burksbuilds/CNC-Router/Renders/2022-01-19/CNC-ISO2.png

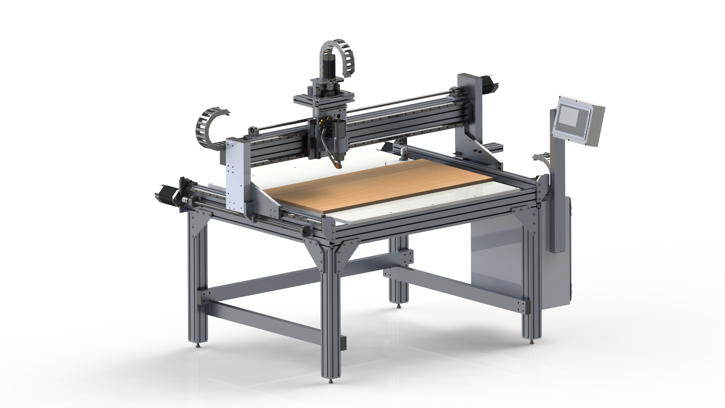
Renders/2022-01-19/CNC-ISO2.png
