burksbuilds/CNC-Router/Controls/Controls Scratchpad.pptx

## Plan

- Major Component Selection / Requirements
- Circuit Protection / High Level Schematic
- Safety Third (E-Stop)
- Heat Calcs / Cooling
- Detailed Power Distro and Terminals
- Layout

## Major Component Selection / Requirements

- Power Supplies
  - Requirement: 25A at 72VDC
    - Why? Steppers need 72VDC 5A each (Four required, fifth planned spare)
    - Planning on 3x 24VDC power supplies in series
      - PSP-600-24 good price per amp and not too inefficient
  - Requirement: 5A + 3A at 24VDC
    - Why? Controller needs 2 separate 24VDC 3A power supplies (Logic and IO separate)
    - Why? 24VDC relay to turn on/off air solenoid from output (2 relays 1A each at 24VDC should be plenty)
    - Planning on 2x 24VDC power supplies (one for IO and one for Logic+Relays)
      - EDR-150-24 is 6.5A, so plenty of current and cost different up from 4A only $1

## Circuit Protection / High Level Schematic

30A house breaker (10 awg) 240V

Disconnect (32A)
466150 (https://www.alliedelec.com/product/rs-pro-by-allied/466150/70822676/)

10

10

10

15A breaker
2907662 (https://www.phoenixcontact.com/online/portal/us/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)
faz-d15-2-na-l (https://www.automationdirect.com/adc/shopping/catalog/circuit_protection_-z-_fuses_-z-_disconnects/ul_489_miniature_circuit_breakers/eaton_240vac_miniature_ci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)

6-16A breaker
(10A 2907591 (https://www.phoenixcontact.com/online/portal/us/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)
faz-c10-2-na-l (https://www.automationdirect.com/adc/shopping/catalog/circuit_protection_-z-_fuses_-z-_disconnects/ul_489_miniature_circuit_breakers/eaton_240vac_miniature_ci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))

10-16A breaker
(15A 2907594 (https://www.phoenixcontact.com/online/portal/us/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)
16A GMCBU-2C-16 (https://www.automationdirect.com/adc/shopping/catalog/circuit_protection_-z-_fuses_-z-_disconnects/ul_489_miniature_circuit_breakers/gladiator_miniature_circu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))

14

Spindle VFD

3 hp spindle (9.6 FLA)

18

14

24V 6A Power Supply

24V 6A Power Supply

Input Power (3A CB) gmcb-1c-3 (https://www.automationdirect.com/adc/shopping/catalog/circuit_protection_-z-_fuses_-z-_disconnects/ul_1077_supplementary_protectors/gladiator_ul_1077_suppleme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)

Stepper Drives (72V)
USCC1 (https://www.grainger.com/product/MERSEN-Finger-Safe-Fuse-Block-4ZCP6) for CC fuses
Class G fuse terminal blocks
1044423 (https://www.phoenixcontact.com/online/portal/us/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) with jumper (https://www.phoenixcontact.com/online/portal/us/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)
6A FUSE (https://www.alliedelec.com/product/littelfuse/ag6/70347898/)

Control Power (3A CB x2) gmcb-1c-3 (https://www.automationdirect.com/adc/shopping/catalog/circuit_protection_-z-_fuses_-z-_disconnects/ul_1077_supplementary_protectors/gladiator_ul_1077_suppleme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)

10

14 / 10?

24V 25A Power Supply

24V 25A Power Supply

24V 25A Power Supply

## Safety Third (E-Stop)

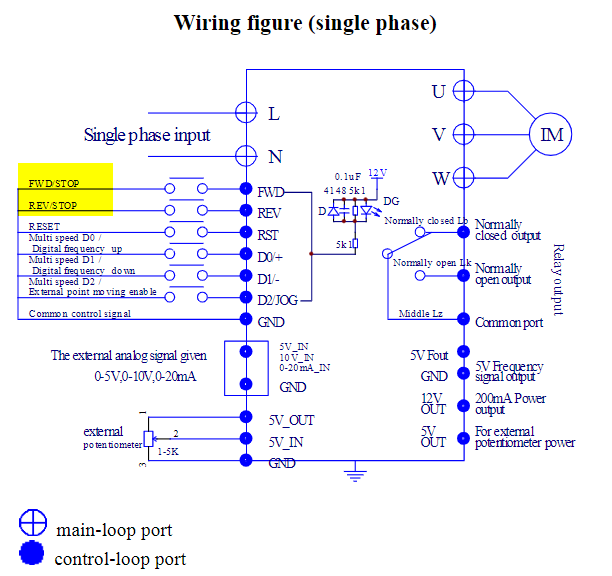
[picture p2: figure]

- Controller EStop is software (does not have an estop output), so you don’t directly know when it's buttons are pressed
- What should estop do?
  - Stop spindle, stop servos
  - Remote estop input for controller
- VFD has estop input
- Big power supplies have a jumper that you can remove to turn them off

## Heat Calcs / Cooling

- Max temp things are okay with:
  - VFD: 40C
  - Power supplies: 60C
  - Drives: 50C
- Summary
  - 620W of heat to dissipate
  - 600x600x300 cabinet (dissipates ~65W, calc has a 250mm depth cabinet)
  - Assumption: Max internal temp 40C, max external temp 30C, altitude 250-499m, Single enclosure, free-standing on all sides
  - Necessary air throughput: 185 m3/h

## Detailed Power Distro and Terminals

## Layout

Y2

Y1

Y2 0

Y1 0

X0

Y+

Y-

prox

slot

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
## Slide 9
