burksbuilds/CNC-Router/Controls/CNC_electrical.xlsx

Sheet: Sheet1
 |  |  |  | Heat | PXC |  |  |  | HRP-600-24 | 3.6 | 240 | 105 | 63.5
24V Power Supply | EDR-150-24 | Input 1.7A/230V | Output 6.5A/24V | 20.28 | 10 | 6-16A breaker | 2 | 40.56 | PSP-600-24 | 3.4 | 185 | 120 | 93
Motor Power Supplies | PSP-600-24 | Input 3.4A/230V | Output 25A/24V | 84 | 28 | 10-16A | 3 | 252 | SE-600-24 | 7.5 | 264 | 127 | 50
Stepper Driver | CL86T(V3.0) |  |  | 12.96 |  |  | 5 | 64.8
 | VFD |  |  | 260.995 |  |  | 1 | 260.995
 |  |  |  |  |  |  |  | 618.355
 |  |  |  |  | 679
 |  |  |  |  |  |  |  |  |  |  |  |  |  | AWG | Current
 |  |  |  |  |  |  |  |  |  |  |  |  |  | 20 | 5
 |  |  |  |  |  |  |  |  |  |  |  |  |  | 18 | 7
32A Disconnect |  | RS Pro by Allied - 466150 - Disconnect Switch Non-Fused 32A 750VAC IP65 3 Pole Panel Mount UL508 CSA - Allied Electronics & Automation (https://www.alliedelec.com/product/rs-pro-by-allied/466150/70822676/) |  |  |  |  |  |  |  |  |  |  |  | 16 | 10
 |  |  |  |  |  |  |  |  |  |  |  |  |  | 14 | 15
 |  |  |  |  |  |  |  |  |  |  |  |  |  | 12 | 20
 |  |  |  |  |  |  |  |  |  |  |  |  |  | 10 | 30
Spindle 3hp | 9.6A FLA | 20A breaker

Sheet: BOM Cost Est
Disconnect | Allied |  | RS Pro by Allied - 466150 - Disconnect Switch Non-Fused 32A 750VAC IP65 3 Pole Panel Mount UL508 CSA - Allied Electronics & Automation (https://www.alliedelec.com/product/rs-pro-by-allied/466150/70822676/) | 1 | 20.48 | 20.48
TMC82C 15A | Allied | gmcbu-2c-15 | https://www.alliedelec.com/phoenixcontact-2907594/70903630/ | 2 | 40.85 | 81.7 |  | Fuse | 1 | 2907594 | 2
TMC82C 10A | Automation Direct | gmcbu-2c-10 | https://www.automationdirect.com/adc/shopping/catalog/circuit_protection_-z-_fuses_-z-_disconnects/ul_489_miniature_circuit_breakers/gladiator_miniature_circu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 | 1 | 26 | 26 |  |  |  | 2907591 | 1
Fuse Terminal 1044423 | Allied/Mouser |  |  | 5 | 11.28 | 56.4 | or digikey CYDLF4 |  |  | 1044423 | 5
Terminal Jumper 3001596 | Allied |  |  | 1 | 2.39 | 2.39 |  |  |  | 3001596 | 1
Terminal Jumper 3030349 | Allied |  |  | 1 | 2.94 | 2.94 |  |  |  | 3030349 | 1
Fuses 6A G Class | digikey, mouser | 0487008.MXP |  |  | 1.26 | 0
25A Power supply | TRC |  | https://www.trcelectronics.com/View/Mean-Well/PSP-600-24.shtml | 3 | 151 | 453
6A Power Supply | TRC |  | https://www.trcelectronics.com/View/Mean-Well/EDR-150-24.shtml | 2 | 31.4 | 62.8
3A CBs | Automation Direct | GMCB-1C-3 | https://www.automationdirect.com/adc/shopping/catalog/circuit_protection_-z-_fuses_-z-_disconnects/ul_1077_supplementary_protectors/gladiator_ul_1077_suppleme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 | 3 | 7 | 21
Filter | Automation Direct | res10f10 | https://www.automationdirect.com/adc/shopping/catalog/power_products_(electrical)/power_line_filters/roxburgh_1-phase_general_purpose_power_line_emi_-z-_rf_fi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 | 1 | 14 | 14
Cable Entry | Allied, digikey, mouser | 1415240 |  | 1 | 20 | 20
Rail |  |  |  | 1 | 5.8 | 5.8
Duct |  |  |  | 1 | 28 | 28
 |  |  |  |  |  | 794.51

Sheet: POs
TRC Electronics | 536.83
Allied | 134.32
Automation Direct | 174.27
Digikey | 123.23
Vevor/Walmart | 200
AliExpress | 50 | ?
Amazon | 99.63 | (including crimp tool/ferrules)
McMaster | 101.6
Amazon VFD | 134
 | 1553.88

Sheet: IO
Inputs | Enable | Pin | Polarity |  |  | Num Wires | Outputs | Enable | Pin | Polarity
X-axis servo alarm signal | 1 | 1 |  | Limit Switches | 10 | 3 | Spindle forward rotation control signal | 1 |  |  | M8/M89 | Coolant andvacuum relays
Y-axis servo alarm signal | 1 | 2 |  | Servo Alarm | 5 | 2 | Spindle reverse rotation control signal |  |  |  | M10/M11
Z-axis servo alarm signal | 1 | 3 |  | Spindle Alarm | 1 |  | Spindle section speed 1 |  |  |  | Might need system ready to sent to drives for enable
Spindle alarm signal | 1 | 4 |  | Fixed Probe | 1 |  | Spindle section speed 2 |  |  |  | gantry homing thing
5th-axis servo alarm signal |  |  |  | Floating Probe | 1 |  | Spindle section speed 3
Negative X-axis hard limit signal | 1 | 5 |  | Tool Changer | 4 |  | M8/M9 control signal (coolant)
Negative Y-axis hard limit signal | 1 | 6 |  | Estop | 1 |  | M10/M11 control signal
Negative Z-axis hard limit signal | 1 | 7 |  |  |  |  | System alarm signal
Negative 4th-axis hard limit signal |  |  |  |  |  |  | System Running signal
Negative 5th-axis hard limit signal |  |  |  |  | 23 |  | System Brake signal
Positive X-axis hard limit signal | 1 | 8 |  |  |  |  | System ready signal | 1
Positive Y-axis hard limit signal | 1 | 9 |  |  |  |  | Tool release/lock signal (M154/M155) | 1
Positive Z-axis hard limit signal | 1 | 10 |  |  |  |  | Tool lauch/retract signal (M152/M153) | 1
Positive 4th-axis hard limit signal |  |  |  |  |  |  | Front positioning/off signal (M156/M157)
Positive 5th-axis hard limit signal |  |  |  |  |  |  | Vacuum pump on/off output signal (M158/M159)
X-axis Zero Signal | 1 | 11 |  |  |  |  | Dust cover open/close output signal (M150/M151)
Y-axis Zero Signal | 1 | 12 |  |  |  |  | Push cylinder open/close output signal (M160/M161)
Z-axis Zero Signal | 1 | 13 |  |  |  |  | Vacuum cleaner on/off output signal (M162/M163) | 1
4th-axis Zero Signal | 1 | ? |  |  |  |  | Left positioning on/off output signal (M164/M165)
5th-axis Zero Signal |  |  |  |  |  |  | Vacuum valve open/close output signal (M166/M167)
Floating Probe signal | 1 | 14 |  |  |  |  | Multi-process 1 Open/close output signal (M168/M169) | 1
Fixed Probe signal | 1 | 15 |  |  |  |  | Multi-process 2 Open/close output signal (M170/M171)
External key 1 |  |  |  |  |  |  | Multi-process 3 Open/close output signal (M172/M173)
External key 2 |  |  |  |  |  |  | Multi-process 4 Open/close output signal (M174/M175)
External key 3 |  |  |  |  |  |  | Cooling 1 on/off output signal (M176/M177) | 1
External key 4 |  |  |  |  |  |  | Cooling 1 on/off output signal (M178/M179)
External key 5
External key 6
External Start |  |  |  |  |  |  |  | 7
External Pause
External Estop | 1 | 24
Spindle Stop Signal (M300) |  | 16
Tool release input signal (M301) | 1 | 17
Tool lock input signal (M302) | 1 | 18
Tool open input signal (M303) | 1 | 19
Dust cover open/close input signal (M305/M306)
Inverter Alarm input signal
Customs alarm input signal 1 | 1 | ?
Customs alarm input signal 2
Customs alarm input signal 3
Customs alarm input signal 4
Customs alarm input signal 5
Tool close input signal (M304) | 1 | 20
 | 22

Sheet: PXC
 | PN | ALT | QTY
Din Rail | 1207658 |  | 1 | https://www.phoenixcontact.com/online/portal/us/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
Cable Gland | 1415240 |  | 1 | https://www.phoenixcontact.com/online/portal/us/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
Duct 40mmx80 | 3240626 |  | 1 | https://www.phoenixcontact.com/online/portal/us/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
Duct 40mmx100 | 3240627 |  | 1 | 3240627 (https://www.phoenixcontact.com/online/portal/us/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)
Duct Cover | 3240647 |  | 1 | https://www.phoenixcontact.com/online/portal/us/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
Duct 60mmx80 | 3240630 |  | 1 | 3240630 (https://www.phoenixcontact.com/online/portal/us/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)
Duct 60mmx100 | 3240631 |  | 1 | 3240631 (https://www.phoenixcontact.com/online/portal/us/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)
Duct Cover | 3240648 |  | 1 | PHOENIX CONTACT | Cable duct - CD 60X80 WH - 3240630 (https://www.phoenixcontact.com/online/portal/us/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)
2 level tb | 3214657 | 3208511 | 20 | https://www.phoenixcontact.com/online/portal/us/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
2 level cover | 3214699 | 3208579 | 1 | https://www.phoenixcontact.com/online/portal/us/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
3 level tb | 3213726 | 3213713 | 10 | https://www.phoenixcontact.com/online/portal/us/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
3 level cover | 3113771 |  | 1 | https://www.phoenixcontact.com/online/portal/us/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
10jumper | 3213056 |  | 2 | https://www.phoenixcontact.com/online/portal/us/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
20jumper | 3213069 |  | 1 | https://www.phoenixcontact.com/online/portal/us/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
Fuse TB | 1044423 |  | 5 | PHOENIX CONTACT | Fuse modular terminal block - UT 4-L/HESI (5X20) GY - 1044423 (https://www.phoenixcontact.com/online/portal/us/pxc/offcontext/search_result_page/!ut/p/z1/5Vhbb9owFP4r9IFHYyeOEzJpD0DRWgot163hJXIch3rLbYmhW3_9HEi1pltJtQpNapC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)
Fuse TB jumpers | 3001596 |  | 5 | https://www.phoenixcontact.com/online/portal/us/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
Fuse TB jumpers | 3030349 |  | 5 | https://www.phoenixcontact.com/online/portal/us/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
TMC 82C 15A | 2907594 |  | 2 | https://www.phoenixcontact.com/online/portal/us/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
TMC 82C 10A | 2907591 |  | 1 | PHOENIX CONTACT | Thermomagnetic device circuit breaker - TMC 82C 10A - 2907591 (https://www.phoenixcontact.com/online/portal/us/pxc/offcontext/search_result_page/!ut/p/z1/5VjJcuIwEP0V5sBpSkiyvHFkG5YAYZ1gLi7Zlokm3mIbkvD1IwOphEwwqVAcpkypylq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)
TMC 71C 3A | 1019974 |  | 3 | 1019974 (https://www.phoenixcontact.com/online/portal/us/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)
gnd quattro | 3211809 |  | 4 | https://www.phoenixcontact.com/online/portal/us/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
quattro end cover | 3208979 |  | 2 | https://www.phoenixcontact.com/online/portal/us/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
0v distro | 1046949 |  | 1 | https://www.phoenixcontact.com/online/portal/us/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
3210596 (https://www.phoenixcontact.com/online/portal/us/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)

Sheet: Wire
 |  |  | OD | FT (MIN) | PPF
Power Cable 10-3 | Automation Direct | SJEOOW |  | 20 | 1.79 | 35.8 |  | AWG | Color | Quantity
Power Cable 10-3 | McMaster | SJEOOW | 0.57" | 10 | 2.6 | 26 |  | 10 | Black | 6
 |  |  |  |  |  | 0 |  |  | Green | 2
10AWG Black | McMaster | THHN |  | 10 | 0.53 | 5.3 |  |  | Blue | 3
 | McMaster | MTW |  | 10 | 0.64 | 6.4 |  |  | White/Blue | 2
 | Grainger | THHN |  | 50 | 0.6024 | 30.12 |  | 14 | Black | 14
 | Grainger | MTW |  | 500 | 0.4 | 200 |  |  | Green | 10
 | Automation Direct | THHN |  | 500 | 0.498 | 249 |  |  | Blue | 10
 | Lowes/Home Depot | THHN |  | 500 | 0.278 | 139 |  |  | White/Blue | 10
 |  |  |  | 100 | 0.5128 | 51.28 | (have some smaller lengths too 50ft / $27) | 18 | Blue | 45
 |  |  |  |  |  |  |  |  | WhiteBlue | 45
Ground bar | EC3GB212
18AWG Wire Blue | McMaster | MTW |  | 25 | 0.19 | 4.75
 | Grainger | MTW |  | 500 | 0.11486 | 57.43
 |  |  | 300V | 100 | 0.3039 | 30.39
 | Allied | MTW |  | 100 | 0.3625 | 0.3625

Sheet: Cable
Cables HMI to Cabinet | Num Conductors | AWG | OD (in) | OD (mm) | PN
Inputs | 25 | 20 | 0.498 | 12.6492 | CC600-20-25U-1 (https://www.automationdirect.com/adc/shopping/catalog/cables/bulk_multi-conductor_cable/600v_control_cable/cc600-20-25u-1)
Outputs | 12 | 20 | 0.33 | 8.382 | CF880-05-12 (https://www.igus.com/search?q=CF880-05-12)
Power and Ground | 5 | 20 | 0.26 | 6.604 | CF880-05-05 (https://www.igus.com/search?q=CF880-05-05)
Drives (5) | 4 | 24 | 0.235 | 5.969 | Q8504-1 (https://www.automationdirect.com/adc/shopping/catalog/cables/bulk_multi-conductor_cable/rs-485_-a-_rs-422-z-rs-232_cable/q8504-1)
VFD | 7 | 18 | 0.321 | 8.1534 | CC600-18-7S-1 (https://www.automationdirect.com/adc/shopping/catalog/cables/bulk_multi-conductor_cable/600v_control_cable/cc600-18-7s-1)
VFD to Spindle | 4 | 16 | 0.39 | 9.906 | CF270-UL-D (https://www.igus.com/product?artNr=CF270-UL-15-04-D)
Power Cable 10-3 | 3 | 10 | 0.57 | 14.478
Cables from Machine | Qty Cables |  | OD (in) | OD (mm)
CN-14A-R-C5, home | 3 |  | 0.1456692913 | 3.7
CN-14A-C2 | 1 |  | 0.1456692913 | 3.7
motor | 5 |  | 0.275 | 6.985
encoder | 5 |  | 0.25 | 6.35
limit switches | 6
relay stuff | 6
 | 26
