burksbuilds/CNC-Router/Model/Solidworks CAD and Drawings/CNCR-SPIN.SLDASM

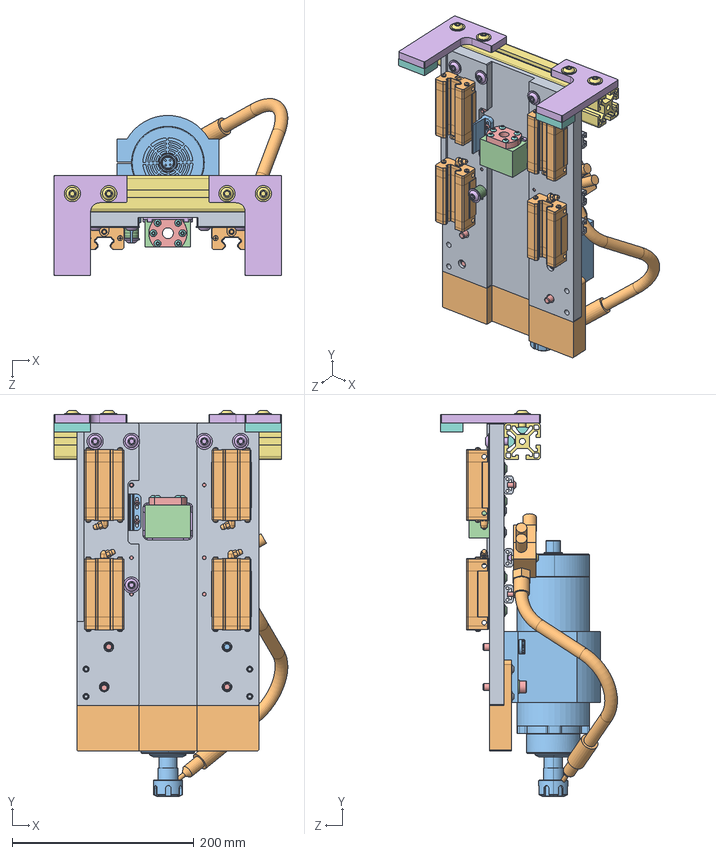
[picture p23: CAD file, 2022-09-07]
Model/Solidworks CAD and Drawings/CNCR-SPIN.SLDASM
256.8 x 424.4 x 194.6 mm
CNCR-SPIN-PLATE
BEARING20 x 4
CNCR-SPIN-CLAMP
BALLNUT12-MOUNT
BALLNUT1204
CNCR-SPIN-HS x 2
CNCR-SPIN-TSE-HSM
CNCR-BUMP x 2
CNCR-SPIN-TSE-AM x 3
CNCR-SPIND-COOL
SPINDLE80
M6x20mm FBHCS x 16
M5x25mm BHCS, 18-8 - 92095A216 x 6
M8x25mm-FBHCS x 5
M8x20mm-FBHCS x 4
M8-TSN40-BALL x 8
M8-M12-INSERT x 5
M8-ENUT
M8-SHLD10x16
M8-WASHER x 11
M8x40mm SHCS, 18-8 - 91292A152 x 3
M5-TSN20-BALL x 2
M5x30mm BHCS, 18-8 - 92095A218 x 2
M4x12mm BHCS x 6
M5x16mm Flanged BHCS, 18-8 - 97654A663 x 8
CNCR-SPIN-SPE
CNCR-HSF
M5-M8-INSERT x 4
M3x12mm-BHCS x 2
CNCR-SPIN-BNM
