burksbuilds/CNC-Router/Model/Solidworks CAD and Drawings/CNCR-STAND.SLDASM

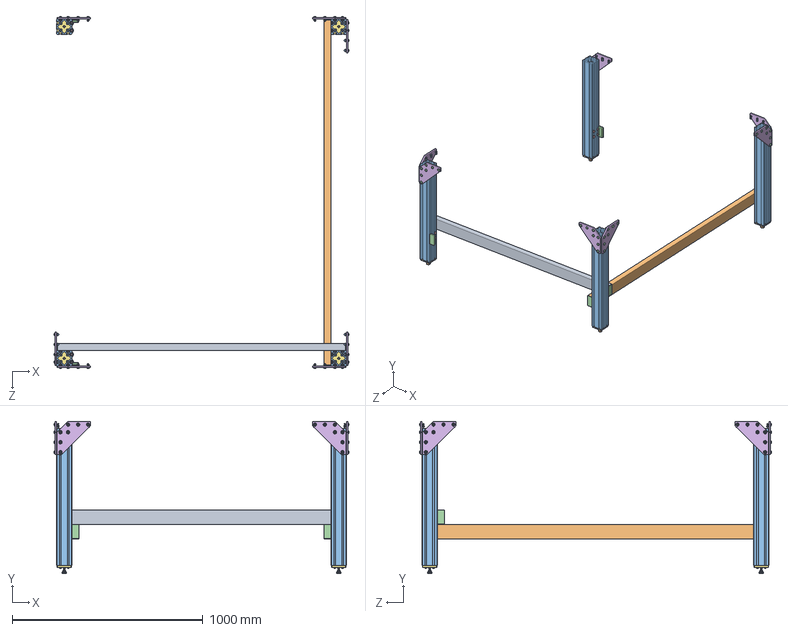
[picture p24: CAD file, 2022-09-07]
Model/Solidworks CAD and Drawings/CNCR-STAND.SLDASM
1547.8 x 800.0 x 1847.8 mm
CNCR-STAND-BS
CNCR-STAND-SS
M8-TSN40-BALL x 73
M8x20mm-FBHCS x 49
M8x12mm-FBHCS x 24
CNCR-STAND-GP x 7
CNCR-STAND-FP x 4
M8-M12-INSERT x 4
M8x25mm-FBHCS x 16
M8-FOOT x 4
CNCR-STAND-TSE-LEG x 4
BOXCOV-3x1,5 x 6
