burksbuilds/CNC-Router/Model/Solidworks CAD and Drawings/CNCR-ELEC-ENC.SLDASM

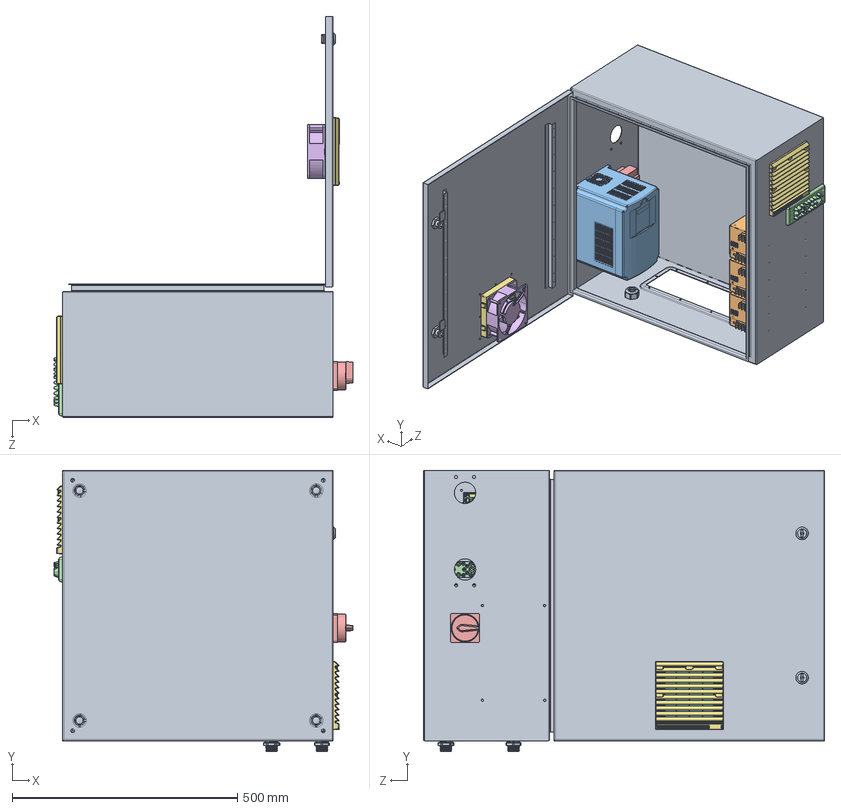
[picture p25: CAD file, 2022-09-07]
Model/Solidworks CAD and Drawings/CNCR-ELEC-ENC.SLDASM
663.2 x 624.3 x 890.0 mm
CNCR-ELEC-BOX
POWER-24VDC-600W x 3
VFD-5HP
CABLE-GLAND25
Disconnect
FAN120
FAN120-FILTER x 2
FAN120-FILTER45 x 2
CORDGRIP-075NPT x 2
