burksbuilds/CNC-Router/Model/Solidworks CAD and Drawings/CNCR-ELEC-COL.SLDASM

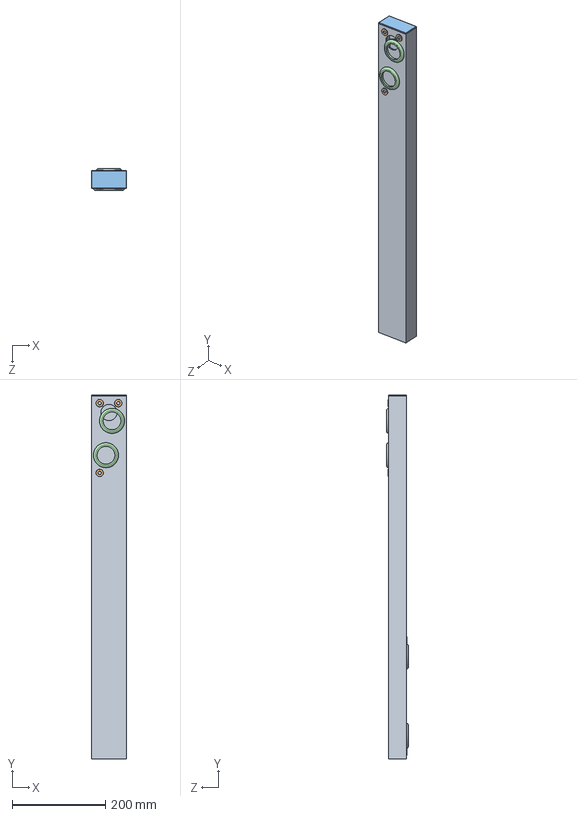
[picture p26: CAD file, 2022-09-07]
Model/Solidworks CAD and Drawings/CNCR-ELEC-COL.SLDASM
76.2 x 782.5 x 47.6 mm
CNCR-ELEC-COL-RT
M6-RIVNUT x 7
BOXCOV-3x1,5
1-50ID Grommet x 4
