burksbuilds/CNC-Router/Model/Solidworks CAD and Drawings/CNCR-GANT-COL-CABLE.SLDASM

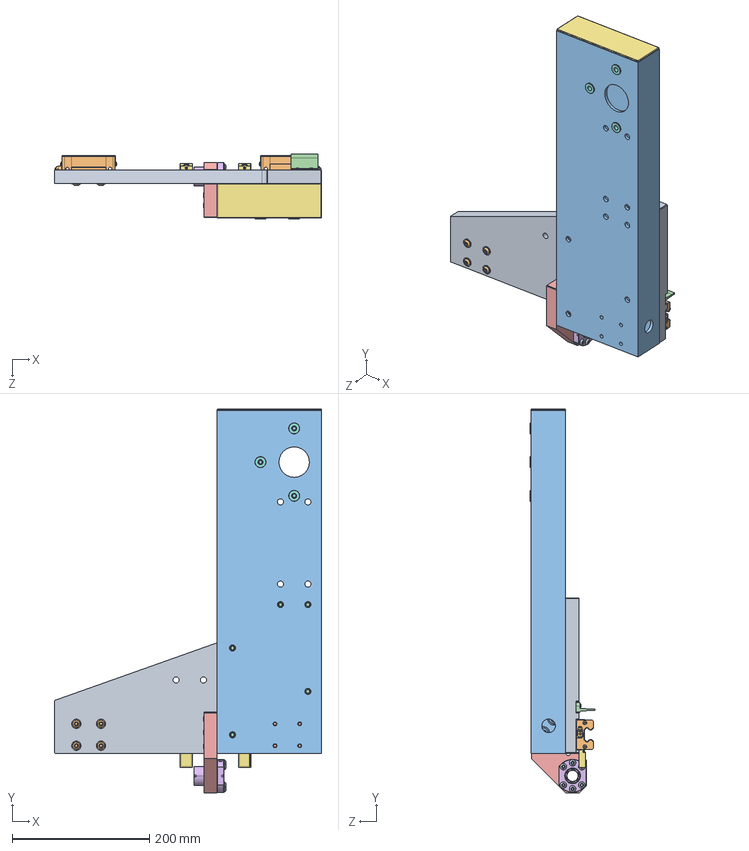
[picture p27: CAD file, 2022-08-01]
Model/Solidworks CAD and Drawings/CNCR-GANT-COL-CABLE.SLDASM
390.0 x 560.5 x 95.4 mm
CNCR-GANT-RP
BEARING20 x 2
CNCR-GANT-RT
CNCR-HSF
CNCR-GANT-BNM
BALLNUT1610
BOXCOV-6x2
M6-RIVNUT x 3
M5x25mm BHCS, 18-8 - 92095A216 x 6
M6x20mm FBHCS x 4
M8x25mm-FBHCS x 3
M8x20mm-FBHCS x 5
M6x25mm FBHCS x 4
M3x12mm-BHCS x 2
PROX-FLAT18 x 2
