burksbuilds/CNC-Router/Model/Solidworks CAD and Drawings/Circuit Breaker, 2 Pole.SLDASM

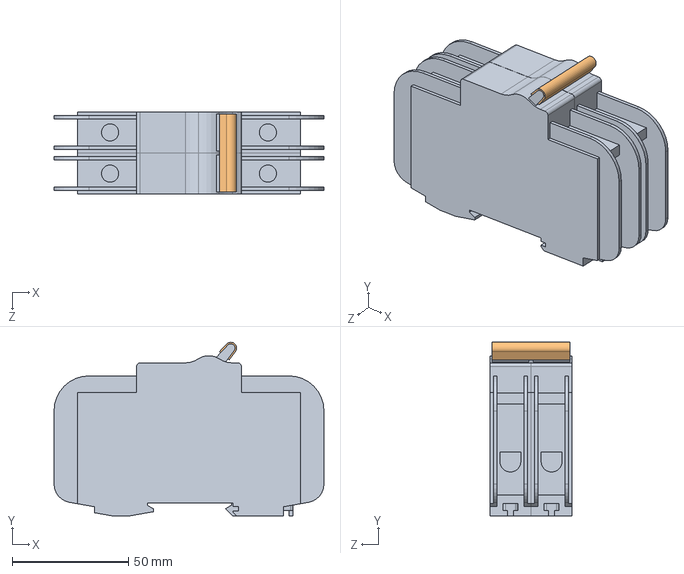
[picture p28: CAD file, 2022-08-01]
Model/Solidworks CAD and Drawings/Circuit Breaker, 2 Pole.SLDASM
116.0 x 74.6 x 35.3 mm
DUMMY_4230_1POLIG_UL489.stp x 2
DUMMY_4230_VERB_2POLIG.stp
