burksbuilds/CNC-Router/Model/Solidworks CAD and Drawings/CNCR-GANT-COL-FREE.SLDASM

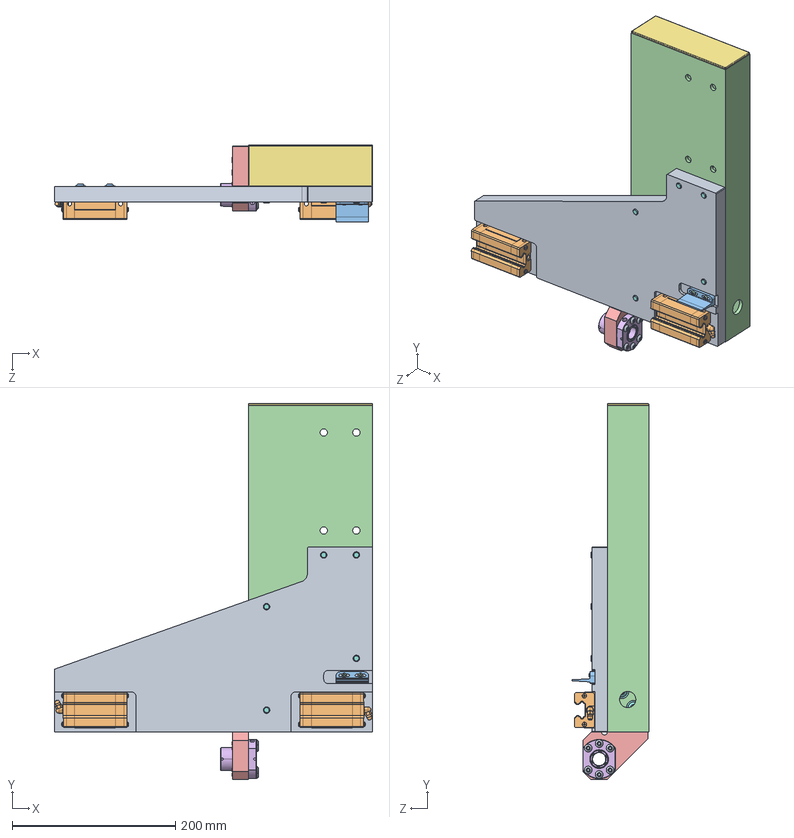
[picture p29: CAD file, 2022-08-01]
Model/Solidworks CAD and Drawings/CNCR-GANT-COL-FREE.SLDASM
390.0 x 460.5 x 93.8 mm
CNCR-GANT-RP
BEARING20 x 2
CNCR-HSF
CNCR-GANT-RT
CNCR-GANT-BNM
BALLNUT1610
BOXCOV-6x2
M8x25mm-FBHCS x 8
M5x30mm BHCS, 18-8 - 92095A218 x 6
M6x25mm FBHCS x 4
M6x20mm FBHCS x 4
M3x12mm-BHCS x 2
