burksbuilds/CNC-Router/Model/Solidworks CAD and Drawings/CNCR-VACT-DUCT.SLDASM

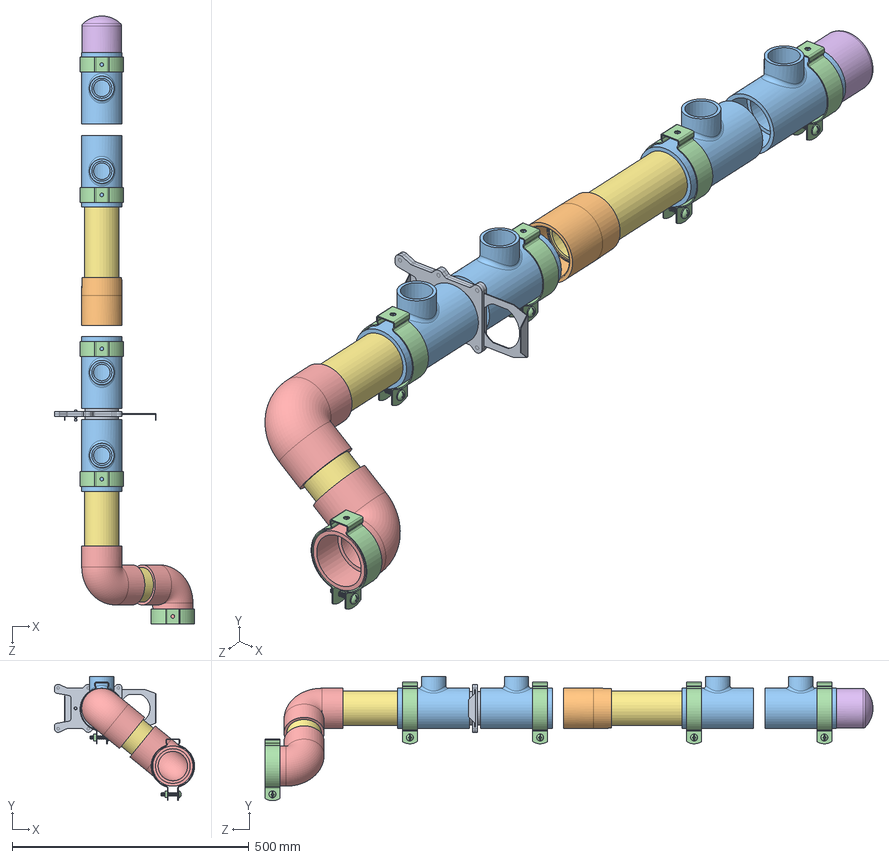
[picture p30: CAD file, 2022-03-06]
Model/Solidworks CAD and Drawings/CNCR-VACT-DUCT.SLDASM
296.0 x 262.4 x 1283.5 mm
3in Blast Gate - 17385K72
2-5in Coupler - 4880K133
2-5in to 1-25 Reducing Tee - 4880K979 x 4
3in Pipe Hanger - 3006T84 x 5
2-5in Elbow - 4880K103 x 2
2-5in Cap - 4880K143
2-5in PVC Pipe, Schedule 40 x 4
