burksbuilds/CNC-Router/Model/Solidworks CAD and Drawings/Reference Piston.SLDASM

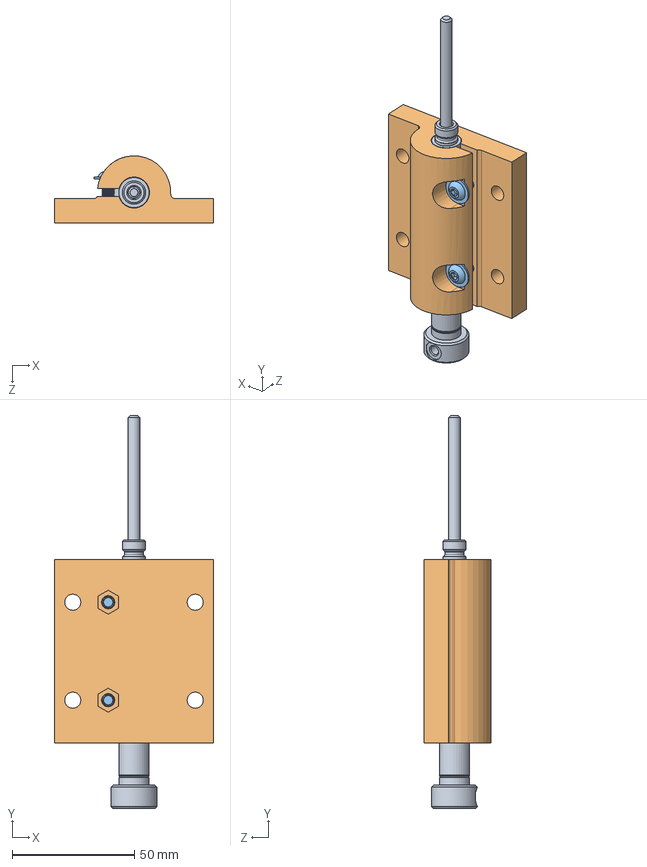
[picture p31: CAD file, 2022-03-06]
Model/Solidworks CAD and Drawings/Reference Piston.SLDASM
65.0 x 160.5 x 27.5 mm
0-7-16 x 1-5in Single Acting Cylinder - Bimba 0115_NTQ
Cylinder Mount
M5x16mm Flanged BHCS, 18-8 - 97654A663 x 2
