burksbuilds/CNC-Router/Model/Solidworks CAD and Drawings/VFD-3HP.SLDPRT

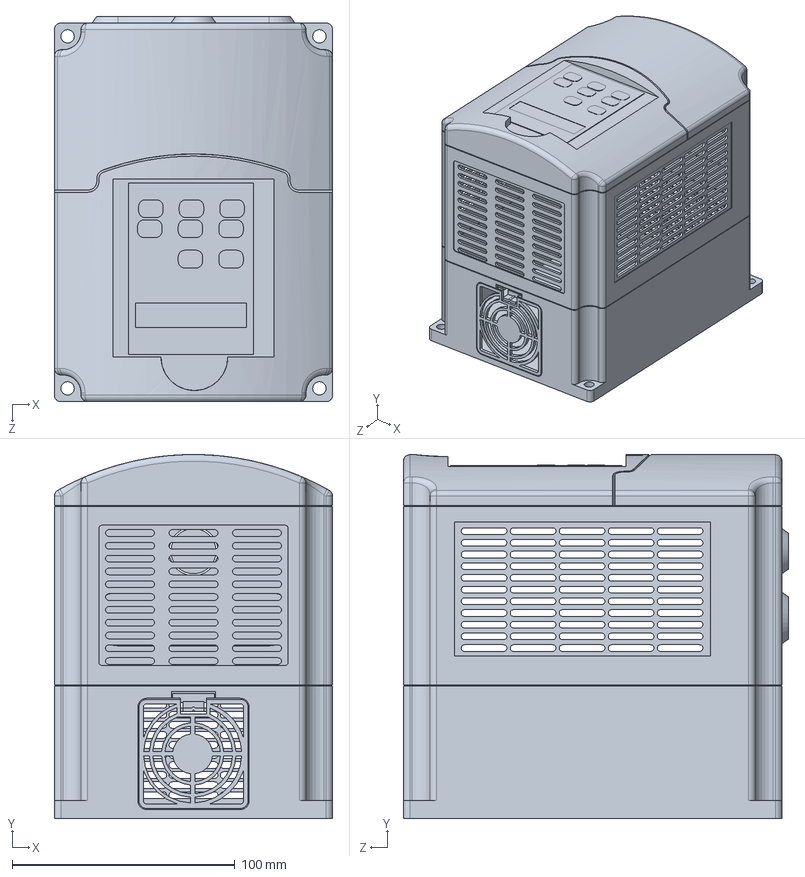
[picture p32: CAD file, 2022-09-07]
Model/Solidworks CAD and Drawings/VFD-3HP.SLDPRT
125.0 x 163.4 x 173.0 mm
