burksbuilds/CNC-Router/Model/Solidworks CAD and Drawings/CNCR-ELEC-HMI.SLDPRT

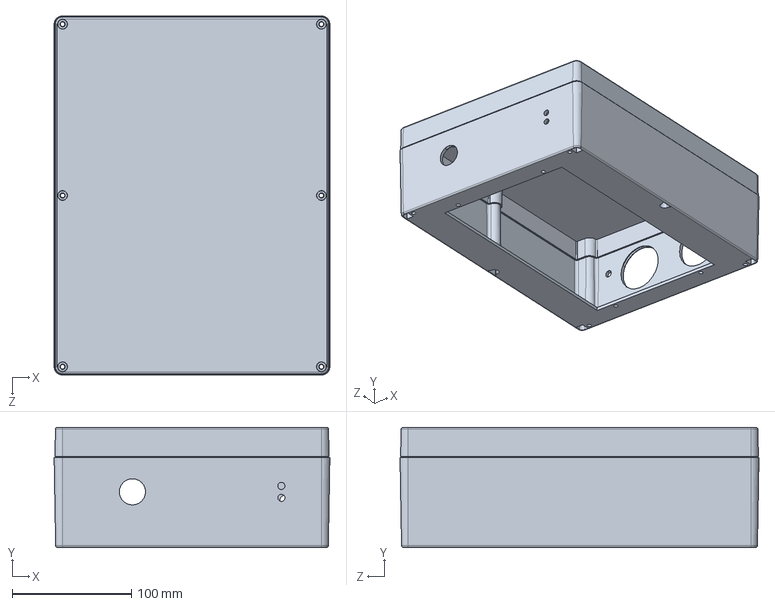
[picture p33: CAD file, 2022-09-07]
Model/Solidworks CAD and Drawings/CNCR-ELEC-HMI.SLDPRT
231.5 x 100.8 x 301.3 mm
