burksbuilds/CNC-Router/Model/Solidworks CAD and Drawings/CNCR-ELEC-COL-RT.SLDPRT

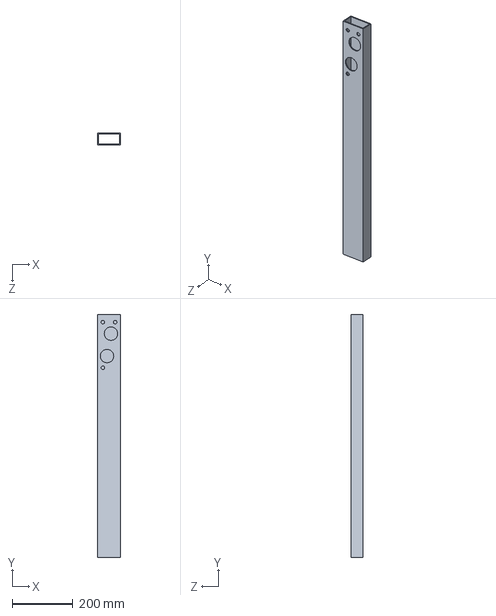
[picture p34: CAD file, 2022-09-07]
Model/Solidworks CAD and Drawings/CNCR-ELEC-COL-RT.SLDPRT
76.2 x 800.0 x 38.1 mm
