burksbuilds/CNC-Router/Model/Solidworks CAD and Drawings/CORDGRIP-075NPT.SLDPRT

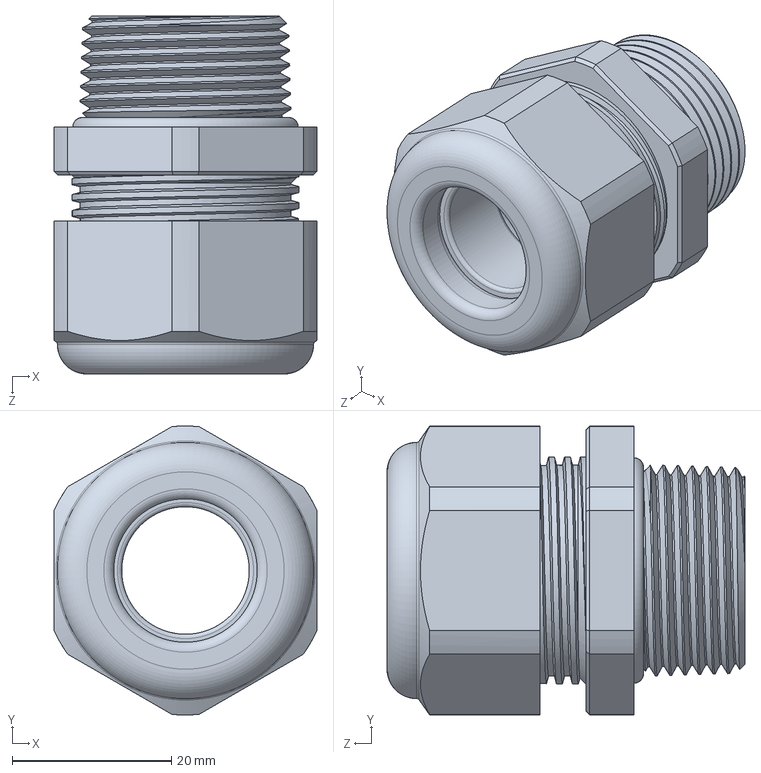
[picture p35: CAD file, 2022-09-07]
Model/Solidworks CAD and Drawings/CORDGRIP-075NPT.SLDPRT
33.0 x 36.3 x 45.0 mm
