burksbuilds/CNC-Router/Model/Solidworks CAD and Drawings/CNCR-ELEC-BOX.SLDPRT

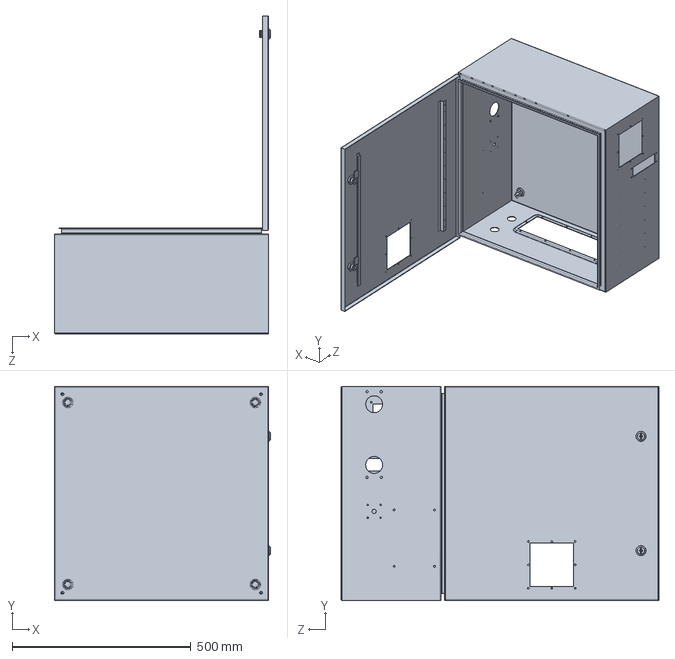
[picture p36: CAD file, 2022-09-07]
Model/Solidworks CAD and Drawings/CNCR-ELEC-BOX.SLDPRT
605.0 x 600.0 x 890.0 mm
