burksbuilds/CNC-Router/Model/Solidworks CAD and Drawings/FAN120-FILTER.SLDPRT

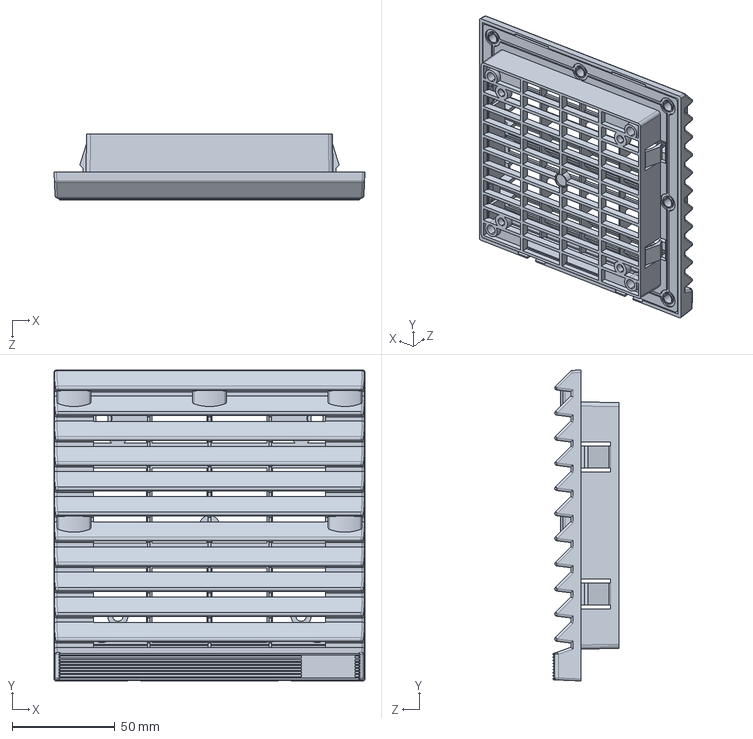
[picture p37: CAD file, 2022-09-07]
Model/Solidworks CAD and Drawings/FAN120-FILTER.SLDPRT
151.0 x 151.0 x 32.0 mm
