burksbuilds/CNC-Router/Model/Solidworks CAD and Drawings/EStop-22.SLDPRT

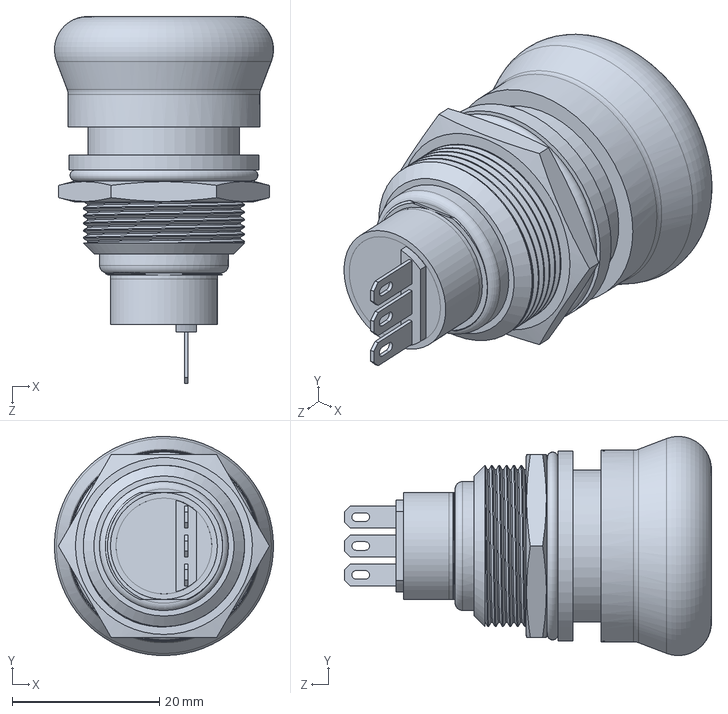
[picture p38: CAD file, 2022-09-07]
Model/Solidworks CAD and Drawings/EStop-22.SLDPRT
29.7 x 29.7 x 49.8 mm
