burksbuilds/CNC-Router/Model/Solidworks CAD and Drawings/BALLNUT1610.SLDPRT

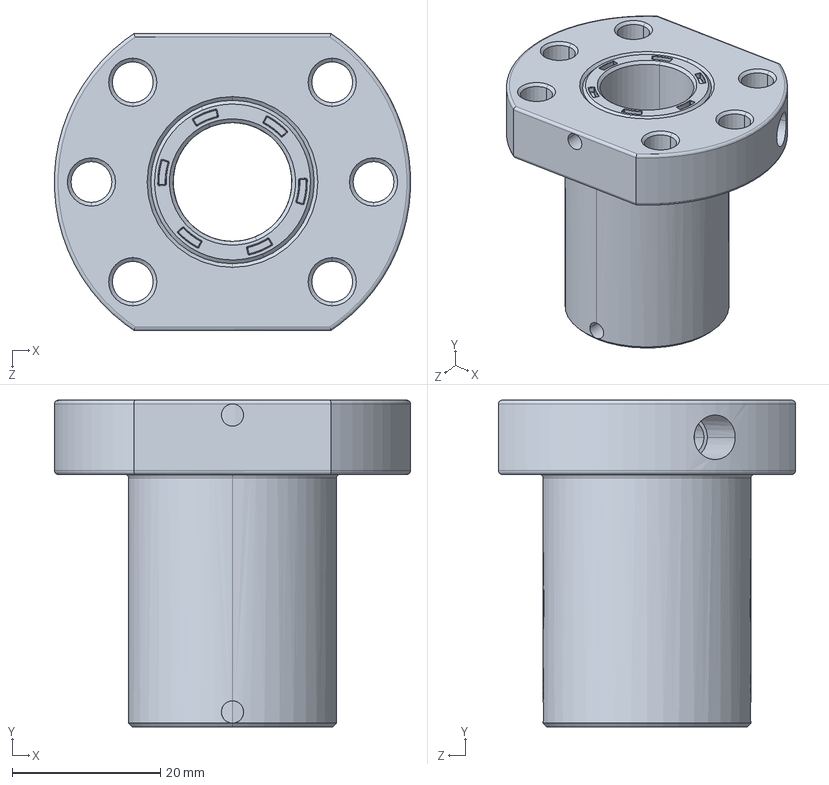
[picture p39: CAD file, 2022-08-01]
Model/Solidworks CAD and Drawings/BALLNUT1610.SLDPRT
48.0 x 44.0 x 40.0 mm
