burksbuilds/CNC-Router/Model/Solidworks CAD and Drawings/LS-TB-Y.SLDPRT

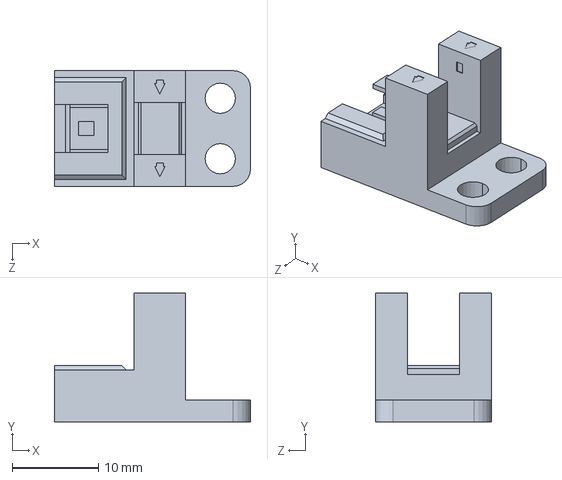
[picture p40: CAD file, 2022-08-01]
Model/Solidworks CAD and Drawings/LS-TB-Y.SLDPRT
22.7 x 14.9 x 13.4 mm
