burksbuilds/CNC-Router/Model/Solidworks CAD and Drawings/EMI-FILT10.SLDPRT

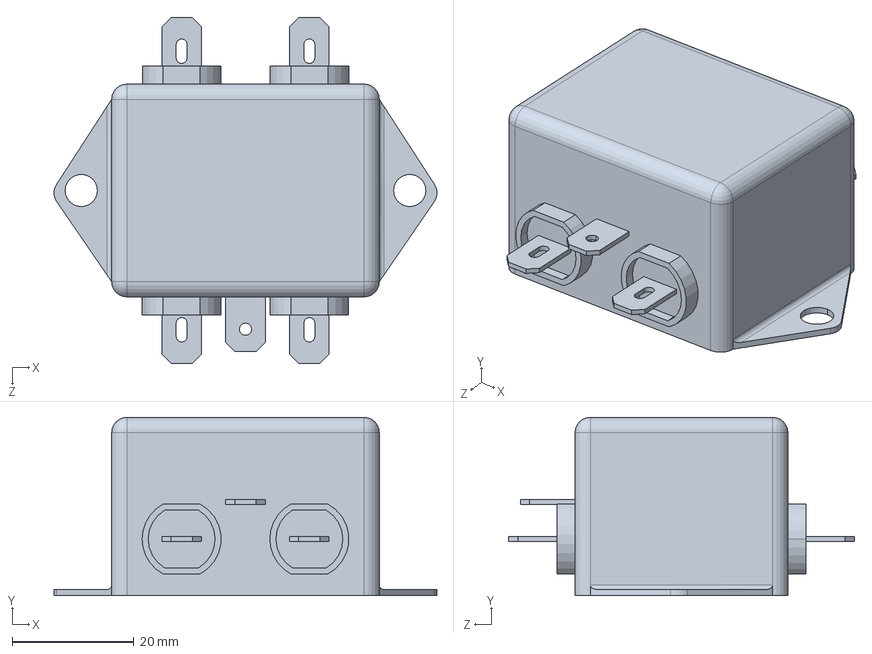
[picture p41: CAD file, 2022-08-01]
Model/Solidworks CAD and Drawings/EMI-FILT10.SLDPRT
63.0 x 29.3 x 56.8 mm
