burksbuilds/CNC-Router/Model/Solidworks CAD and Drawings/CNC-CONTROL.SLDPRT

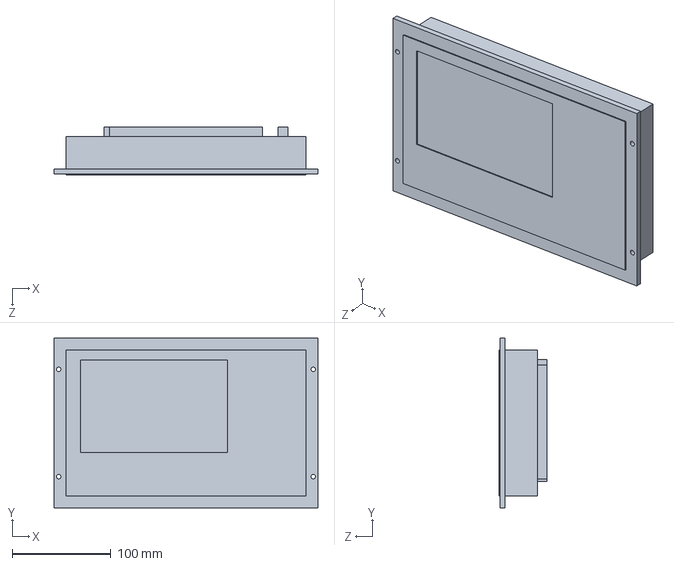
[picture p42: CAD file, 2022-08-01]
Model/Solidworks CAD and Drawings/CNC-CONTROL.SLDPRT
268.0 x 172.5 x 49.2 mm
