burksbuilds/CNC-Router/Model/Solidworks CAD and Drawings/CNCR-GANT-RP.SLDPRT

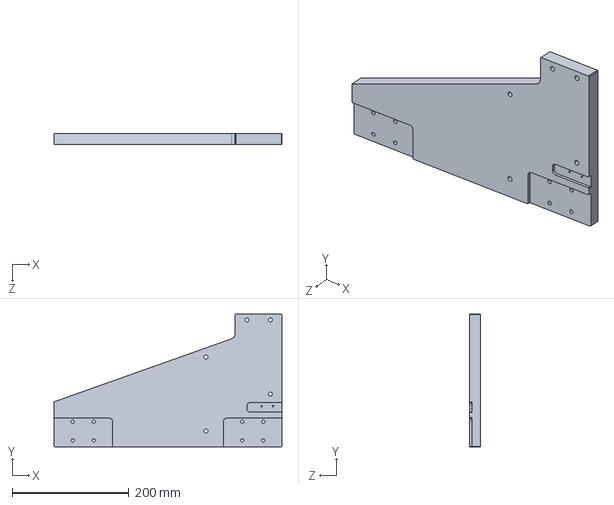
[picture p43: CAD file, 2022-08-01]
Model/Solidworks CAD and Drawings/CNCR-GANT-RP.SLDPRT
390.0 x 227.0 x 19.1 mm
