burksbuilds/CNC-Router/Model/Solidworks CAD and Drawings/CNCR-CAR-PLATE.SLDPRT

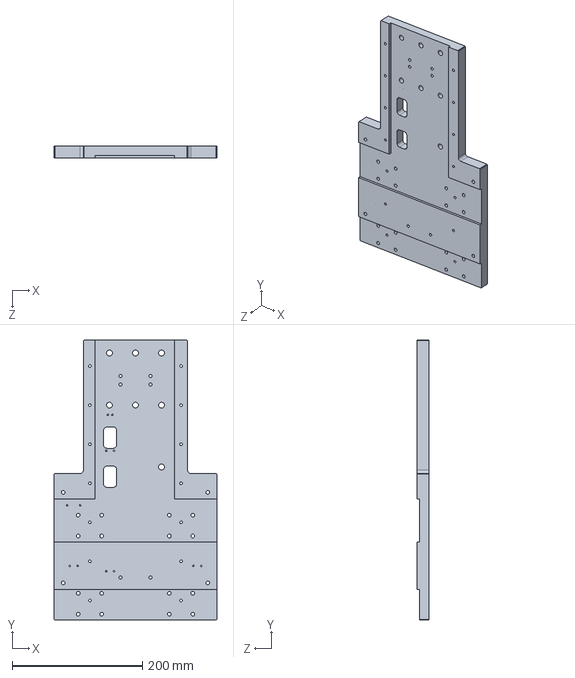
[picture p44: CAD file, 2022-08-01]
Model/Solidworks CAD and Drawings/CNCR-CAR-PLATE.SLDPRT
250.0 x 430.0 x 19.1 mm
