burksbuilds/CNC-Router/Model/Solidworks CAD and Drawings/STEP-DRIVER6.SLDPRT

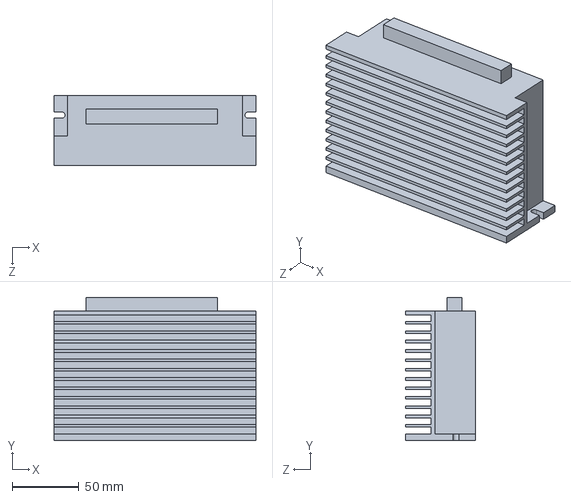
[picture p45: CAD file, 2022-08-01]
Model/Solidworks CAD and Drawings/STEP-DRIVER6.SLDPRT
151.0 x 107.0 x 52.0 mm
