burksbuilds/CNC-Router/Model/Solidworks CAD and Drawings/CNCR-BUMP.SLDPRT

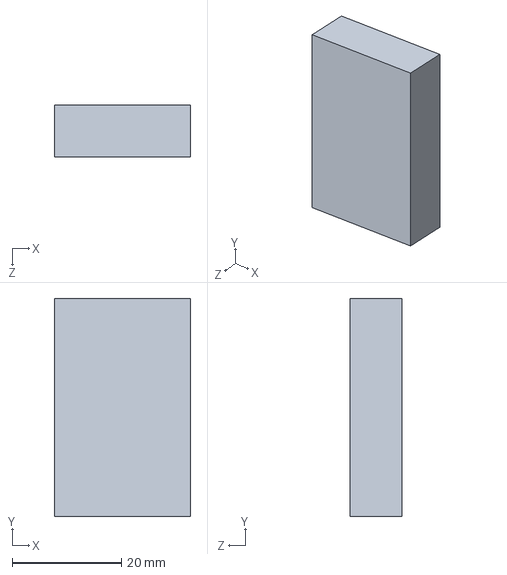
[picture p46: CAD file, 2022-08-01]
Model/Solidworks CAD and Drawings/CNCR-BUMP.SLDPRT
25.0 x 40.0 x 9.53 mm
