burksbuilds/CNC-Router/Model/Solidworks CAD and Drawings/Terminal Block, Fused.SLDPRT

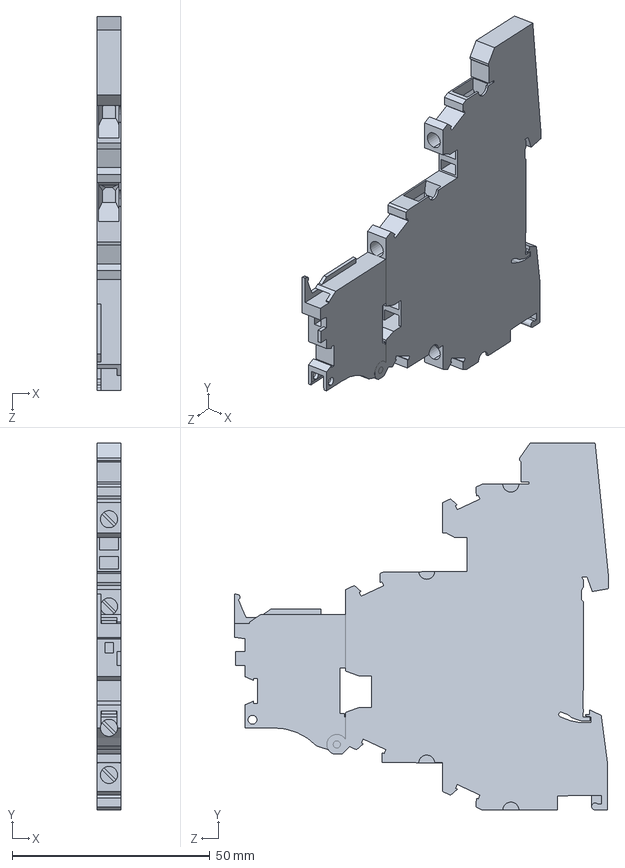
[picture p47: CAD file, 2022-08-01]
Model/Solidworks CAD and Drawings/Terminal Block, Fused.SLDPRT
6.15 x 92.7 x 94.5 mm
