burksbuilds/CNC-Router/Model/Solidworks CAD and Drawings/CNCR-SPIN-BNM.SLDPRT

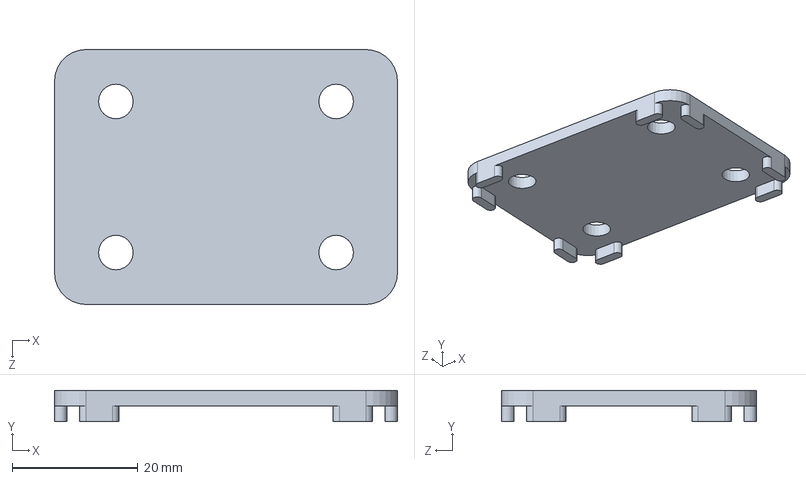
[picture p48: CAD file, 2022-08-01]
Model/Solidworks CAD and Drawings/CNCR-SPIN-BNM.SLDPRT
54.5 x 5.00 x 40.5 mm
