burksbuilds/CNC-Router/Model/Solidworks CAD and Drawings/FAN120-FILTER45.SLDPRT

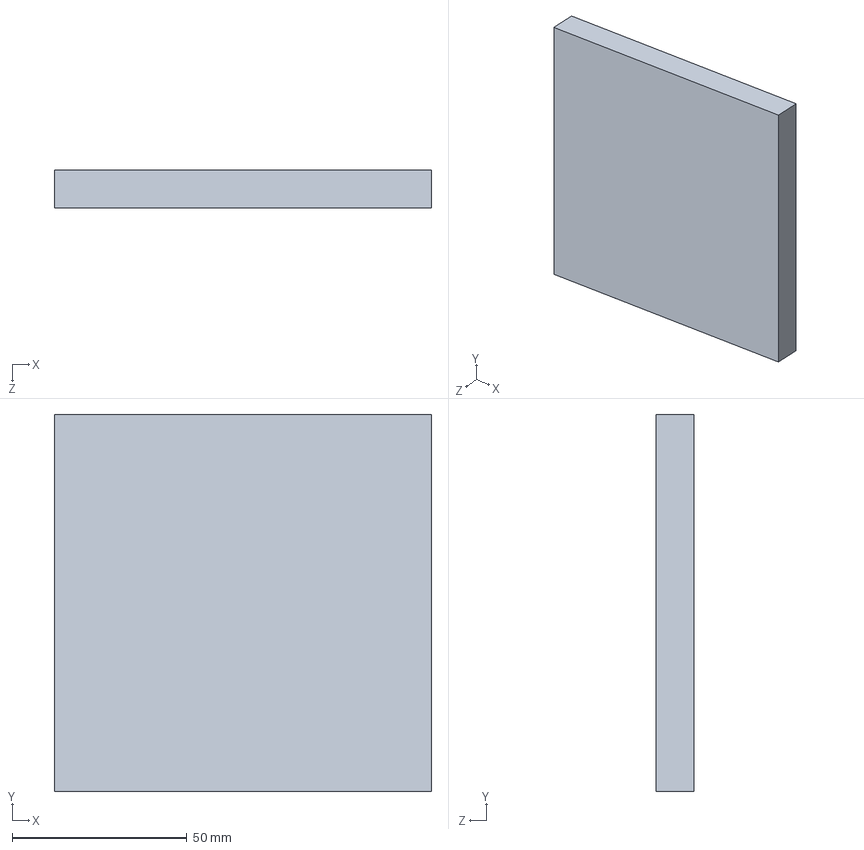
[picture p49: CAD file, 2022-08-01]
Model/Solidworks CAD and Drawings/FAN120-FILTER45.SLDPRT
108.0 x 108.0 x 10.9 mm
