burksbuilds/CNC-Router/Model/Solidworks CAD and Drawings/CNCR-HSF.SLDPRT

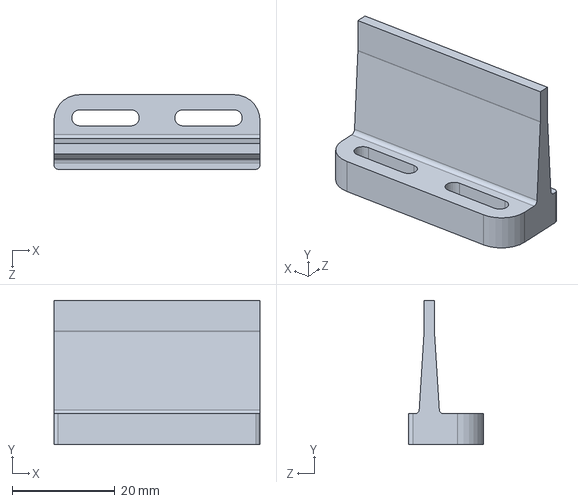
[picture p50: CAD file, 2022-08-01]
Model/Solidworks CAD and Drawings/CNCR-HSF.SLDPRT
40.0 x 28.0 x 14.5 mm
