burksbuilds/CNC-Router/Model/Solidworks CAD and Drawings/CNCR-BASE-TSE-RM.SLDPRT

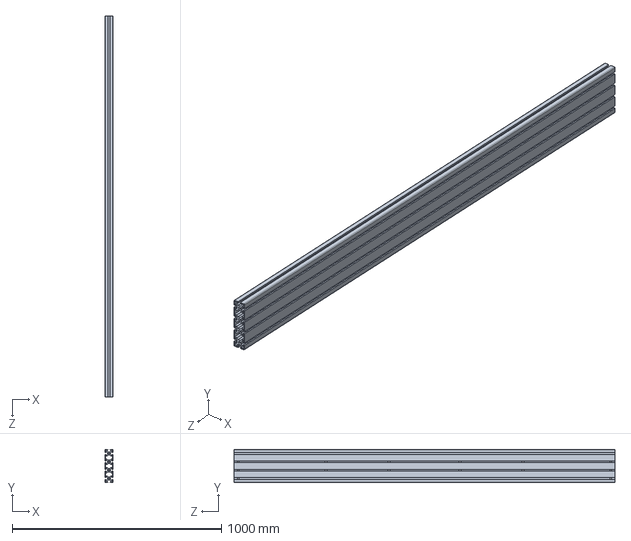
[picture p51: CAD file, 2022-08-01]
Model/Solidworks CAD and Drawings/CNCR-BASE-TSE-RM.SLDPRT
40.0 x 160.0 x 1820.0 mm
