burksbuilds/CNC-Router/Model/Solidworks CAD and Drawings/BOXCOV-6x2.SLDPRT

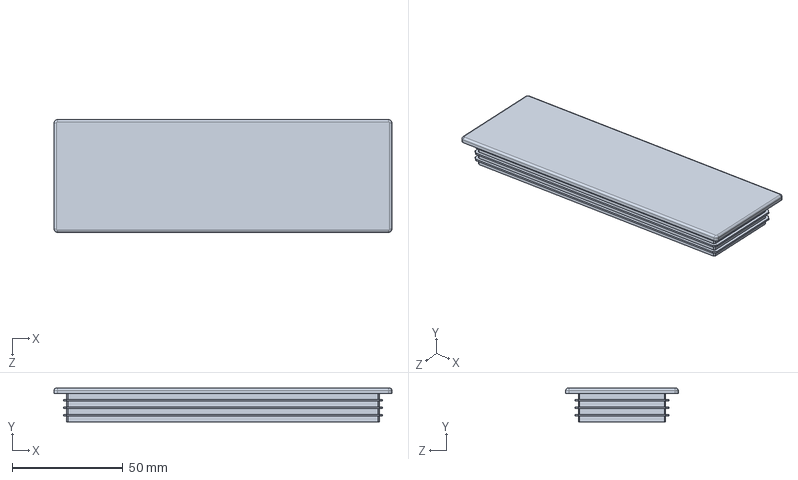
[picture p52: CAD file, 2022-08-01]
Model/Solidworks CAD and Drawings/BOXCOV-6x2.SLDPRT
152.4 x 15.2 x 50.8 mm
