burksbuilds/CNC-Router/Model/Solidworks CAD and Drawings/BALLNUT12-MOUNT.SLDPRT

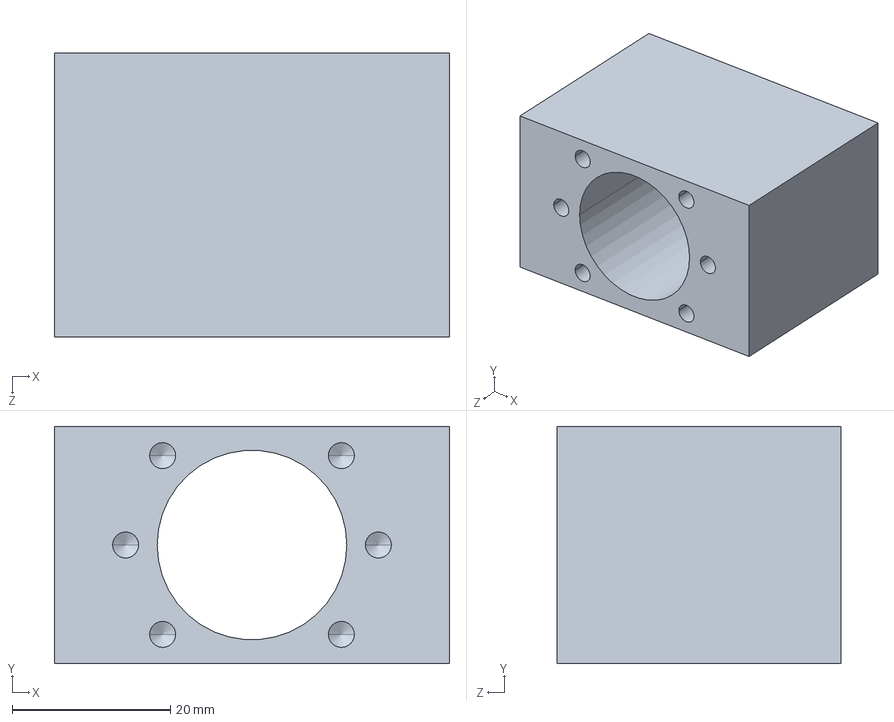
[picture p53: CAD file, 2022-08-01]
Model/Solidworks CAD and Drawings/BALLNUT12-MOUNT.SLDPRT
50.0 x 30.0 x 36.0 mm
