burksbuilds/CNC-Router/Model/Solidworks CAD and Drawings/0-75ID Grommet - 9600K94.SLDPRT

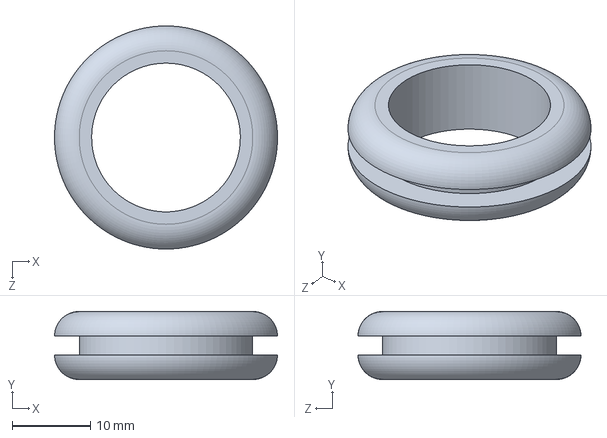
[picture p54: CAD file, 2022-08-01]
Model/Solidworks CAD and Drawings/0-75ID Grommet - 9600K94.SLDPRT
28.6 x 8.73 x 28.6 mm
