burksbuilds/CNC-Router/Model/Solidworks CAD and Drawings/RAIL20.SLDPRT

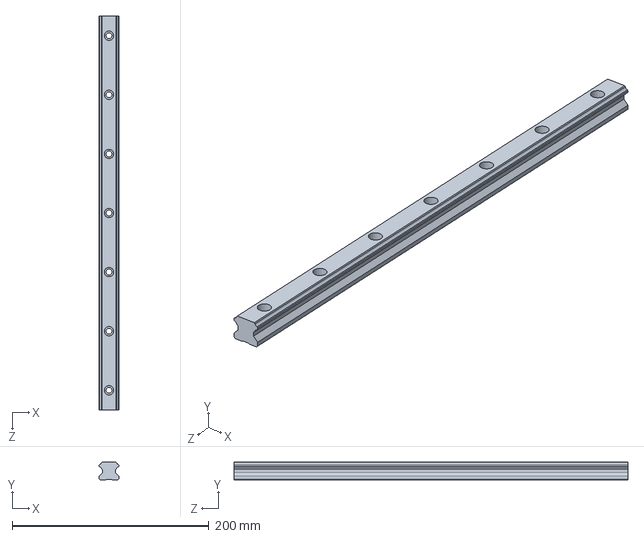
[picture p55: CAD file, 2022-08-01]
Model/Solidworks CAD and Drawings/RAIL20.SLDPRT
20.0 x 18.0 x 400.0 mm
