burksbuilds/CNC-Router/Model/Solidworks CAD and Drawings/Terminal Block, 2 Level.SLDPRT

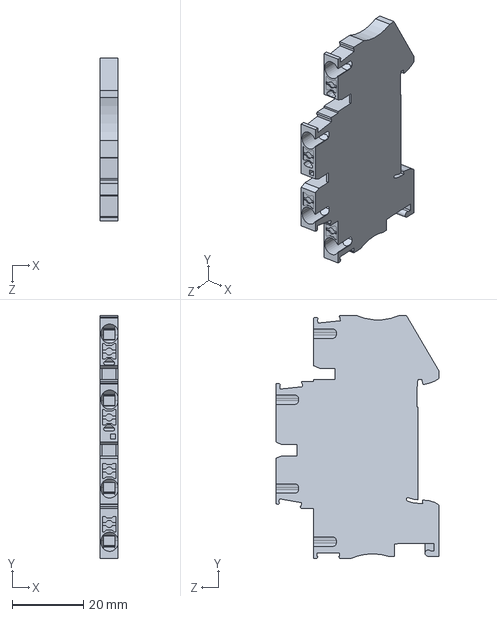
[picture p56: CAD file, 2022-08-01]
Model/Solidworks CAD and Drawings/Terminal Block, 2 Level.SLDPRT
5.15 x 68.2 x 45.9 mm
