burksbuilds/CNC-Router/Model/Solidworks CAD and Drawings/CNCR-BBM.SLDPRT

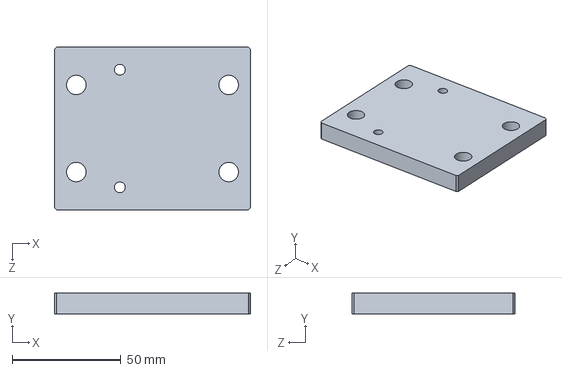
[picture p57: CAD file, 2022-08-01]
Model/Solidworks CAD and Drawings/CNCR-BBM.SLDPRT
90.0 x 9.53 x 75.0 mm
