burksbuilds/CNC-Router/Model/Solidworks CAD and Drawings/Circuit Breaker, 1 Pole.SLDPRT

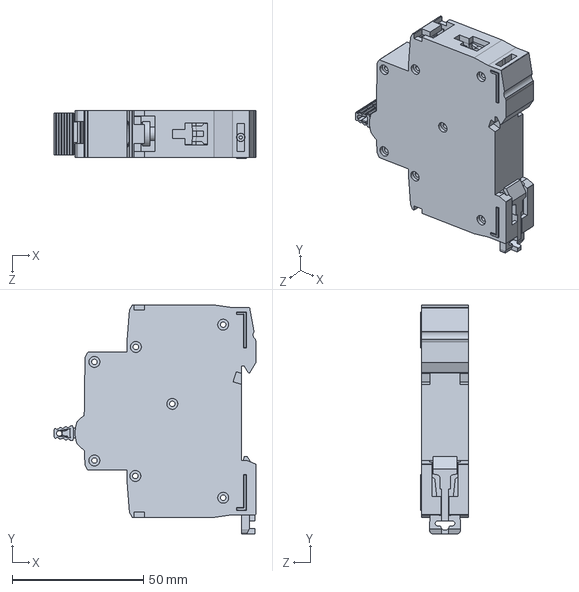
[picture p58: CAD file, 2022-08-01]
Model/Solidworks CAD and Drawings/Circuit Breaker, 1 Pole.SLDPRT
77.0 x 87.3 x 18.4 mm
