burksbuilds/CNC-Router/Model/Solidworks CAD and Drawings/Disconnect.SLDPRT

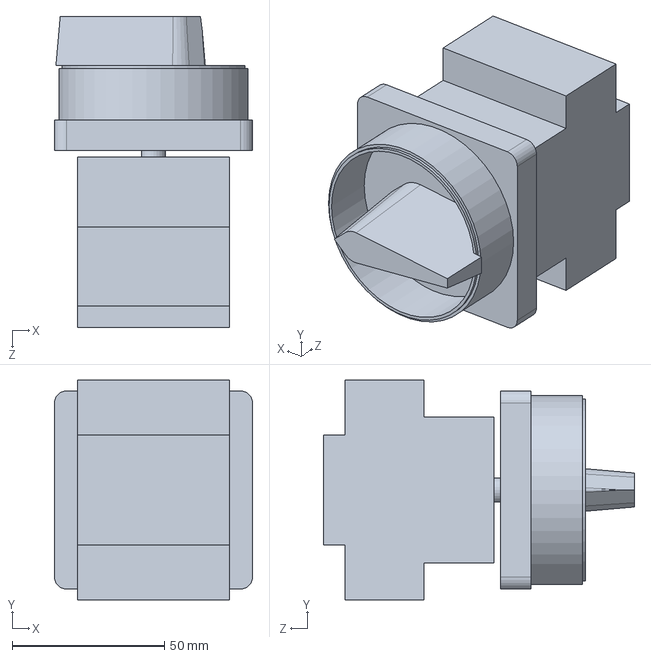
[picture p59: CAD file, 2022-08-01]
Model/Solidworks CAD and Drawings/Disconnect.SLDPRT
65.0 x 72.0 x 102.0 mm
