burksbuilds/CNC-Router/Model/Solidworks CAD and Drawings/CNCR-GANT-BNM.SLDPRT

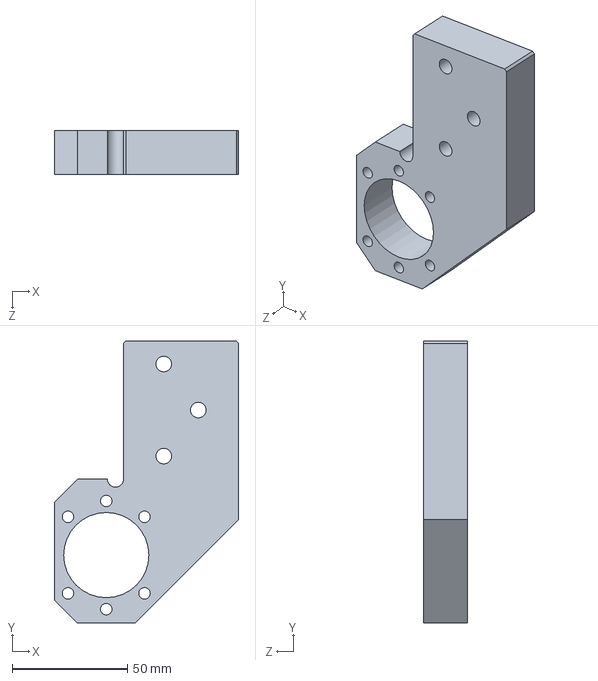
[picture p60: CAD file, 2022-08-01]
Model/Solidworks CAD and Drawings/CNCR-GANT-BNM.SLDPRT
80.0 x 122.5 x 19.1 mm
