burksbuilds/CNC-Router/Model/Solidworks CAD and Drawings/Motor Power Supply.SLDPRT

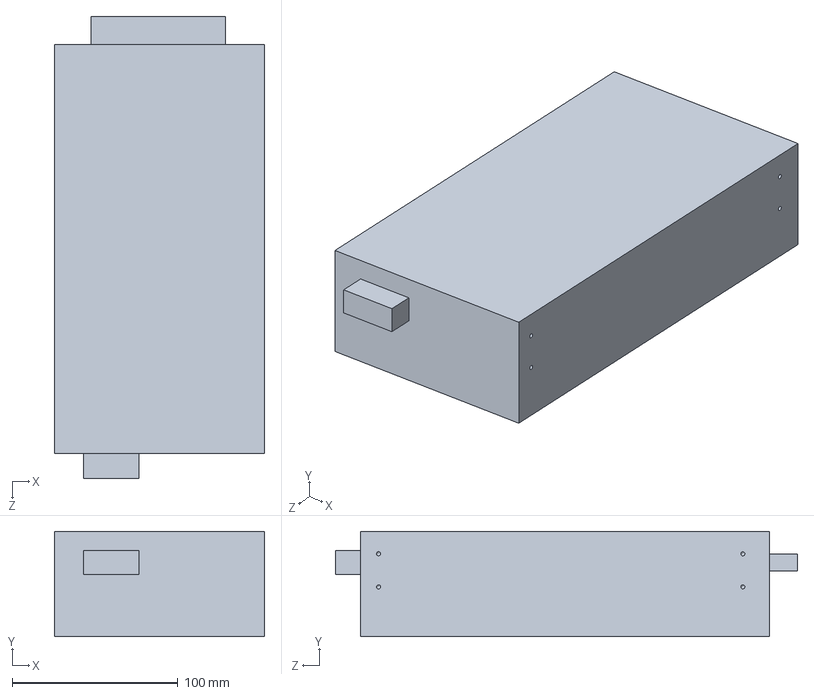
[picture p61: CAD file, 2022-08-01]
Model/Solidworks CAD and Drawings/Motor Power Supply.SLDPRT
127.0 x 63.5 x 279.0 mm
