burksbuilds/CNC-Router/Model/Solidworks CAD and Drawings/CNCR-ELEC-PLATE.SLDPRT

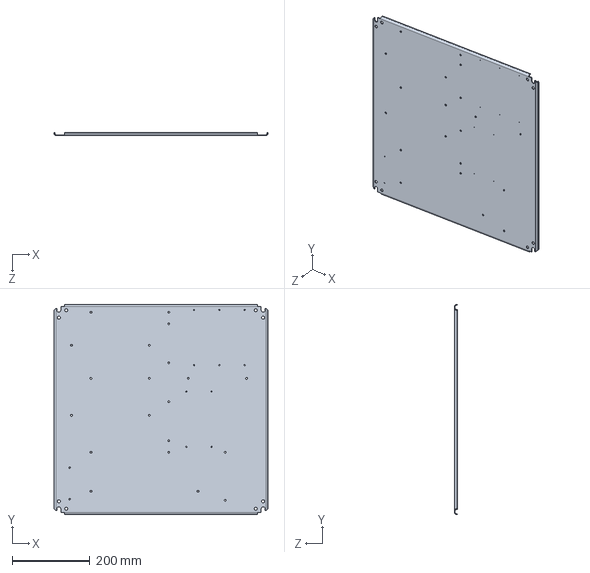
[picture p62: CAD file, 2022-08-01]
Model/Solidworks CAD and Drawings/CNCR-ELEC-PLATE.SLDPRT
550.0 x 540.0 x 8.00 mm
