burksbuilds/CNC-Router/Model/Solidworks CAD and Drawings/DIN-CLIP-M5.SLDPRT

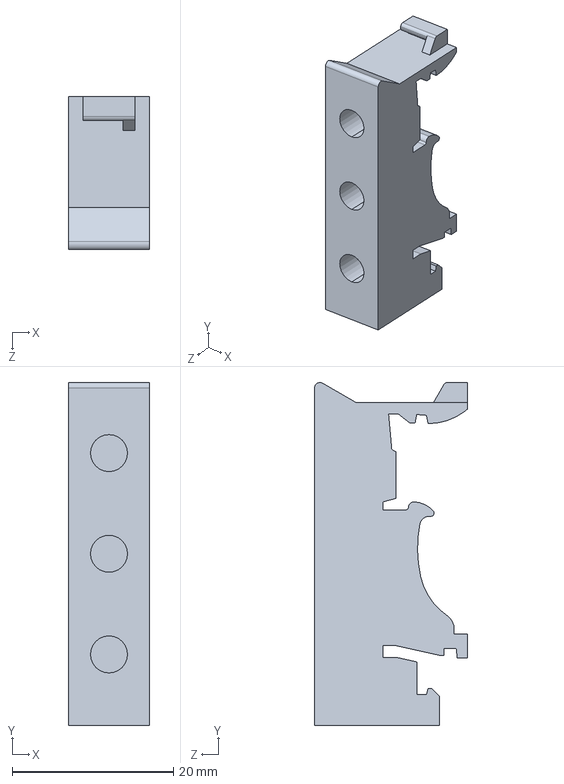
[picture p63: CAD file, 2022-08-01]
Model/Solidworks CAD and Drawings/DIN-CLIP-M5.SLDPRT
10.0 x 42.6 x 19.0 mm
