burksbuilds/CNC-Router/Model/Solidworks CAD and Drawings/1-50ID Grommet.SLDPRT

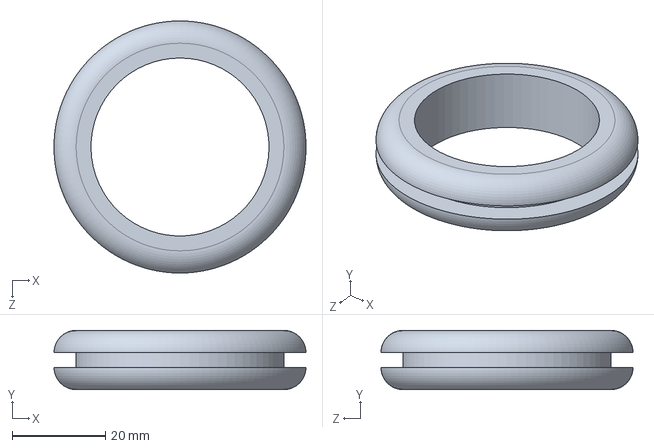
[picture p64: CAD file, 2022-08-01]
Model/Solidworks CAD and Drawings/1-50ID Grommet.SLDPRT
54.0 x 12.7 x 54.0 mm
