burksbuilds/CNC-Router/Model/Solidworks CAD and Drawings/NEMA24.SLDPRT

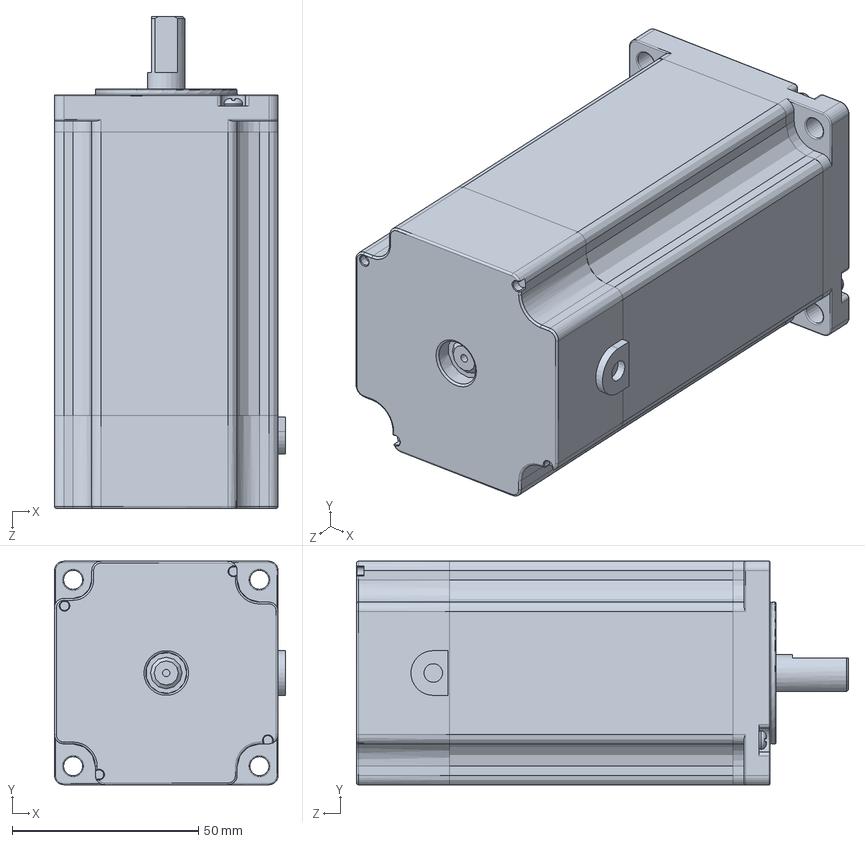
[picture p65: CAD file, 2022-08-01]
Model/Solidworks CAD and Drawings/NEMA24.SLDPRT
62.0 x 60.0 x 132.0 mm
