burksbuilds/CNC-Router/Model/Solidworks CAD and Drawings/POWER-24VDC-600W.SLDPRT

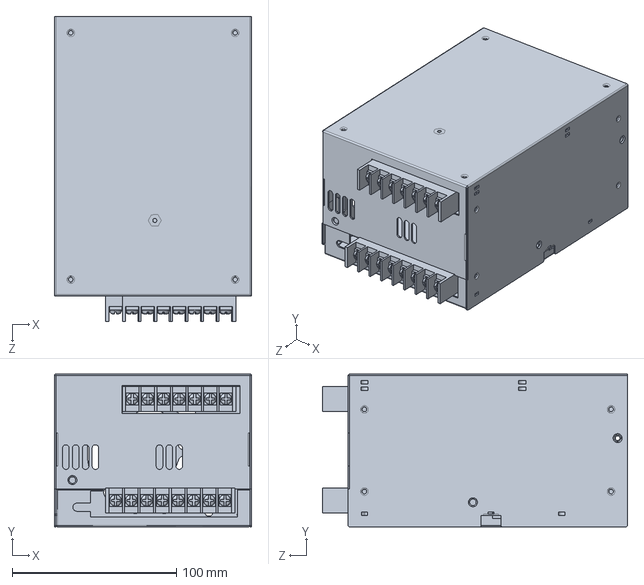
[picture p66: CAD file, 2022-08-01]
Model/Solidworks CAD and Drawings/POWER-24VDC-600W.SLDPRT
120.0 x 93.0 x 185.5 mm
