burksbuilds/CNC-Router/Model/Solidworks CAD and Drawings/HUB25-CON.SLDPRT

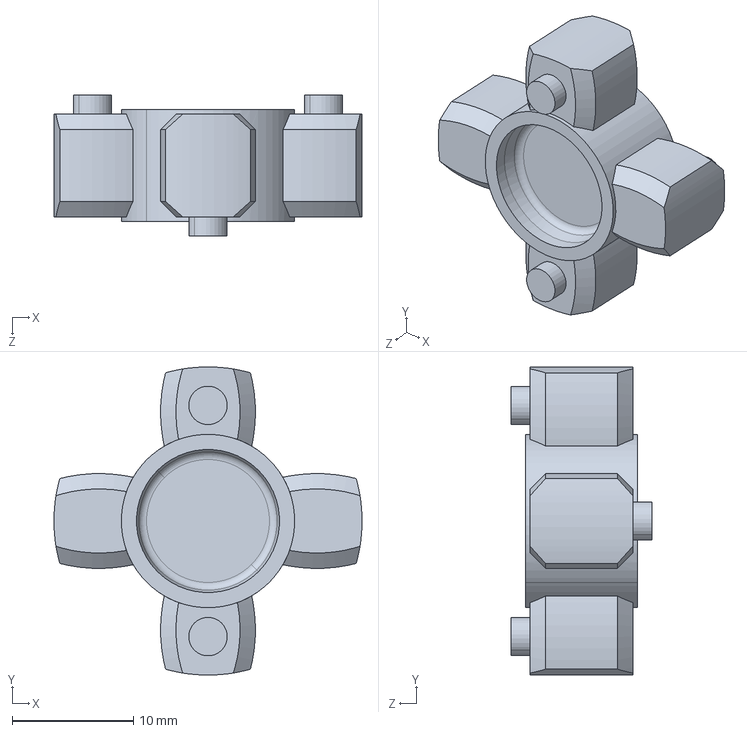
[picture p67: CAD file, 2022-08-01]
Model/Solidworks CAD and Drawings/HUB25-CON.SLDPRT
25.4 x 25.4 x 11.6 mm
