burksbuilds/CNC-Router/Model/Solidworks CAD and Drawings/BEARING20.SLDPRT

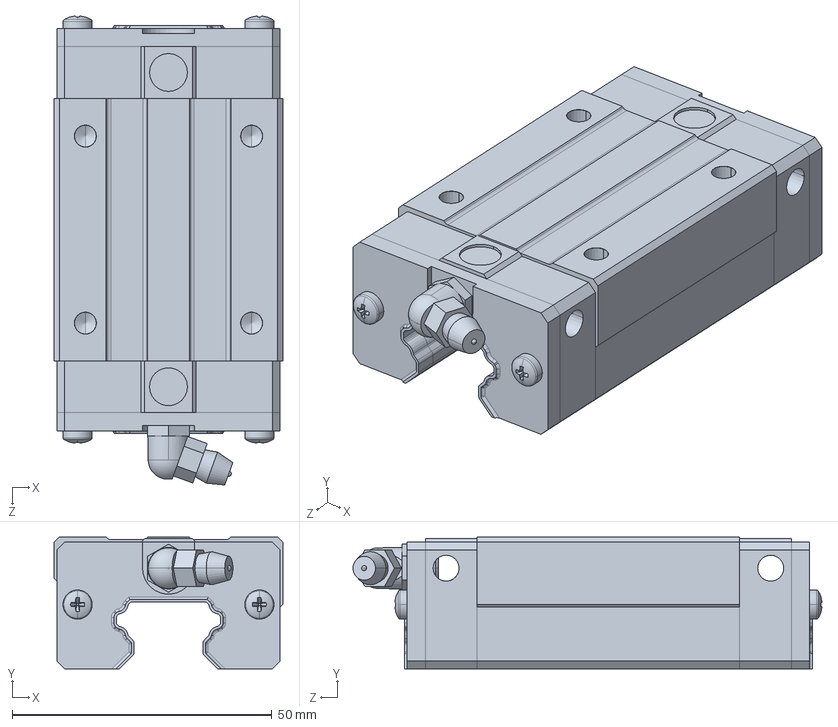
[picture p68: CAD file, 2022-08-01]
Model/Solidworks CAD and Drawings/BEARING20.SLDPRT
44.0 x 25.4 x 90.3 mm
