burksbuilds/CNC-Router/Model/Solidworks CAD and Drawings/CNCR-GANT-RT.SLDPRT

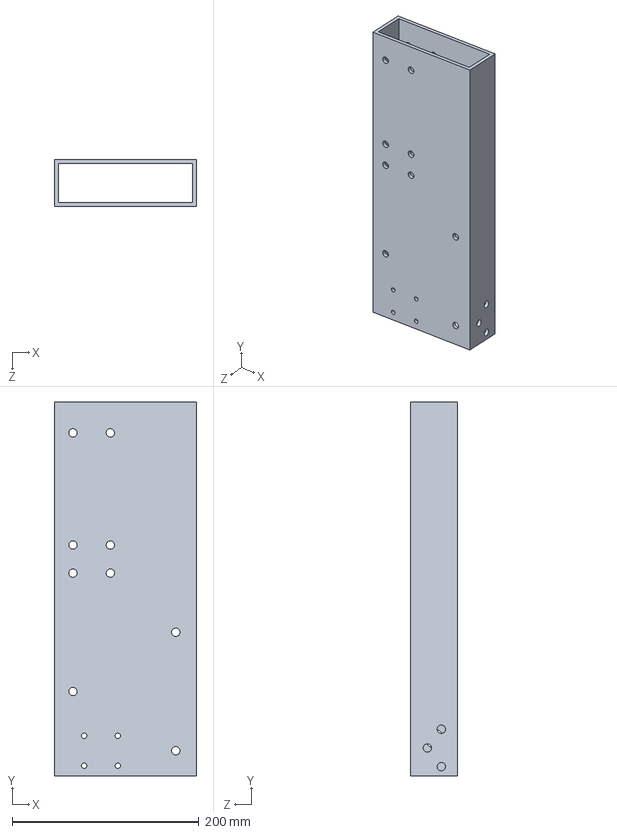
[picture p69: CAD file, 2022-08-01]
Model/Solidworks CAD and Drawings/CNCR-GANT-RT.SLDPRT
152.4 x 400.0 x 50.8 mm
