burksbuilds/CNC-Router/Model/Solidworks CAD and Drawings/FAN120.SLDPRT

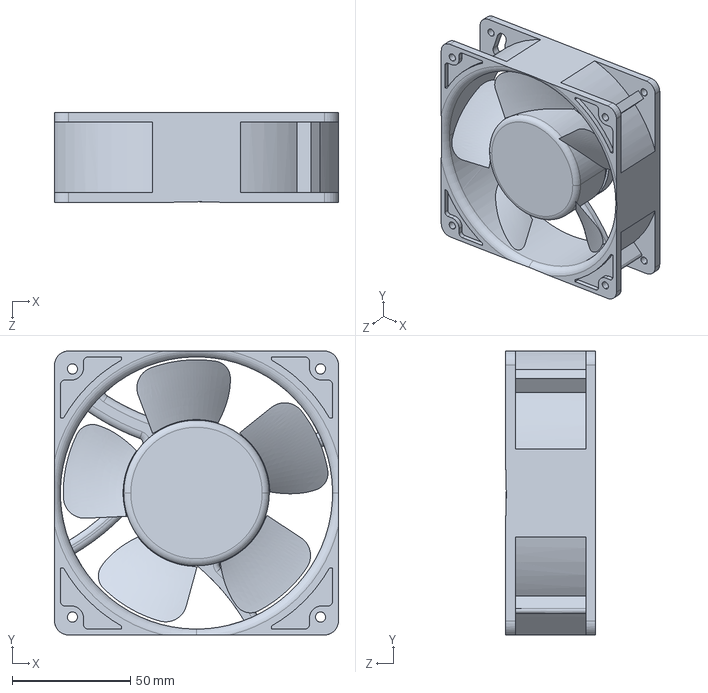
[picture p70: CAD file, 2022-08-01]
Model/Solidworks CAD and Drawings/FAN120.SLDPRT
120.0 x 120.0 x 38.0 mm
