burksbuilds/CNC-Router/Model/Solidworks CAD and Drawings/HUB25-8.SLDPRT

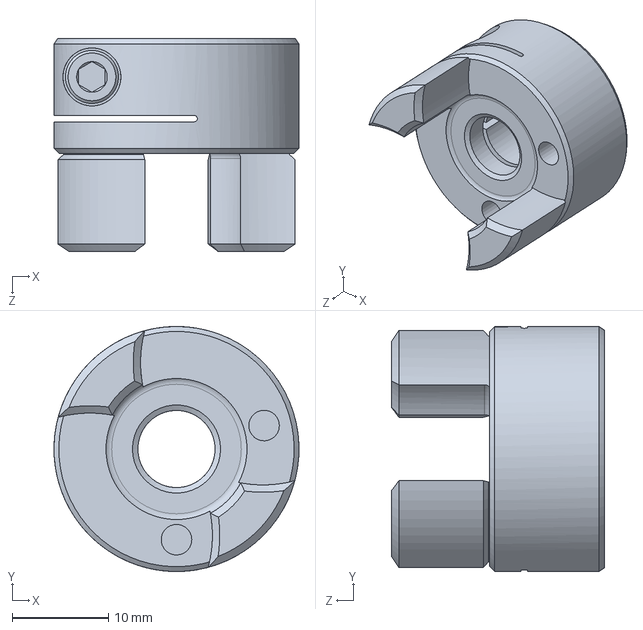
[picture p71: CAD file, 2022-08-01]
Model/Solidworks CAD and Drawings/HUB25-8.SLDPRT
25.4 x 25.4 x 22.1 mm
