burksbuilds/CNC-Router/Model/Solidworks CAD and Drawings/1-375in Grommet - 63595K33.SLDPRT

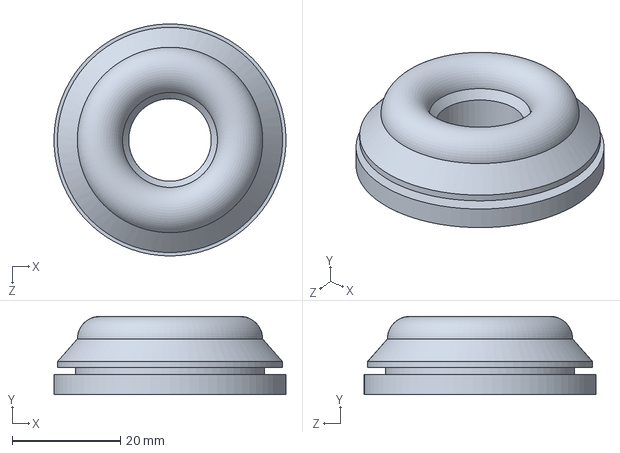
[picture p72: CAD file, 2022-08-01]
Model/Solidworks CAD and Drawings/1-375in Grommet - 63595K33.SLDPRT
42.9 x 14.5 x 42.8 mm
