burksbuilds/CNC-Router/Model/Solidworks CAD and Drawings/Terminal Block, Relay.SLDPRT

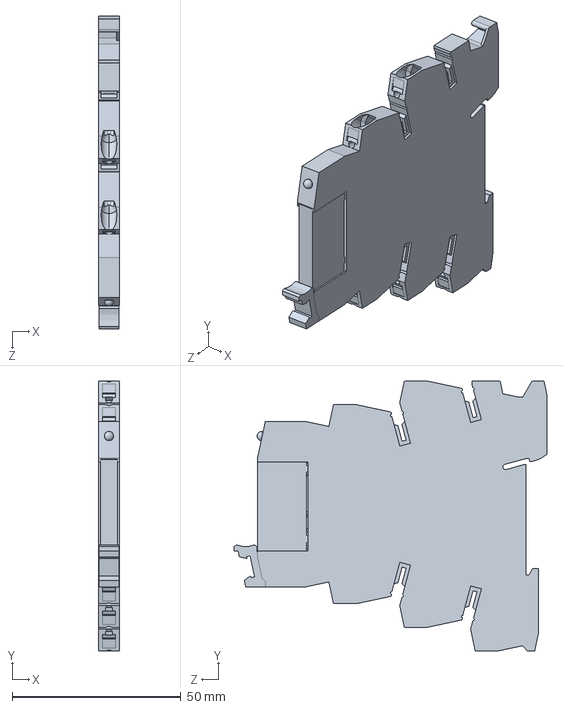
[picture p73: CAD file, 2022-08-01]
Model/Solidworks CAD and Drawings/Terminal Block, Relay.SLDPRT
6.10 x 80.0 x 92.6 mm
