burksbuilds/CNC-Router/Model/Solidworks CAD and Drawings/CNCR-CAR-MM.SLDPRT

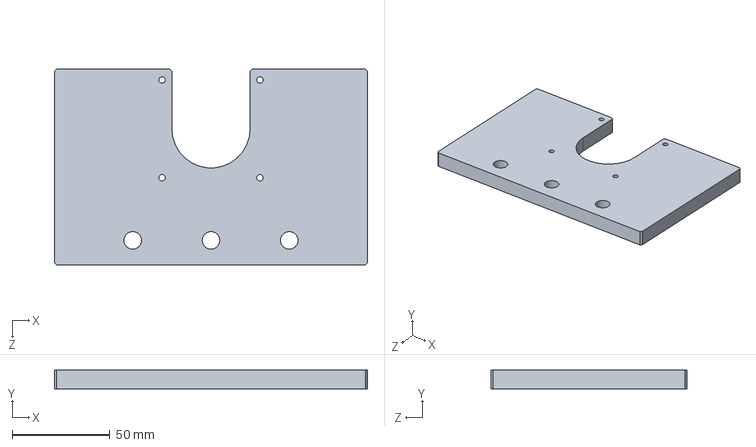
[picture p74: CAD file, 2022-08-01]
Model/Solidworks CAD and Drawings/CNCR-CAR-MM.SLDPRT
160.0 x 9.53 x 100.0 mm
