burksbuilds/CNC-Router/Model/Solidworks CAD and Drawings/CABLE-GLAND25.SLDPRT

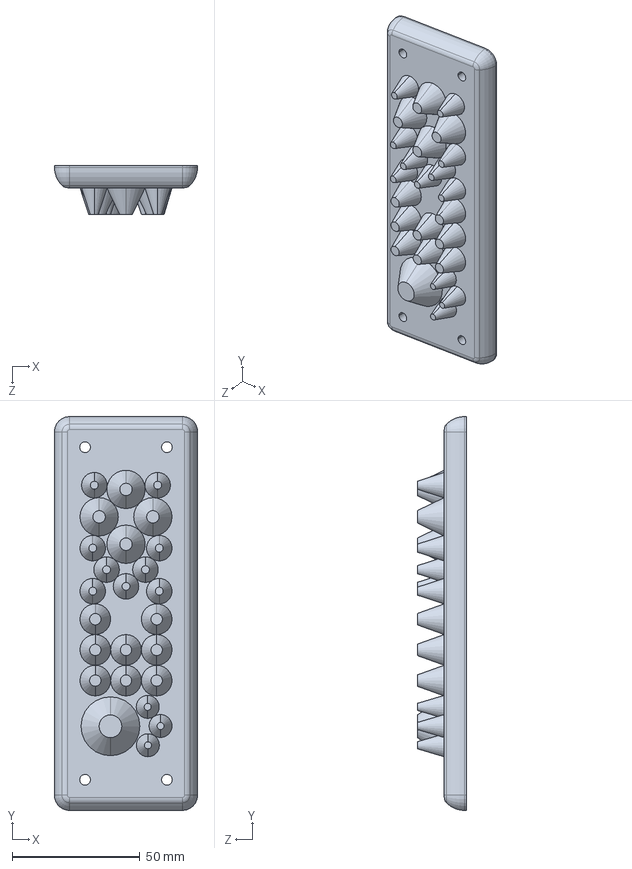
[picture p75: CAD file, 2022-08-01]
Model/Solidworks CAD and Drawings/CABLE-GLAND25.SLDPRT
56.0 x 154.0 x 19.2 mm
