burksbuilds/CNC-Router/Model/Solidworks CAD and Drawings/CNCR-ELEC-PANEL-CUT.SLDPRT

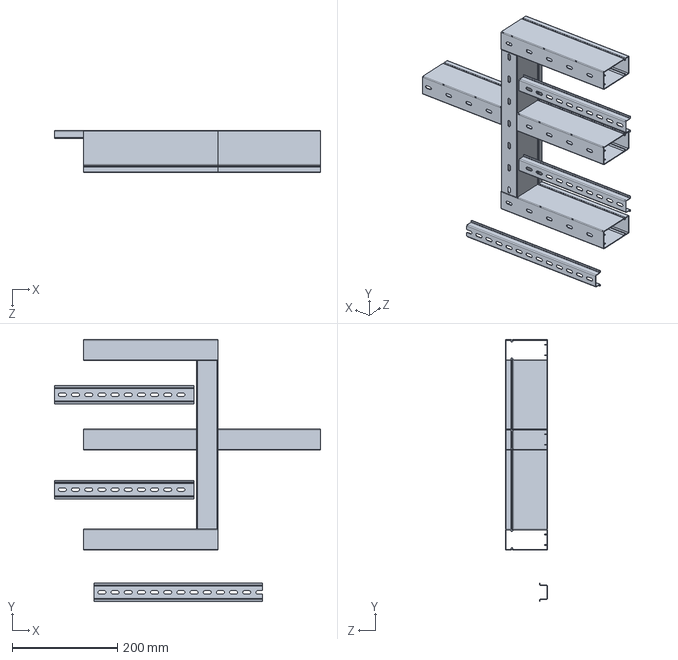
[picture p76: CAD file, 2022-08-01]
Model/Solidworks CAD and Drawings/CNCR-ELEC-PANEL-CUT.SLDPRT
505.0 x 497.5 x 80.0 mm
