burksbuilds/CNC-Router/Model/Solidworks CAD and Drawings/EDR-150.SLDPRT

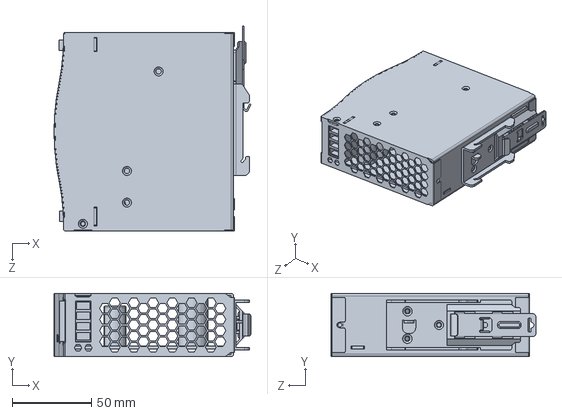
[picture p77: CAD file, 2022-08-01]
Model/Solidworks CAD and Drawings/EDR-150.SLDPRT
124.3 x 40.0 x 129.2 mm
