burksbuilds/CNC-Router/Model/Solidworks CAD and Drawings/Terminal Block, 3 Level.SLDPRT

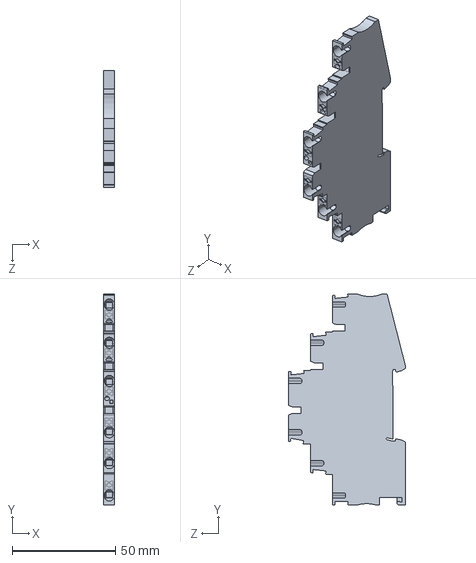
[picture p78: CAD file, 2022-08-01]
Model/Solidworks CAD and Drawings/Terminal Block, 3 Level.SLDPRT
5.15 x 102.2 x 56.4 mm
