burksbuilds/CNC-Router/Model/Solidworks CAD and Drawings/GROUND-BAR15.SLDPRT

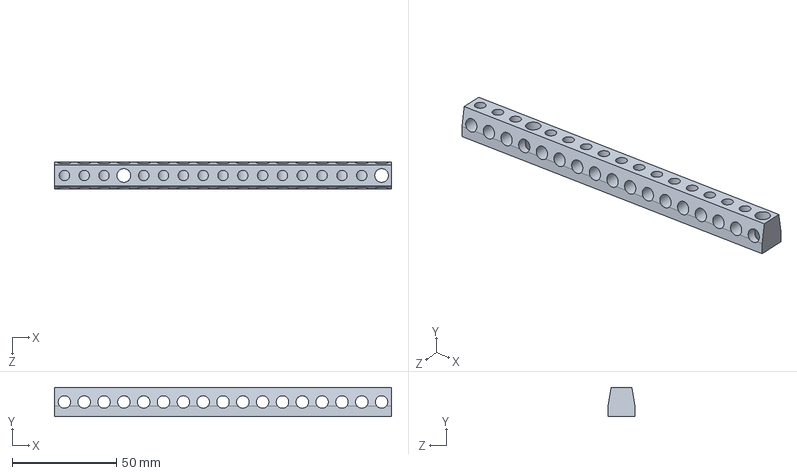
[picture p80: CAD file, 2022-08-01]
Model/Solidworks CAD and Drawings/GROUND-BAR15.SLDPRT
161.5 x 14.0 x 13.0 mm
