burksbuilds/CNC-Router/Model/Solidworks CAD and Drawings/CNCR-CAR-ECM.SLDPRT

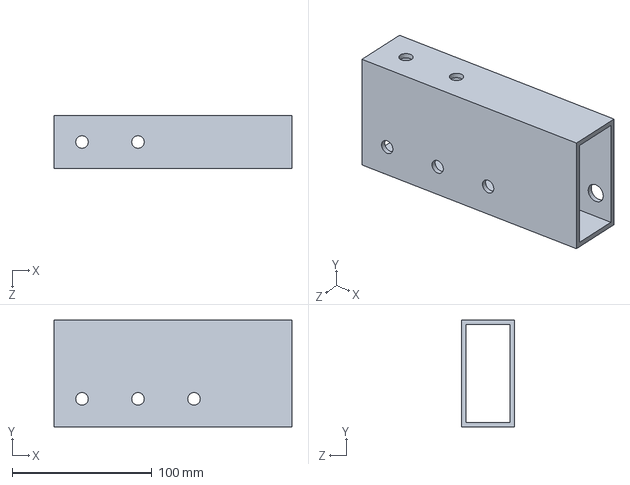
[picture p81: CAD file, 2022-04-20]
Model/Solidworks CAD and Drawings/CNCR-CAR-ECM.SLDPRT
170.0 x 76.2 x 38.1 mm
