burksbuilds/CNC-Router/Model/Solidworks CAD and Drawings/CNCR-SPIN-TSE-HSM.SLDPRT

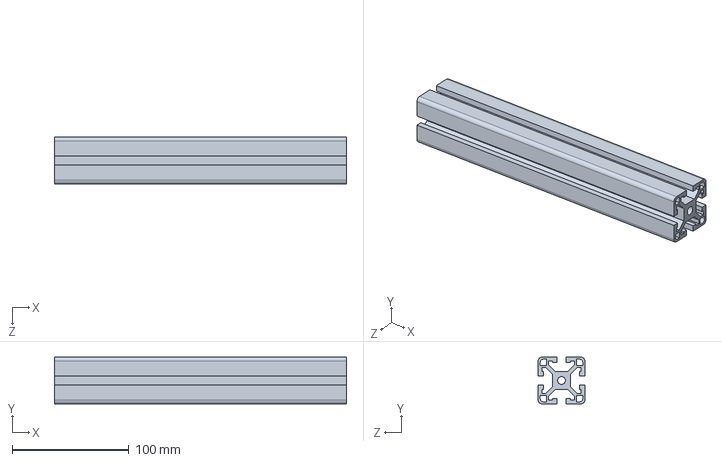
[picture p82: CAD file, 2022-04-20]
Model/Solidworks CAD and Drawings/CNCR-SPIN-TSE-HSM.SLDPRT
250.0 x 40.0 x 40.0 mm
