burksbuilds/CNC-Router/Model/Solidworks CAD and Drawings/CNCR-SPIN-TSE-AM.SLDPRT

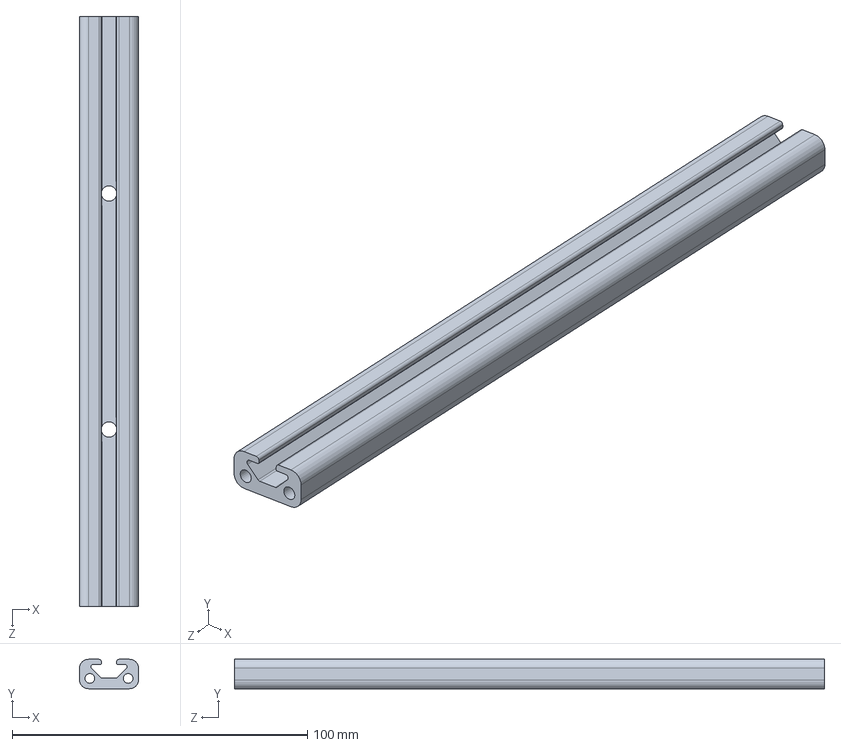
[picture p83: CAD file, 2022-04-20]
Model/Solidworks CAD and Drawings/CNCR-SPIN-TSE-AM.SLDPRT
20.0 x 10.0 x 200.0 mm
