burksbuilds/CNC-Router/Model/Solidworks CAD and Drawings/CNCR-SPIN-PLATE.SLDPRT

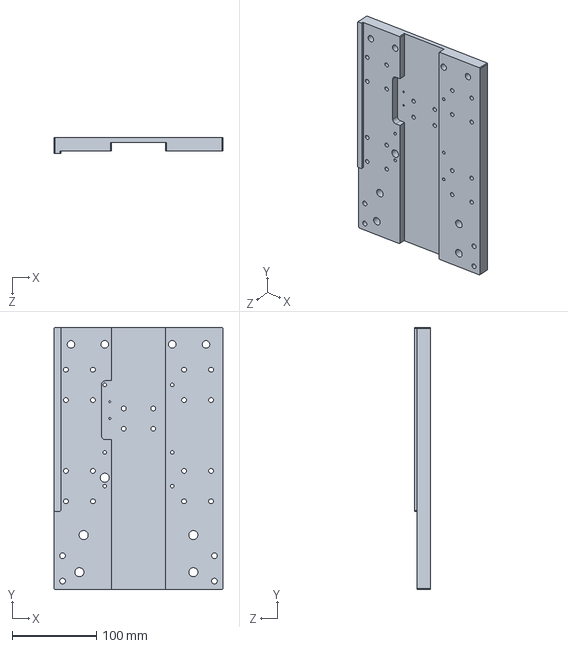
[picture p84: CAD file, 2022-04-20]
Model/Solidworks CAD and Drawings/CNCR-SPIN-PLATE.SLDPRT
200.0 x 310.5 x 19.1 mm
