burksbuilds/CNC-Router/Model/Solidworks CAD and Drawings/CNCR-CAR-TSE-ECM.SLDPRT

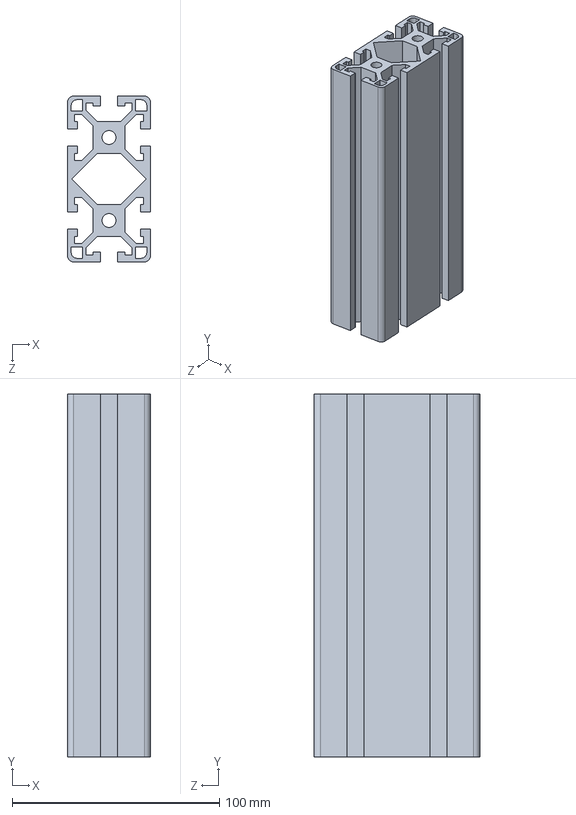
[picture p85: CAD file, 2022-04-20]
Model/Solidworks CAD and Drawings/CNCR-CAR-TSE-ECM.SLDPRT
40.0 x 175.0 x 80.0 mm
