burksbuilds/CNC-Router/Model/Solidworks CAD and Drawings/CNCR-GANT-TSE-ECM.SLDPRT

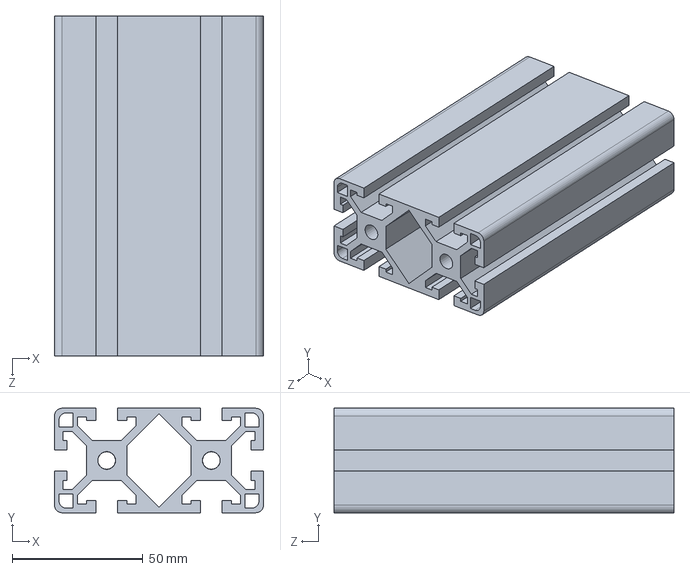
[picture p86: CAD file, 2022-04-20]
Model/Solidworks CAD and Drawings/CNCR-GANT-TSE-ECM.SLDPRT
80.0 x 40.0 x 130.0 mm
