burksbuilds/CNC-Router/Model/Solidworks CAD and Drawings/CNCR-CAR-TSE-LPS.SLDPRT

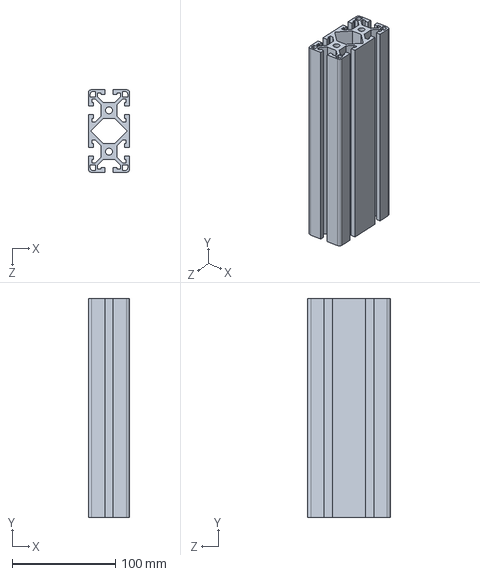
[picture p87: CAD file, 2022-04-20]
Model/Solidworks CAD and Drawings/CNCR-CAR-TSE-LPS.SLDPRT
40.0 x 212.0 x 80.0 mm
