burksbuilds/CNC-Router/Model/Solidworks CAD and Drawings/CNCR-CAR-TSE-SS.SLDPRT

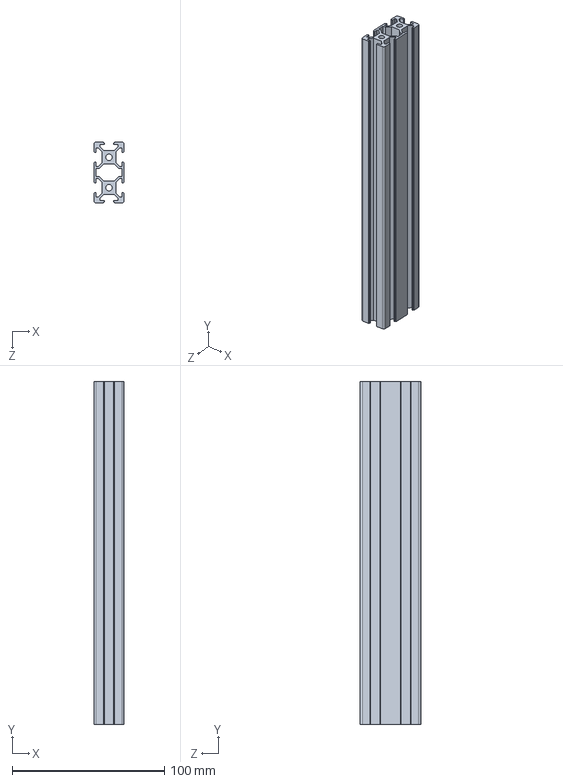
[picture p88: CAD file, 2022-04-20]
Model/Solidworks CAD and Drawings/CNCR-CAR-TSE-SS.SLDPRT
20.0 x 225.0 x 40.0 mm
