burksbuilds/CNC-Router/Model/Solidworks CAD and Drawings/CNCR-CAR-TSE-SPS.SLDPRT

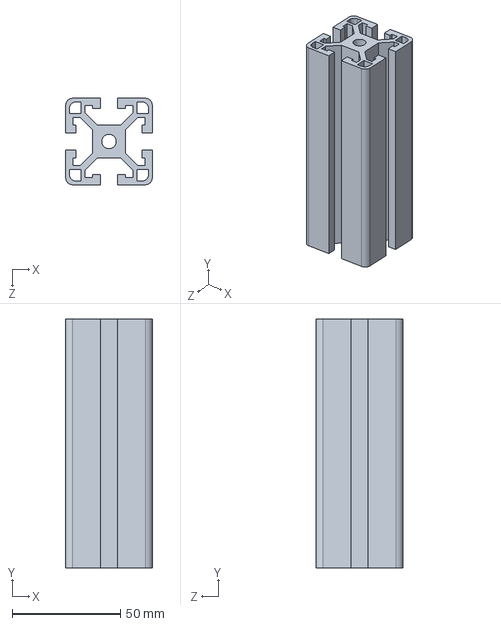
[picture p89: CAD file, 2022-04-20]
Model/Solidworks CAD and Drawings/CNCR-CAR-TSE-SPS.SLDPRT
40.0 x 115.0 x 40.0 mm
