burksbuilds/CNC-Router/Model/Solidworks CAD and Drawings/CNCR-BASE-TSE-OBM.SLDPRT

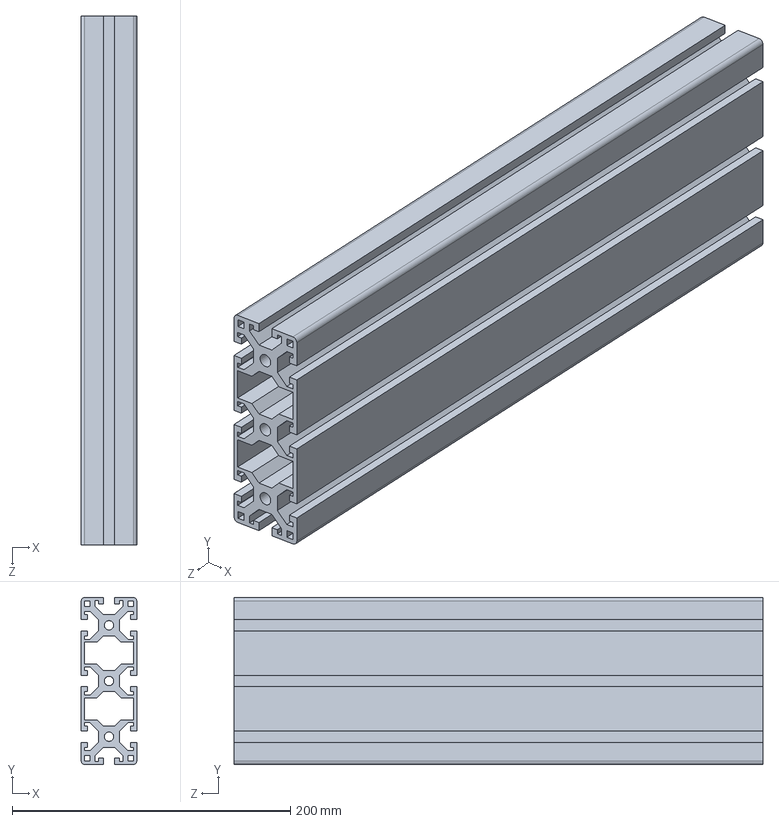
[picture p90: CAD file, 2022-03-06]
Model/Solidworks CAD and Drawings/CNCR-BASE-TSE-OBM.SLDPRT
40.0 x 120.0 x 380.0 mm
