burksbuilds/CNC-Router/Model/Solidworks CAD and Drawings/CNCR-GANT-RT-CABLE.SLDPRT

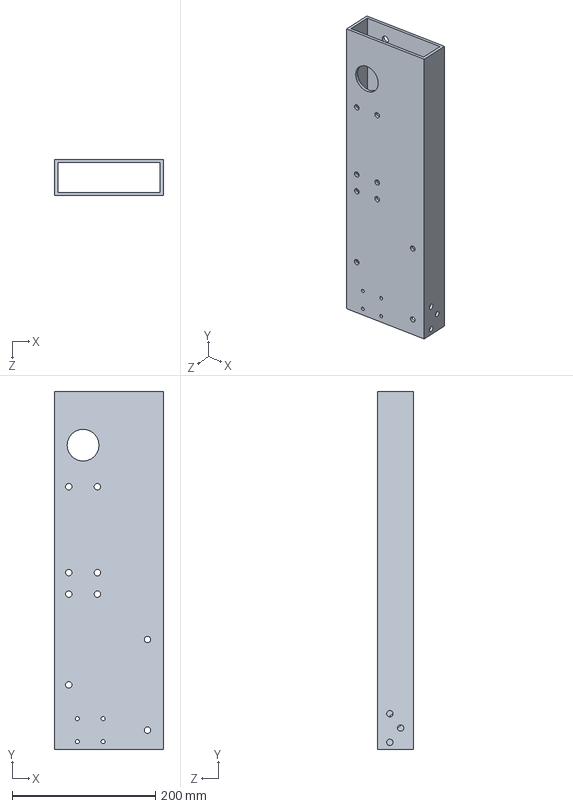
[picture p91: CAD file, 2022-03-06]
Model/Solidworks CAD and Drawings/CNCR-GANT-RT-CABLE.SLDPRT
152.4 x 500.0 x 50.8 mm
