burksbuilds/CNC-Router/Model/Solidworks CAD and Drawings/TURNBUCKLE-6in.SLDPRT

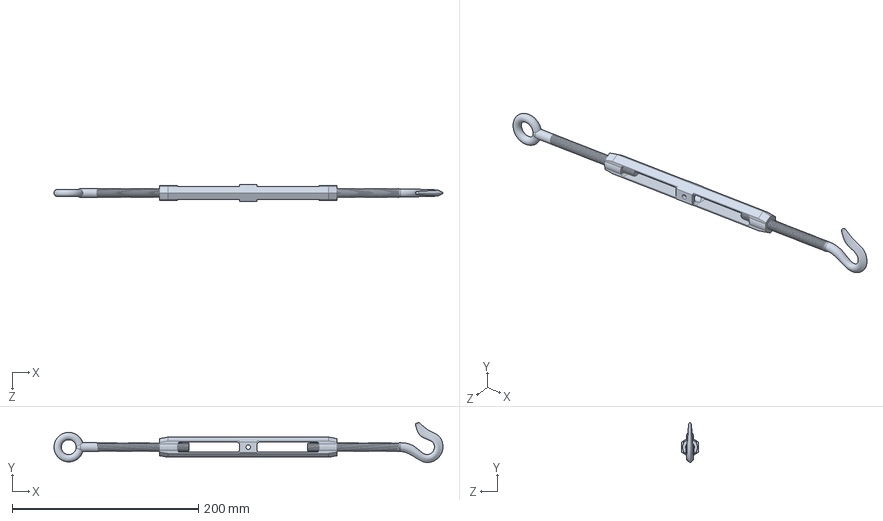
[picture p92: CAD file, 2022-03-06]
Model/Solidworks CAD and Drawings/TURNBUCKLE-6in.SLDPRT
418.0 x 43.1 x 18.3 mm
