burksbuilds/CNC-Router/Model/Solidworks CAD and Drawings/CNCR-STAND-FP.SLDPRT

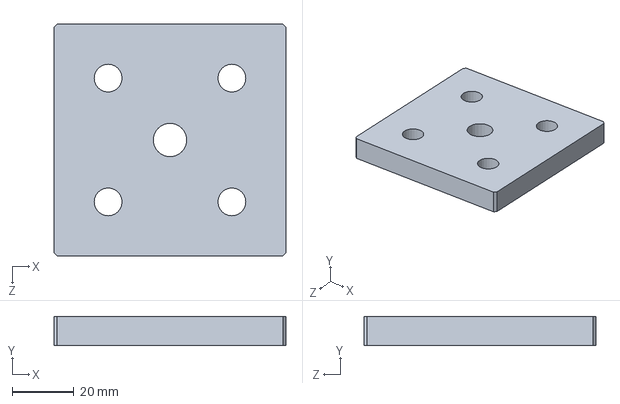
[picture p93: CAD file, 2022-03-06]
Model/Solidworks CAD and Drawings/CNCR-STAND-FP.SLDPRT
75.0 x 9.53 x 75.0 mm
