burksbuilds/CNC-Router/Model/Solidworks CAD and Drawings/CNCR-BASE-LSP.SLDPRT

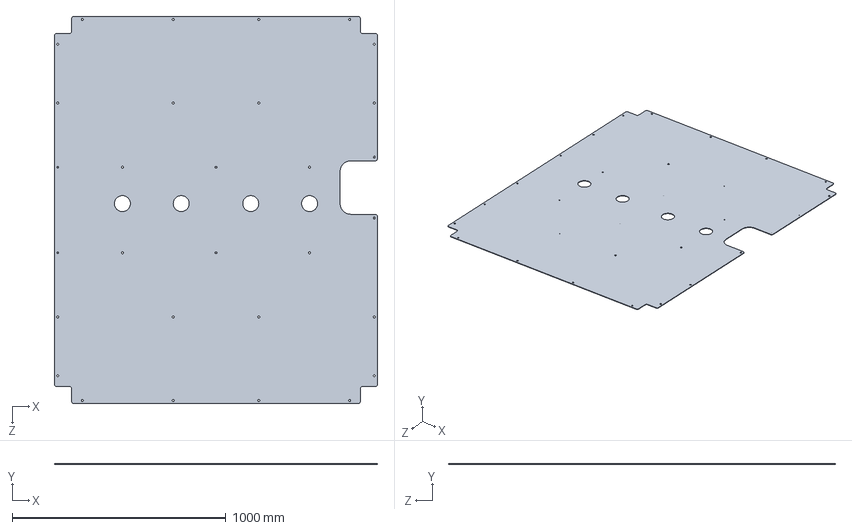
[picture p94: CAD file, 2022-03-06]
Model/Solidworks CAD and Drawings/CNCR-BASE-LSP.SLDPRT
1510.0 x 3.04 x 1810.0 mm
