burksbuilds/CNC-Router/Model/Solidworks CAD and Drawings/VISE-MODULAR-FREE.SLDPRT

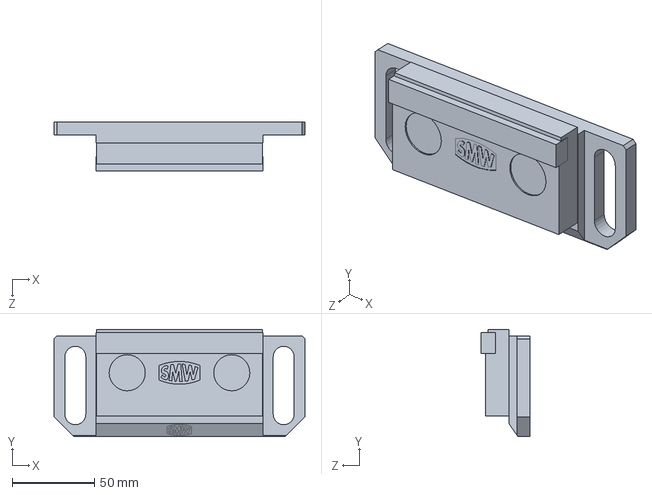
[picture p95: CAD file, 2022-03-06]
Model/Solidworks CAD and Drawings/VISE-MODULAR-FREE.SLDPRT
152.4 x 65.2 x 29.5 mm
