burksbuilds/CNC-Router/Model/Solidworks CAD and Drawings/CNCR-BASE-SG.SLDPRT

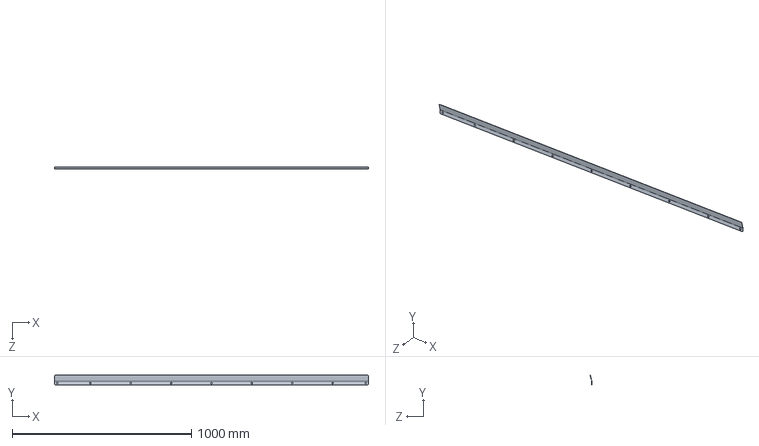
[picture p96: CAD file, 2022-03-06]
Model/Solidworks CAD and Drawings/CNCR-BASE-SG.SLDPRT
1750.0 x 53.9 x 9.98 mm
