burksbuilds/CNC-Router/Model/Solidworks CAD and Drawings/CNCR-GANT-RP-FREE.SLDPRT

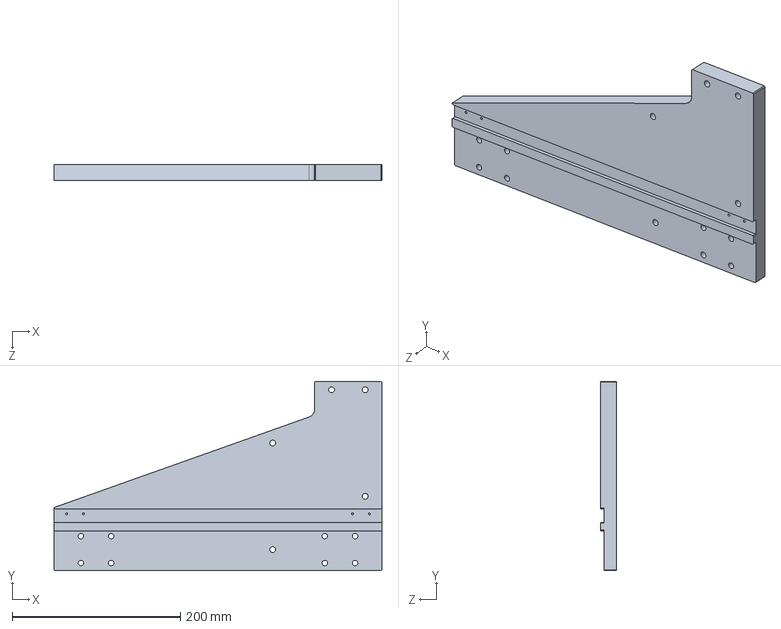
[picture p97: CAD file, 2022-03-06]
Model/Solidworks CAD and Drawings/CNCR-GANT-RP-FREE.SLDPRT
390.0 x 225.0 x 19.1 mm
