burksbuilds/CNC-Router/Model/Solidworks CAD and Drawings/CNCR-BASE-TSE-CBM.SLDPRT

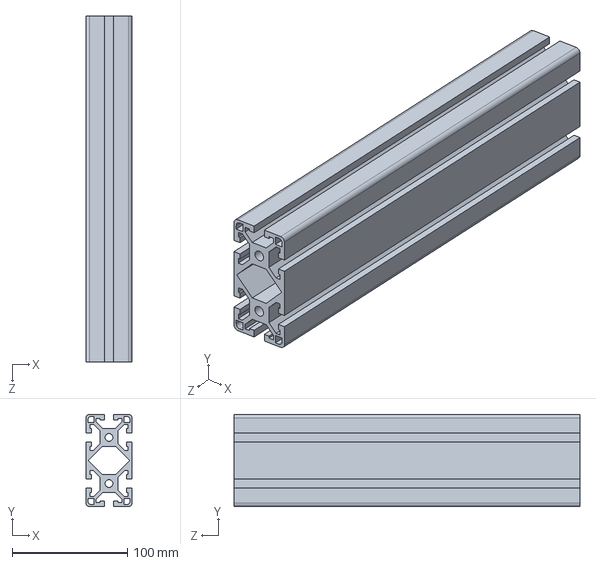
[picture p98: CAD file, 2022-03-06]
Model/Solidworks CAD and Drawings/CNCR-BASE-TSE-CBM.SLDPRT
40.0 x 80.0 x 300.0 mm
