burksbuilds/CNC-Router/Model/Solidworks CAD and Drawings/VISE-MODULAR-FIXED.SLDPRT

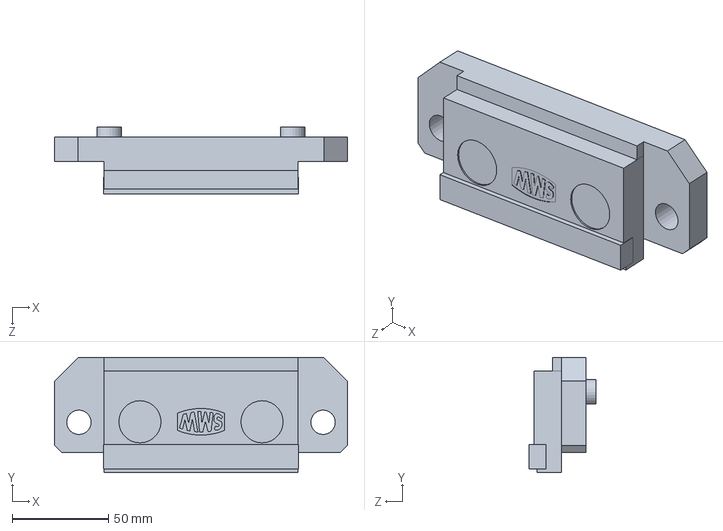
[picture p99: CAD file, 2022-03-06]
Model/Solidworks CAD and Drawings/VISE-MODULAR-FIXED.SLDPRT
152.4 x 59.8 x 34.6 mm
