burksbuilds/CNC-Router/Model/Solidworks CAD and Drawings/ROPE-STEEL.SLDPRT

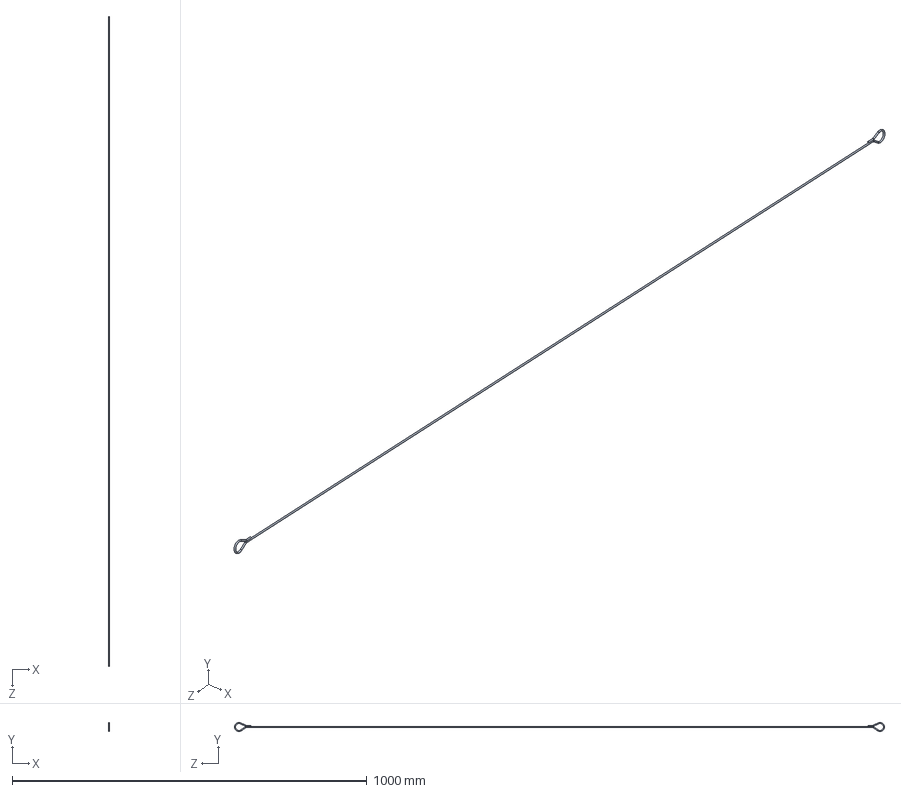
[picture p100: CAD file, 2022-03-06]
Model/Solidworks CAD and Drawings/ROPE-STEEL.SLDPRT
3.17 x 25.4 x 1832.0 mm
