burksbuilds/CNC-Router/Model/Solidworks CAD and Drawings/CNCR-VACT-SB.SLDPRT

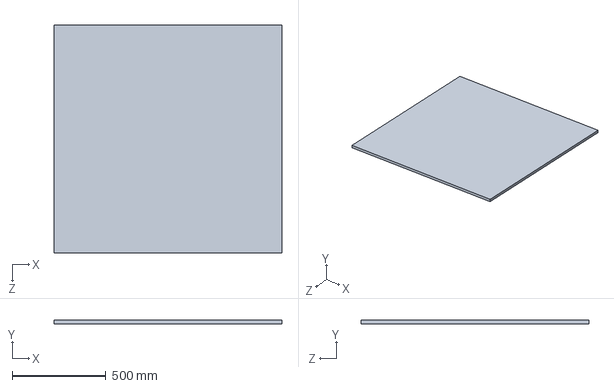
[picture p101: CAD file, 2022-03-06]
Model/Solidworks CAD and Drawings/CNCR-VACT-SB.SLDPRT
1219.2 x 19.1 x 1219.2 mm
