burksbuilds/CNC-Router/Model/Solidworks CAD and Drawings/BBM15.SLDPRT

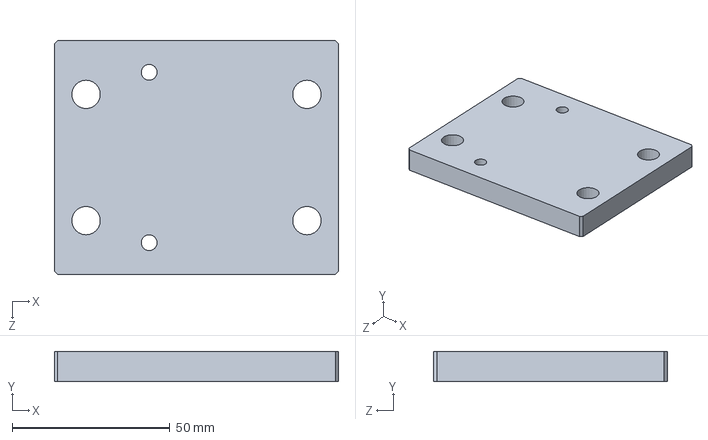
[picture p102: CAD file, 2022-03-06]
Model/Solidworks CAD and Drawings/BBM15.SLDPRT
90.0 x 9.53 x 74.0 mm
