burksbuilds/CNC-Router/Model/Solidworks CAD and Drawings/CNCR-BASE-TSE-MBM.SLDPRT

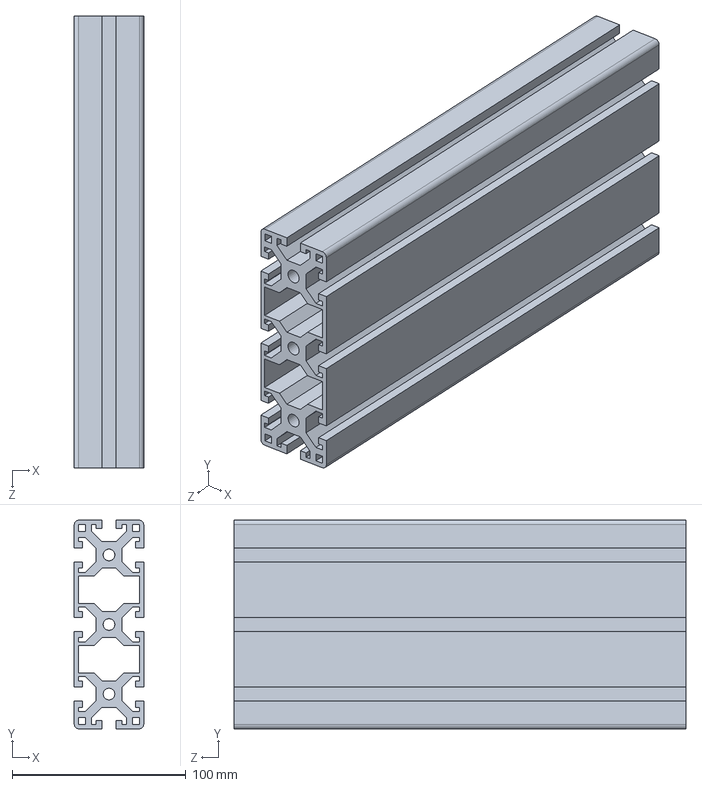
[picture p103: CAD file, 2022-03-06]
Model/Solidworks CAD and Drawings/CNCR-BASE-TSE-MBM.SLDPRT
40.0 x 120.0 x 260.0 mm
