burksbuilds/CNC-Router/Model/Solidworks CAD and Drawings/BBM12.SLDPRT

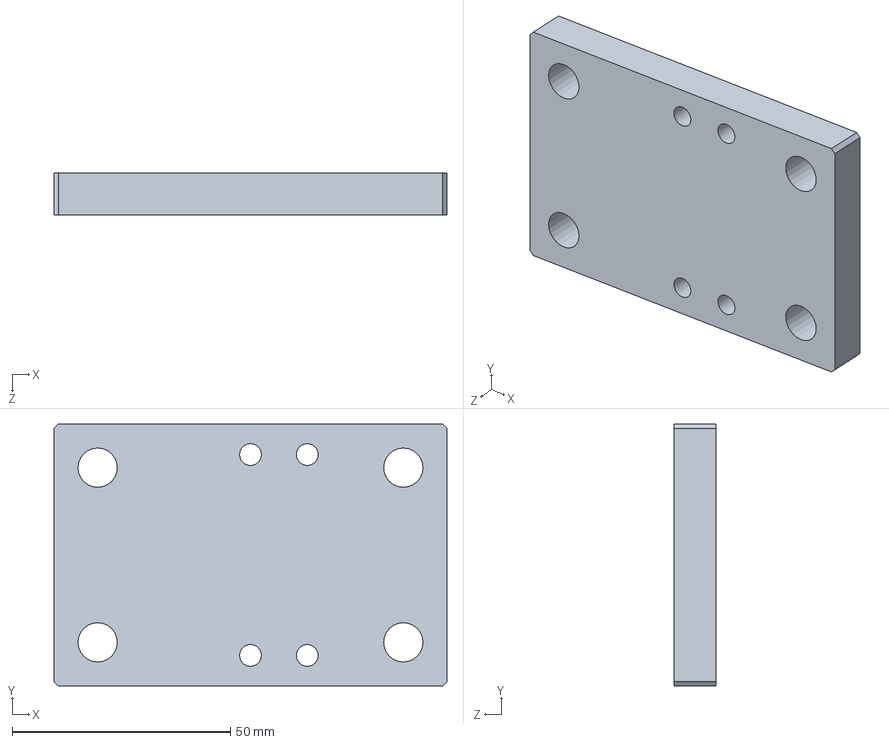
[picture p104: CAD file, 2022-03-06]
Model/Solidworks CAD and Drawings/BBM12.SLDPRT
90.0 x 60.0 x 9.53 mm
