burksbuilds/CNC-Router/Model/Solidworks CAD and Drawings/CNCR-CAR-BNM.SLDPRT

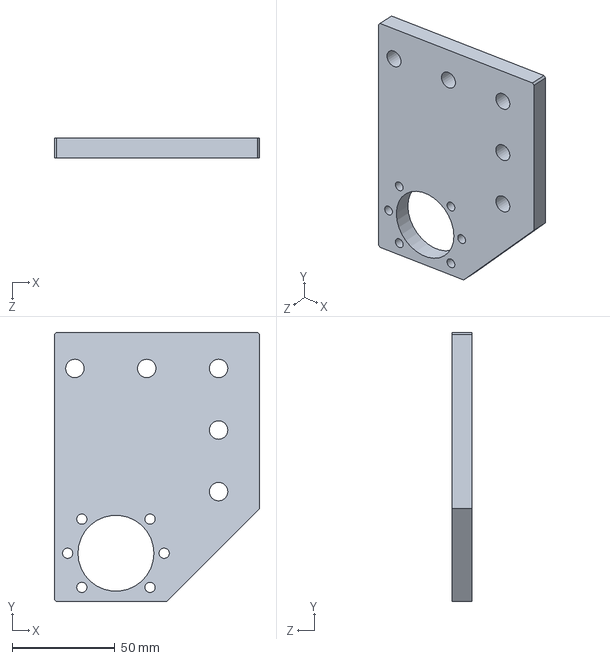
[picture p105: CAD file, 2022-03-06]
Model/Solidworks CAD and Drawings/CNCR-CAR-BNM.SLDPRT
100.0 x 131.0 x 9.53 mm
