burksbuilds/CNC-Router/Model/Solidworks CAD and Drawings/CNCR-STAND-TSE-LEG.SLDPRT

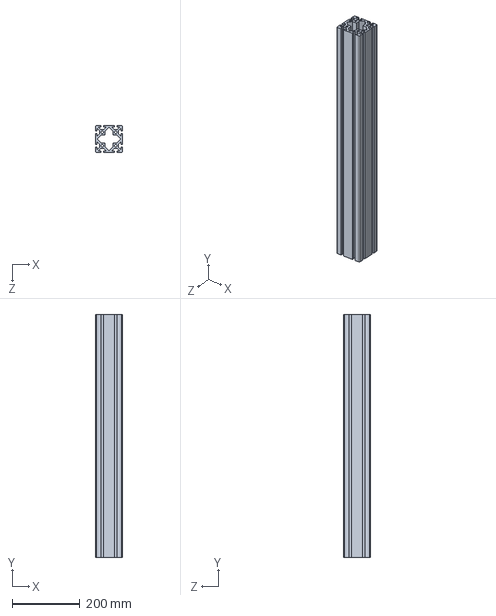
[picture p106: CAD file, 2022-03-06]
Model/Solidworks CAD and Drawings/CNCR-STAND-TSE-LEG.SLDPRT
80.0 x 720.0 x 80.0 mm
