burksbuilds/CNC-Router/Model/Solidworks CAD and Drawings/CNCR-BASE-HS.SLDPRT

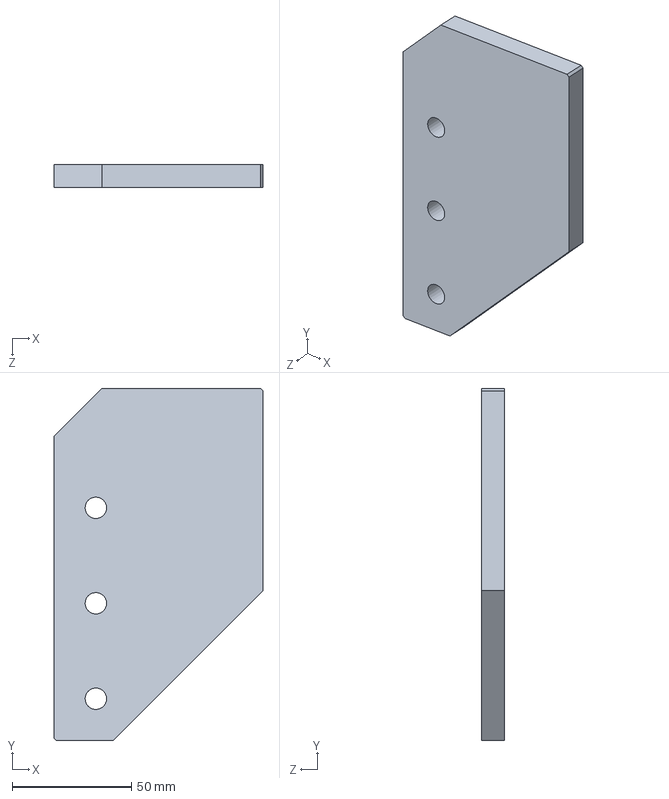
[picture p107: CAD file, 2022-03-06]
Model/Solidworks CAD and Drawings/CNCR-BASE-HS.SLDPRT
87.5 x 147.5 x 9.53 mm
