burksbuilds/CNC-Router/Model/Solidworks CAD and Drawings/CNCR-STAND-SS.SLDPRT

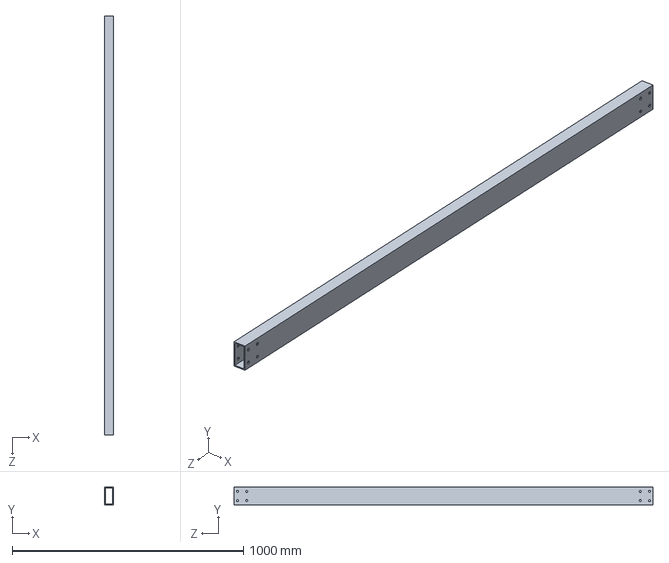
[picture p108: CAD file, 2022-03-06]
Model/Solidworks CAD and Drawings/CNCR-STAND-SS.SLDPRT
38.1 x 76.2 x 1810.0 mm
