burksbuilds/CNC-Router/Model/Solidworks CAD and Drawings/Tool Measure Sensor.SLDPRT

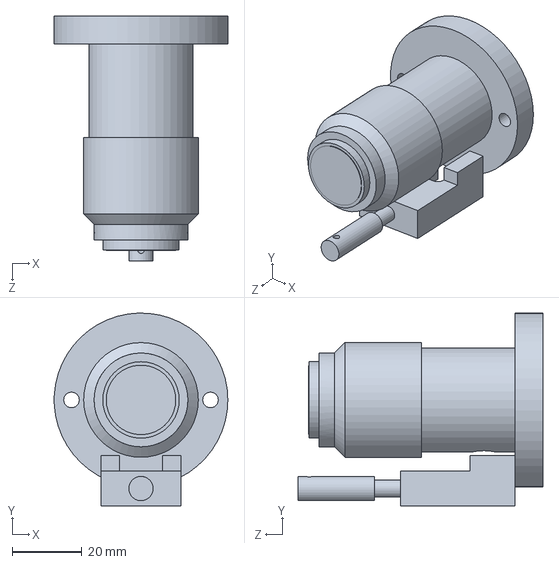
[picture p109: CAD file, 2022-03-06]
Model/Solidworks CAD and Drawings/Tool Measure Sensor.SLDPRT
50.0 x 55.5 x 70.5 mm
