burksbuilds/CNC-Router/Model/Solidworks CAD and Drawings/CNCR-BASE-TSE-IBM.SLDPRT

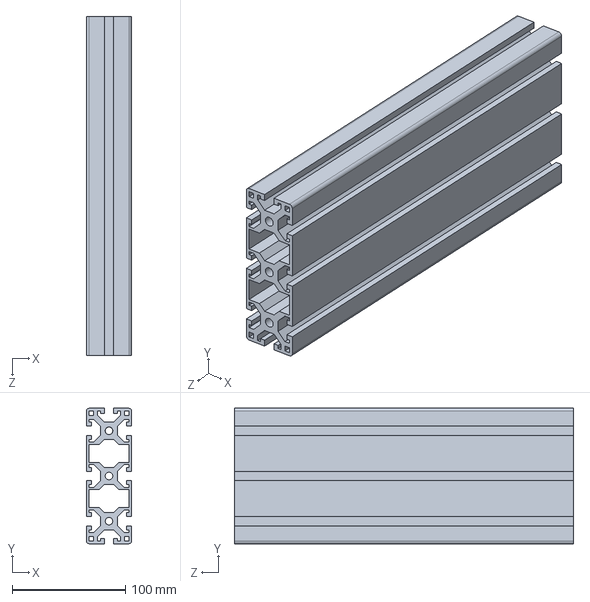
[picture p110: CAD file, 2022-03-06]
Model/Solidworks CAD and Drawings/CNCR-BASE-TSE-IBM.SLDPRT
40.0 x 120.0 x 300.0 mm
