burksbuilds/CNC-Router/Model/Solidworks CAD and Drawings/CNCR-SPIN-CLAMP.SLDPRT

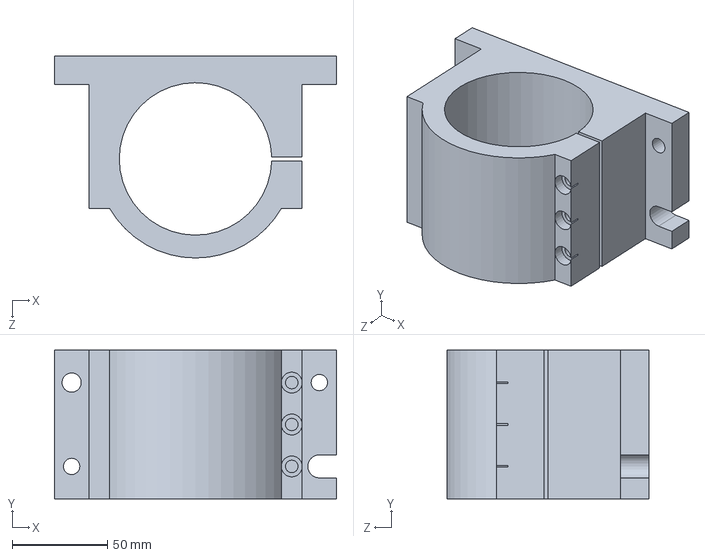
[picture p111: CAD file, 2022-03-06]
Model/Solidworks CAD and Drawings/CNCR-SPIN-CLAMP.SLDPRT
148.0 x 78.0 x 106.0 mm
