burksbuilds/CNC-Router/Model/Solidworks CAD and Drawings/CNCR-SPIN-HS.SLDPRT

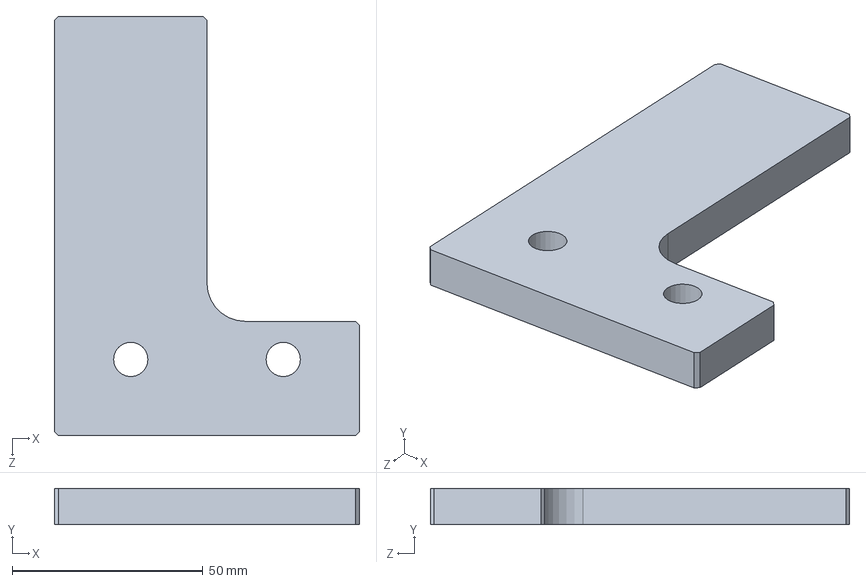
[picture p112: CAD file, 2022-03-06]
Model/Solidworks CAD and Drawings/CNCR-SPIN-HS.SLDPRT
80.0 x 9.53 x 110.0 mm
