burksbuilds/CNC-Router/Model/Solidworks CAD and Drawings/CNCR-STAND-GP.SLDPRT

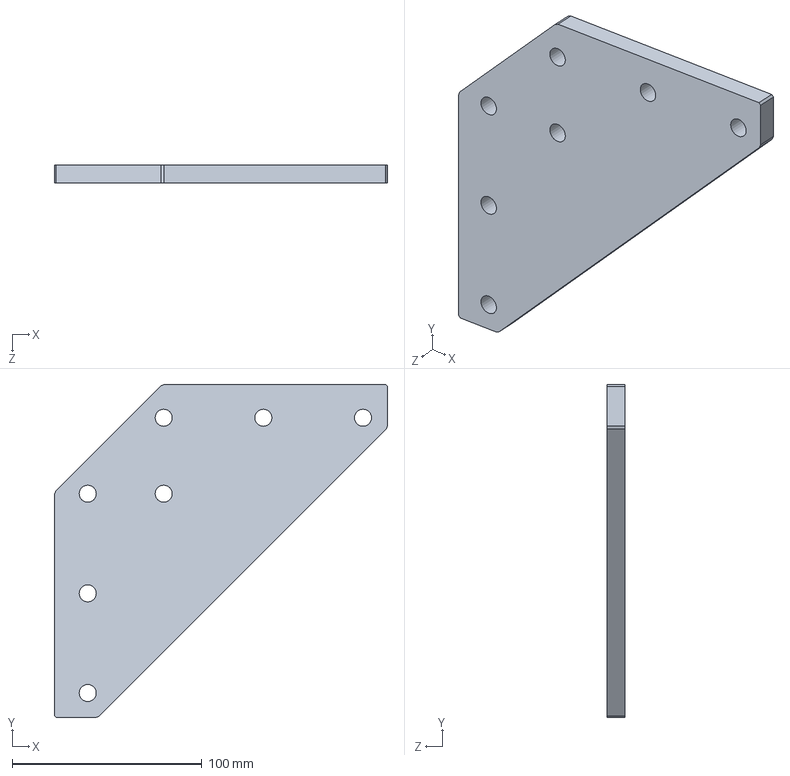
[picture p113: CAD file, 2022-03-06]
Model/Solidworks CAD and Drawings/CNCR-STAND-GP.SLDPRT
175.3 x 175.3 x 9.53 mm
