burksbuilds/CNC-Router/Model/Solidworks CAD and Drawings/CNCR-HSM.SLDPRT

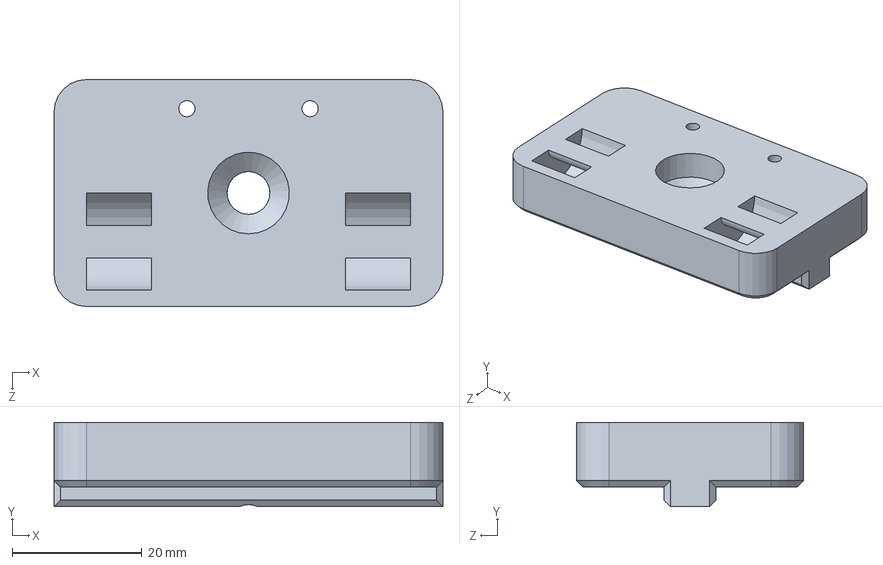
[picture p114: CAD file, 2022-03-06]
Model/Solidworks CAD and Drawings/CNCR-HSM.SLDPRT
60.0 x 13.0 x 35.0 mm
