burksbuilds/CNC-Router/Model/Solidworks CAD and Drawings/CNCR-GANT-ECM.SLDPRT

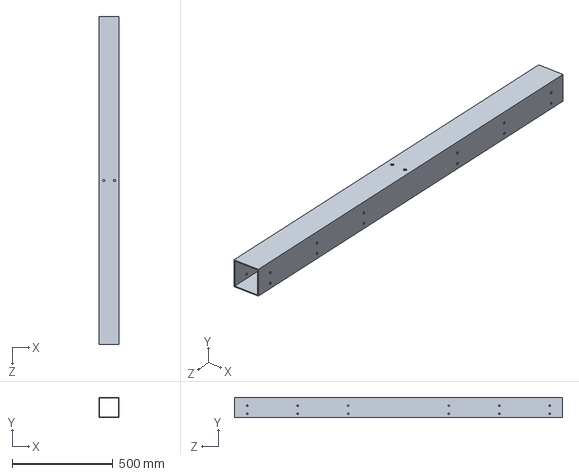
[picture p115: CAD file, 2022-03-06]
Model/Solidworks CAD and Drawings/CNCR-GANT-ECM.SLDPRT
101.6 x 101.6 x 1626.0 mm
