burksbuilds/CNC-Router/Model/Solidworks CAD and Drawings/CNCR-STAND-LB.SLDPRT

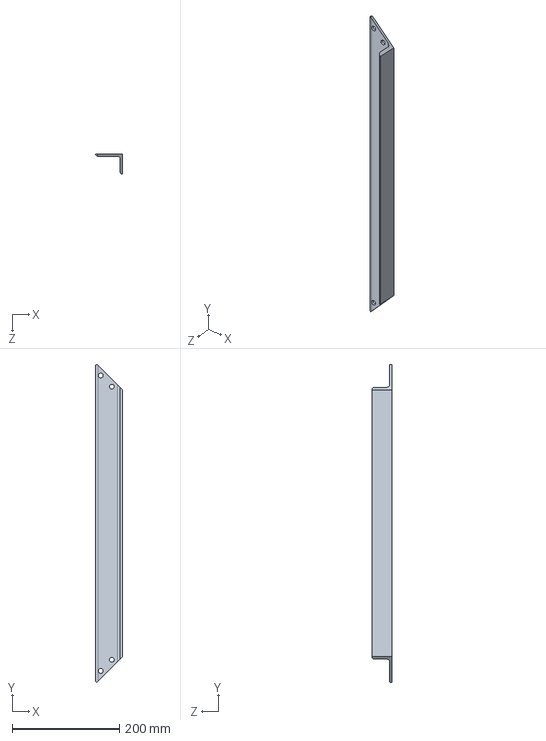
[picture p116: CAD file, 2022-03-06]
Model/Solidworks CAD and Drawings/CNCR-STAND-LB.SLDPRT
50.8 x 594.0 x 38.1 mm
