burksbuilds/CNC-Router/Model/Solidworks CAD and Drawings/CNCR-BASE-MM.SLDPRT

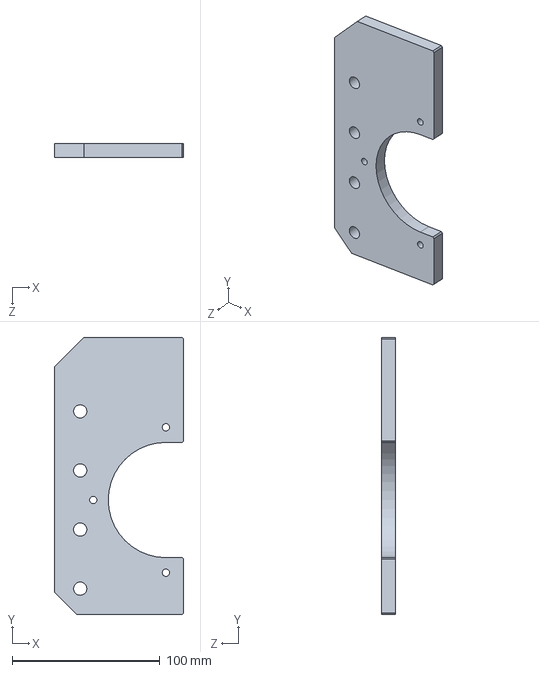
[picture p117: CAD file, 2022-03-06]
Model/Solidworks CAD and Drawings/CNCR-BASE-MM.SLDPRT
87.5 x 187.5 x 9.53 mm
