burksbuilds/CNC-Router/Model/Solidworks CAD and Drawings/CNCR-STAND-BS.SLDPRT

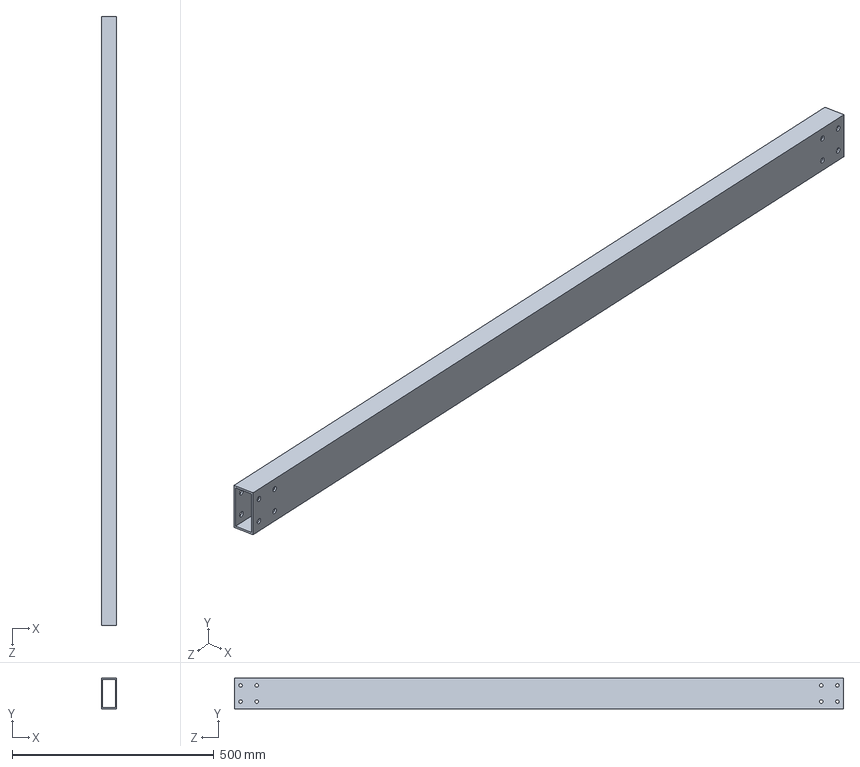
[picture p118: CAD file, 2022-03-06]
Model/Solidworks CAD and Drawings/CNCR-STAND-BS.SLDPRT
38.1 x 76.2 x 1510.0 mm
