burksbuilds/CNC-Router/Model/Solidworks CAD and Drawings/CNCR-BASE-TSE-IM.SLDPRT

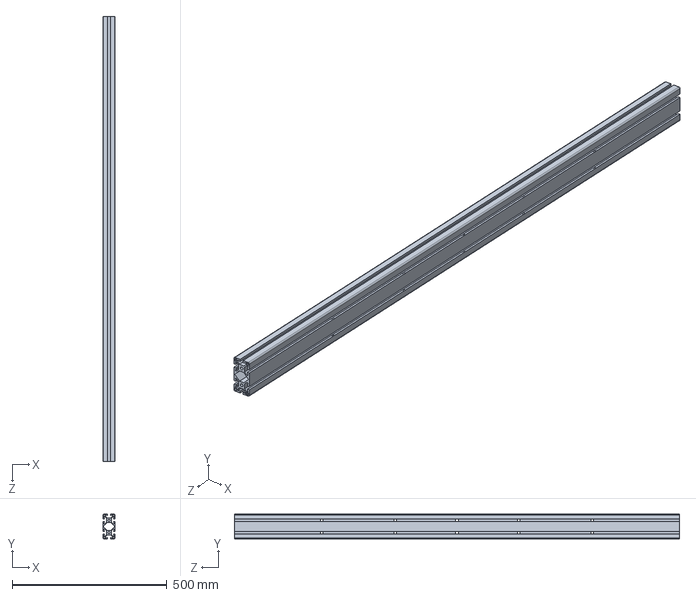
[picture p119: CAD file, 2022-02-03]
Model/Solidworks CAD and Drawings/CNCR-BASE-TSE-IM.SLDPRT
40.0 x 80.0 x 1440.0 mm
