burksbuilds/CNC-Router/Model/Solidworks CAD and Drawings/5 inch mill vise.stp.SLDPRT

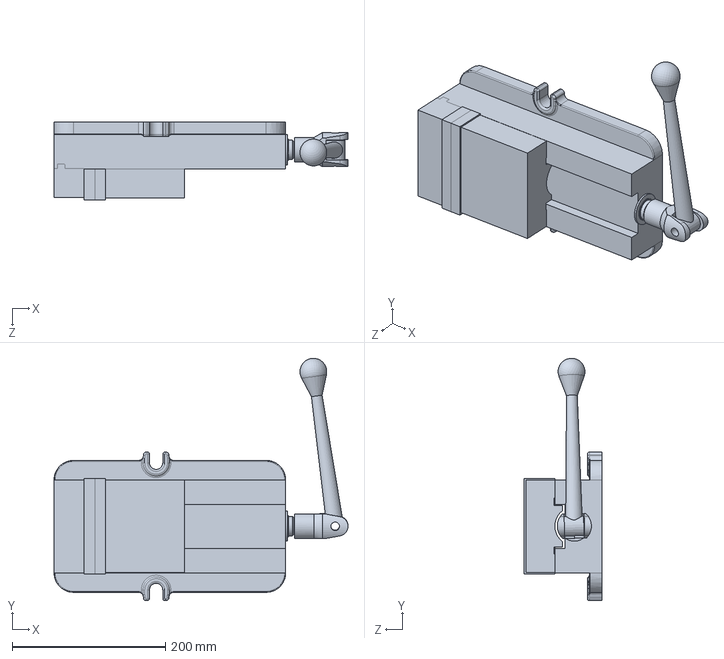
[picture p120: CAD file, 2022-02-03]
Model/Solidworks CAD and Drawings/5 inch mill vise.stp.SLDPRT
383.2 x 316.0 x 101.5 mm
