burksbuilds/CNC-Router/Model/Solidworks CAD and Drawings/2-5in PVC Pipe, Schedule 40.SLDPRT

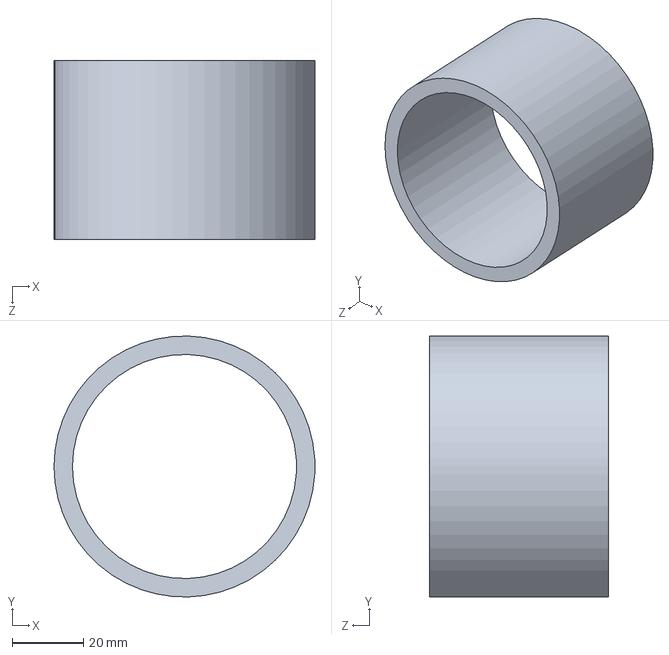
[picture p121: CAD file, 2022-02-03]
Model/Solidworks CAD and Drawings/2-5in PVC Pipe, Schedule 40.SLDPRT
73.0 x 73.0 x 50.0 mm
