burksbuilds/CNC-Router/Model/Solidworks CAD and Drawings/RBELLOWS20.SLDPRT

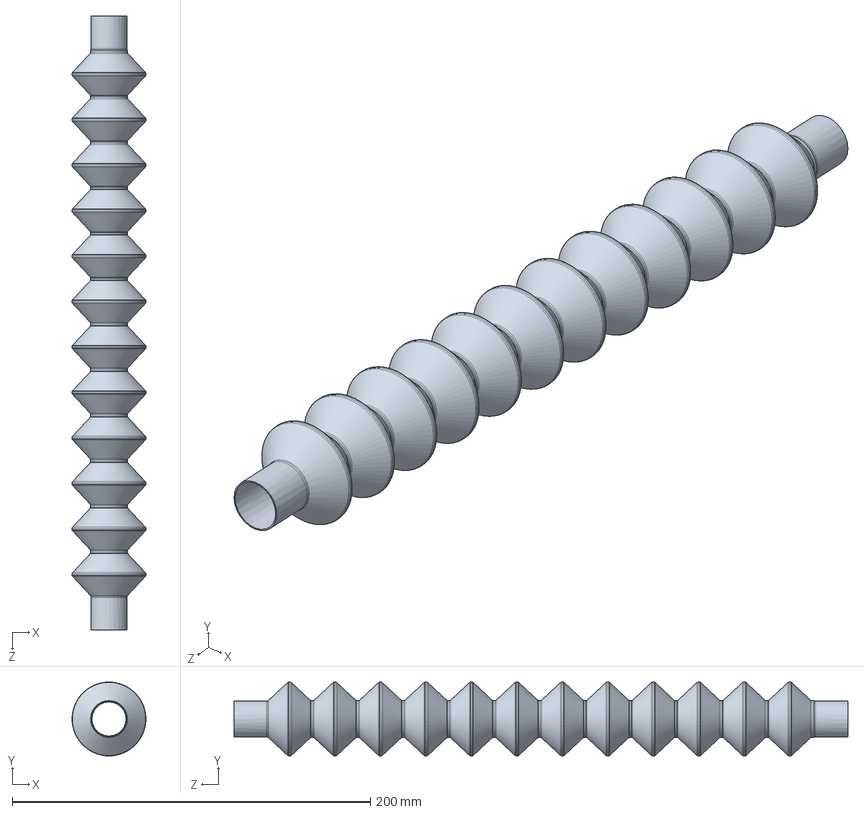
[picture p122: CAD file, 2022-02-03]
Model/Solidworks CAD and Drawings/RBELLOWS20.SLDPRT
41.2 x 41.3 x 342.9 mm
