burksbuilds/CNC-Router/Model/Solidworks CAD and Drawings/PROX-FLAT18.SLDPRT

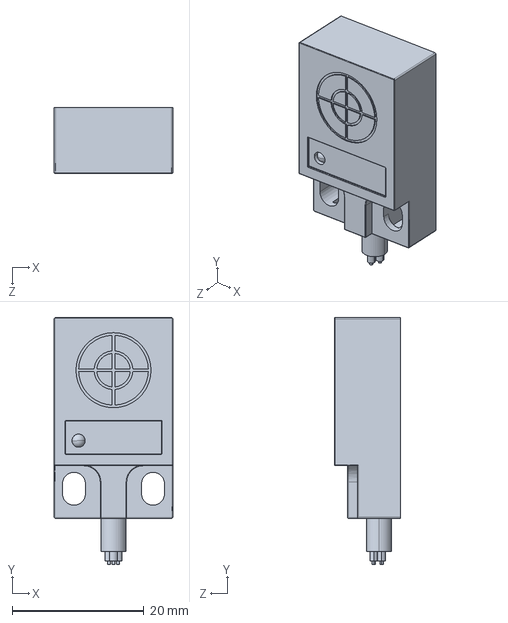
[picture p123: CAD file, 2022-02-03]
Model/Solidworks CAD and Drawings/PROX-FLAT18.SLDPRT
18.0 x 37.5 x 10.0 mm
