burksbuilds/CNC-Router/Model/Solidworks CAD and Drawings/0-7-16 x 1-5in Single Acting Cylinder - Bimba 0115_NTQ.SLDPRT

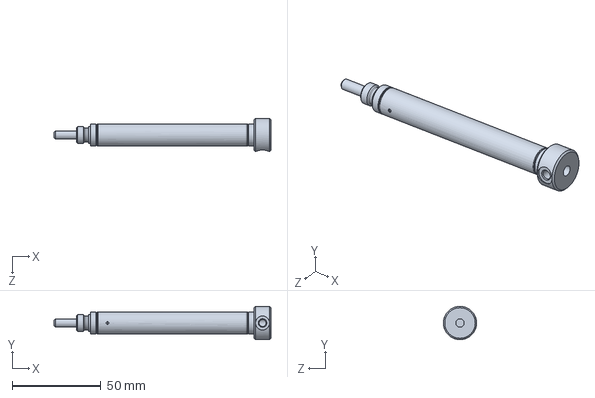
[picture p124: CAD file, 2022-02-03]
Model/Solidworks CAD and Drawings/0-7-16 x 1-5in Single Acting Cylinder - Bimba 0115_NTQ.SLDPRT
122.4 x 18.7 x 18.7 mm
