burksbuilds/CNC-Router/Model/Solidworks CAD and Drawings/PROX-FLAT12.SLDPRT

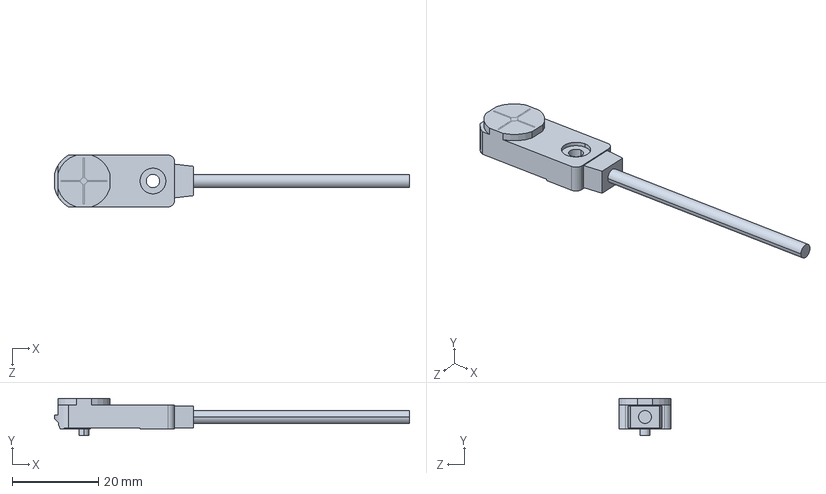
[picture p125: CAD file, 2022-02-03]
Model/Solidworks CAD and Drawings/PROX-FLAT12.SLDPRT
82.2 x 8.60 x 12.0 mm
