burksbuilds/CNC-Router/Model/Solidworks CAD and Drawings/CNCR-VACT-PB.SLDPRT

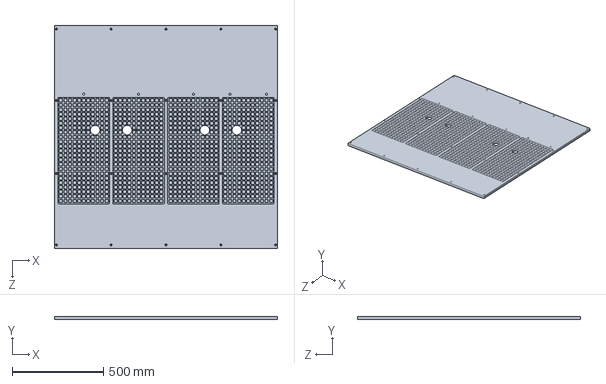
[picture p126: CAD file, 2022-02-03]
Model/Solidworks CAD and Drawings/CNCR-VACT-PB.SLDPRT
1220.0 x 19.1 x 1220.0 mm
