burksbuilds/CNC-Router/Model/Solidworks CAD and Drawings/CNCR-BASE-TSE-OM.SLDPRT

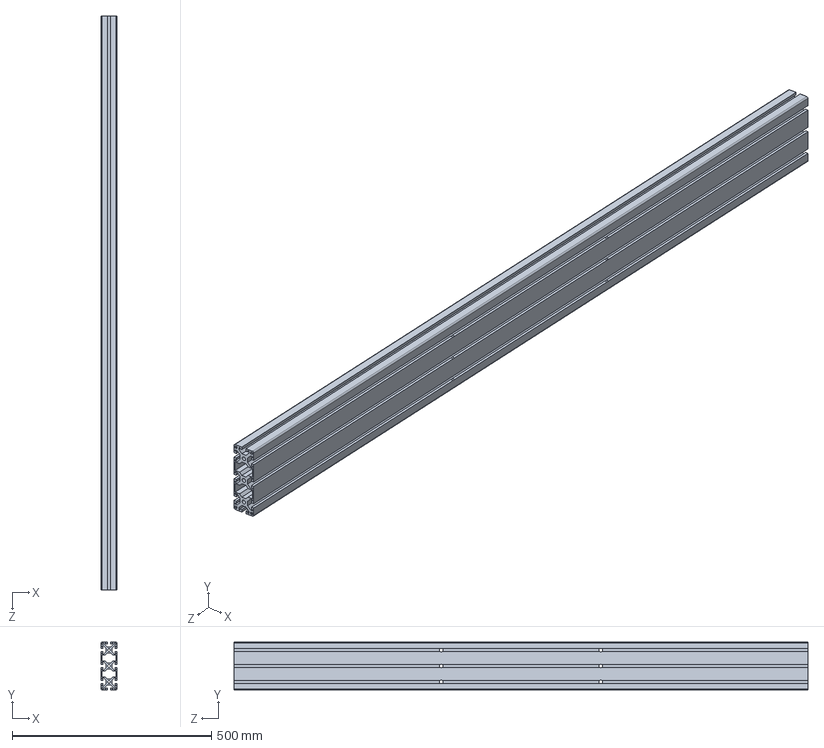
[picture p127: CAD file, 2022-02-03]
Model/Solidworks CAD and Drawings/CNCR-BASE-TSE-OM.SLDPRT
40.0 x 120.0 x 1440.0 mm
