burksbuilds/CNC-Router/Model/Solidworks CAD and Drawings/CNCR-CAR-SC.SLDPRT

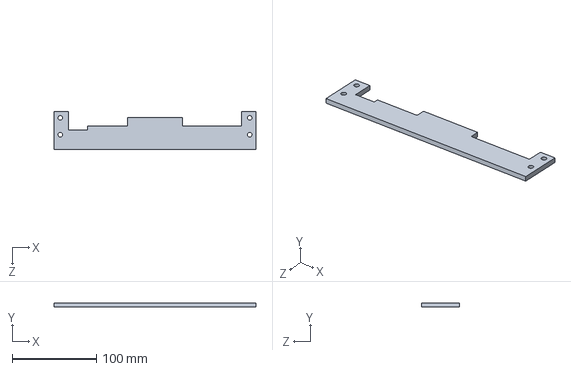
[picture p128: CAD file, 2022-02-03]
Model/Solidworks CAD and Drawings/CNCR-CAR-SC.SLDPRT
240.0 x 5.00 x 45.0 mm
