burksbuilds/CNC-Router/Model/Solidworks CAD and Drawings/M5-M8-INSERT.SLDPRT

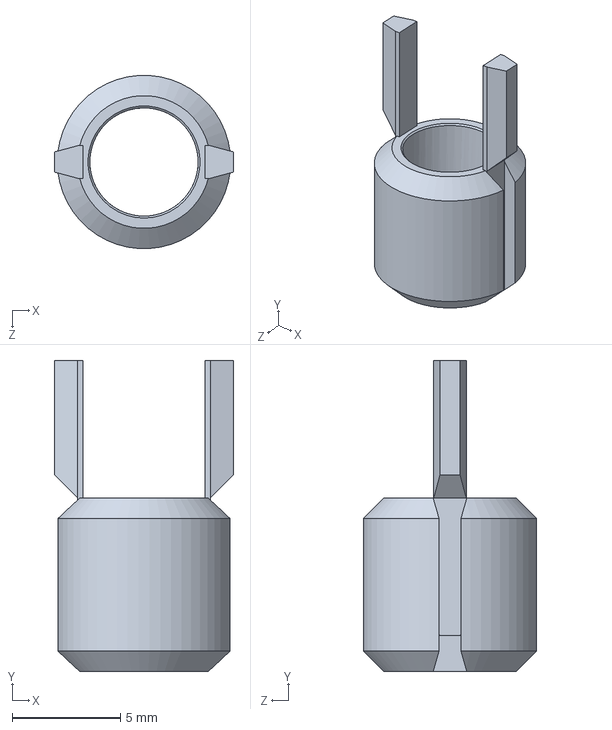
[picture p129: CAD file, 2022-02-03]
Model/Solidworks CAD and Drawings/M5-M8-INSERT.SLDPRT
8.27 x 14.4 x 7.98 mm
