burksbuilds/CNC-Router/Model/Solidworks CAD and Drawings/CNCR-STAND-LEG-WELD.SLDPRT

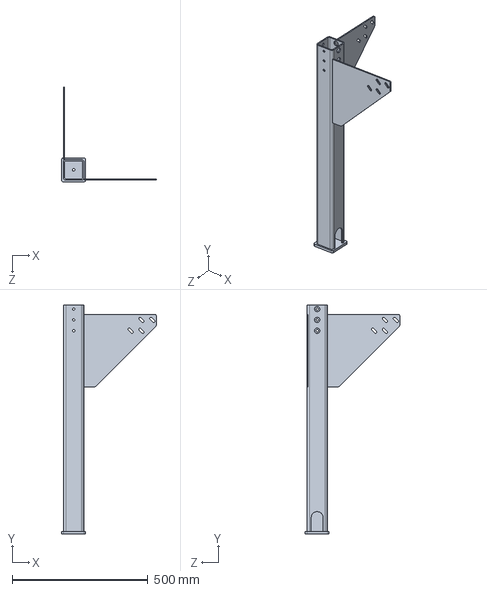
[picture p130: CAD file, 2022-02-03]
Model/Solidworks CAD and Drawings/CNCR-STAND-LEG-WELD.SLDPRT
349.5 x 844.5 x 349.5 mm
