burksbuilds/CNC-Router/Model/Solidworks CAD and Drawings/PROX-M12-NF.SLDPRT

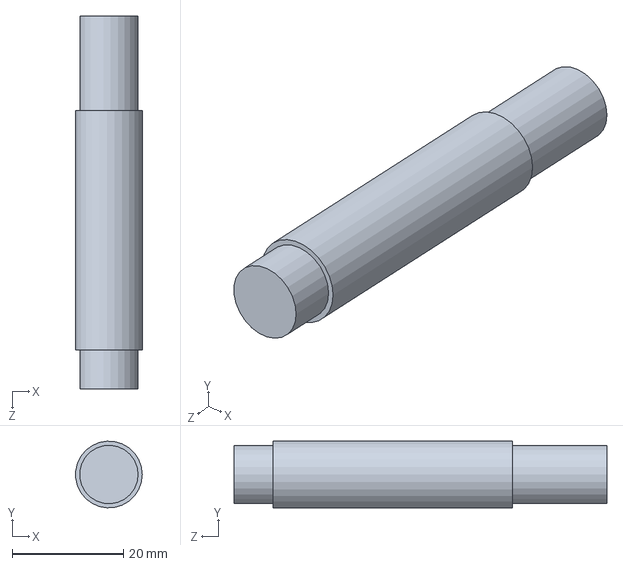
[picture p131: CAD file, 2022-02-03]
Model/Solidworks CAD and Drawings/PROX-M12-NF.SLDPRT
12.0 x 12.0 x 67.0 mm
