burksbuilds/CNC-Router/Model/Solidworks CAD and Drawings/VFD, 2-2kw - HuanYang.SLDPRT

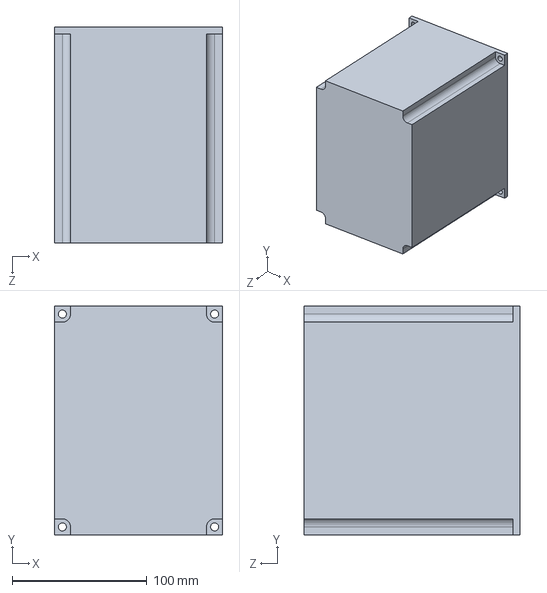
[picture p132: CAD file, 2022-01-21]
Model/Solidworks CAD and Drawings/VFD, 2-2kw - HuanYang.SLDPRT
125.0 x 170.0 x 160.0 mm
