burksbuilds/CNC-Router/Model/Solidworks CAD and Drawings/BALLNUT1204.SLDPRT

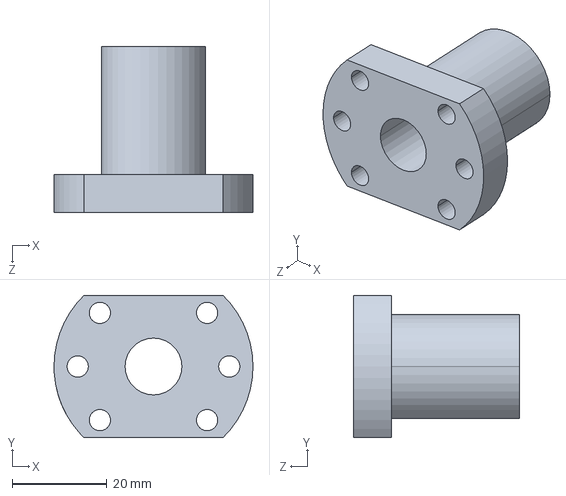
[picture p133: CAD file, 2022-01-21]
Model/Solidworks CAD and Drawings/BALLNUT1204.SLDPRT
42.0 x 30.0 x 35.0 mm
