burksbuilds/CNC-Router/Model/Solidworks CAD and Drawings/BK12.SLDPRT

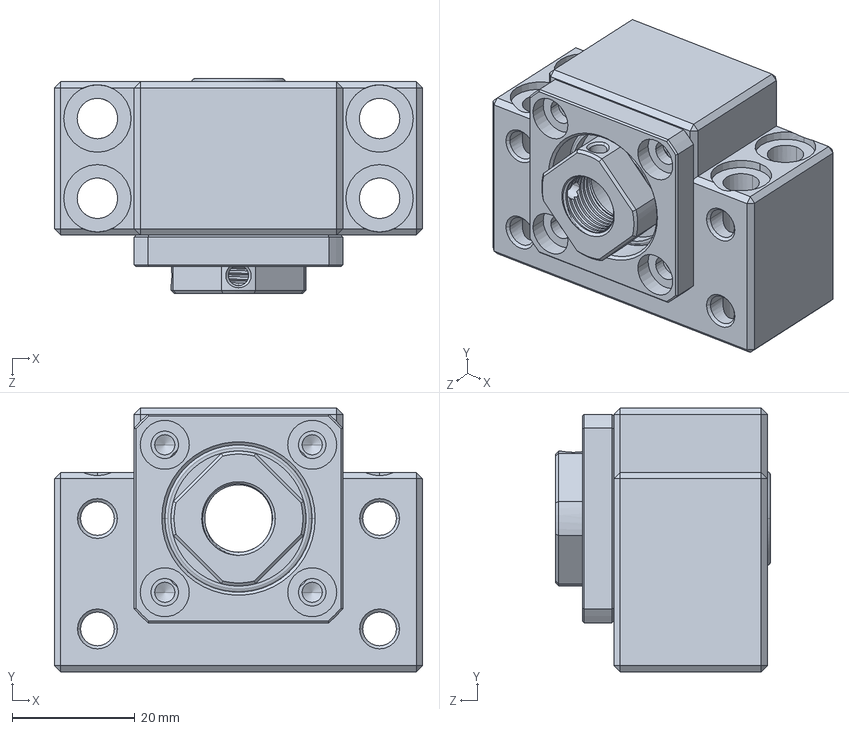
[picture p134: CAD file, 2022-01-21]
Model/Solidworks CAD and Drawings/BK12.SLDPRT
60.0 x 43.0 x 35.0 mm
