burksbuilds/CNC-Router/Model/Solidworks CAD and Drawings/NEMA23.SLDPRT

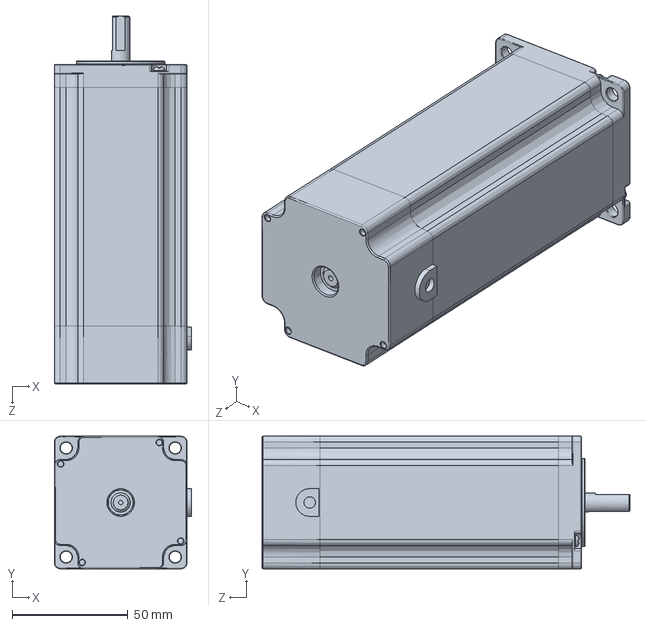
[picture p135: CAD file, 2022-01-21]
Model/Solidworks CAD and Drawings/NEMA23.SLDPRT
59.3 x 57.3 x 159.0 mm
