burksbuilds/CNC-Router/Model/Solidworks CAD and Drawings/2-5in Elbow - 4880K103.SLDPRT

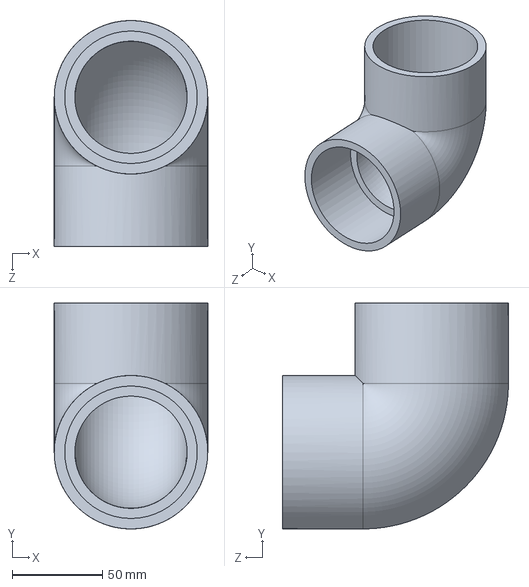
[picture p136: CAD file, 2022-01-21]
Model/Solidworks CAD and Drawings/2-5in Elbow - 4880K103.SLDPRT
84.9 x 125.0 x 125.0 mm
