burksbuilds/CNC-Router/Model/Solidworks CAD and Drawings/M8-ENUT.SLDPRT

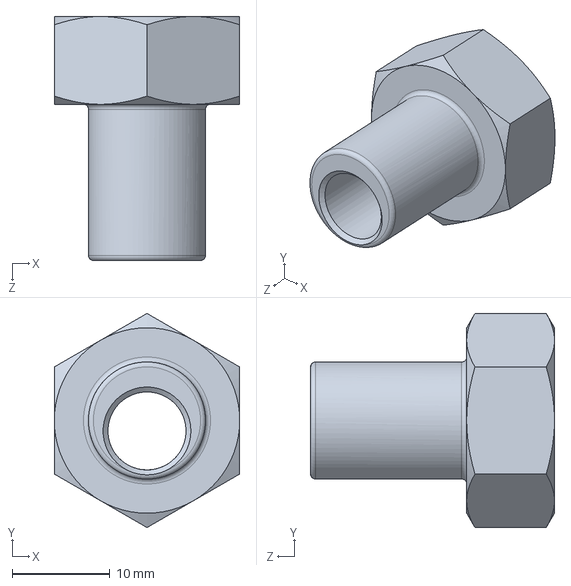
[picture p137: CAD file, 2022-01-21]
Model/Solidworks CAD and Drawings/M8-ENUT.SLDPRT
19.0 x 21.9 x 25.0 mm
