burksbuilds/CNC-Router/Model/Solidworks CAD and Drawings/M8-FOOT.SLDPRT

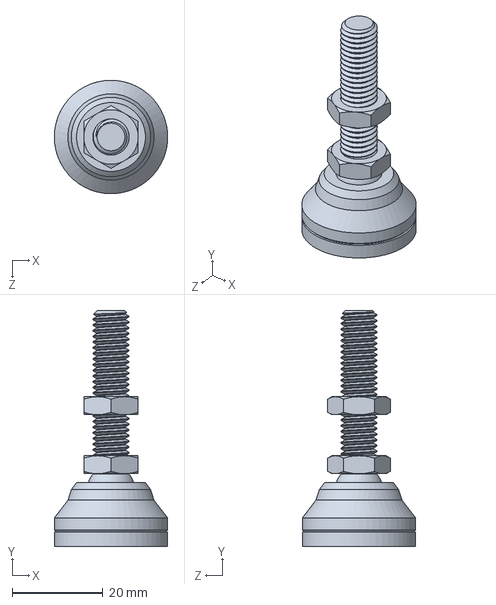
[picture p138: CAD file, 2022-01-21]
Model/Solidworks CAD and Drawings/M8-FOOT.SLDPRT
25.0 x 52.0 x 25.0 mm
