burksbuilds/CNC-Router/Model/Solidworks CAD and Drawings/M6-FLNUT.SLDPRT

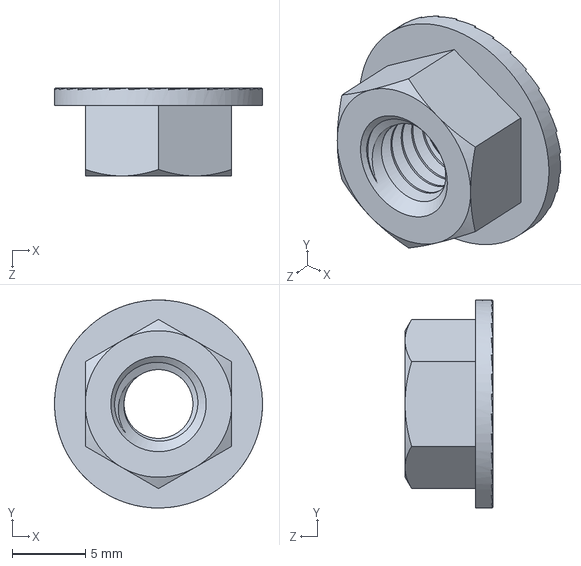
[picture p139: CAD file, 2022-01-21]
Model/Solidworks CAD and Drawings/M6-FLNUT.SLDPRT
14.2 x 14.2 x 6.00 mm
