burksbuilds/CNC-Router/Model/Solidworks CAD and Drawings/HOOK-S-10mm.SLDPRT

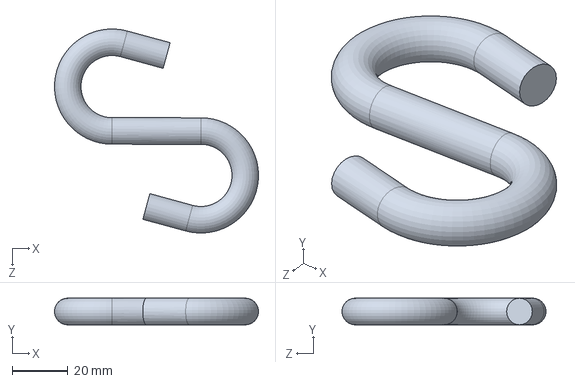
[picture p140: CAD file, 2022-01-21]
Model/Solidworks CAD and Drawings/HOOK-S-10mm.SLDPRT
72.9 x 9.53 x 72.9 mm
