burksbuilds/CNC-Router/Model/Solidworks CAD and Drawings/M6-TSN40-BALL.SLDPRT

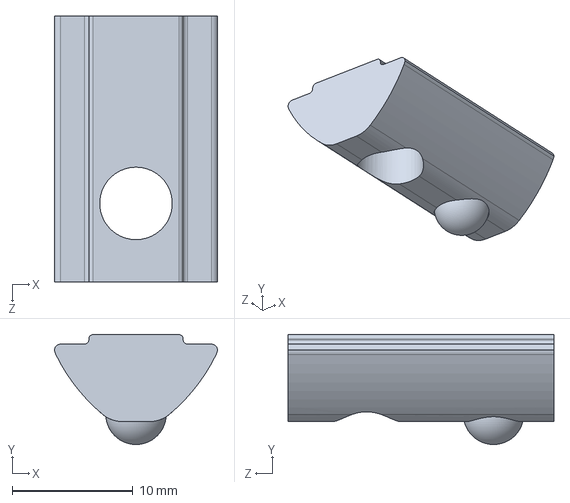
[picture p141: CAD file, 2022-01-21]
Model/Solidworks CAD and Drawings/M6-TSN40-BALL.SLDPRT
13.5 x 9.10 x 22.0 mm
