burksbuilds/CNC-Router/Model/Solidworks CAD and Drawings/BOXCOV-4x4.SLDPRT

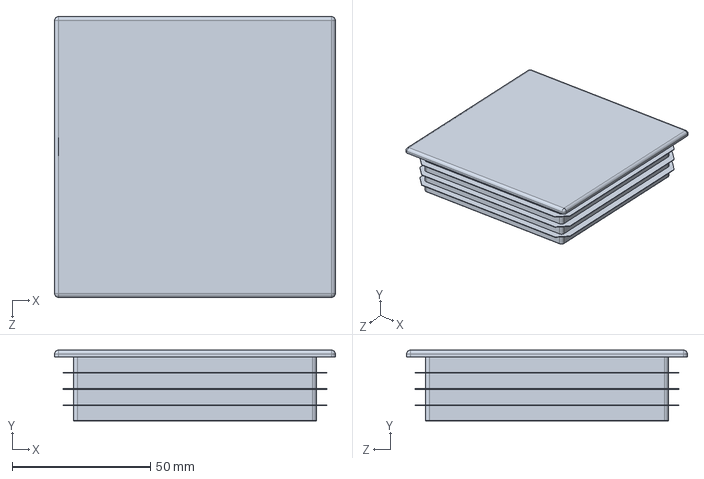
[picture p142: CAD file, 2022-01-21]
Model/Solidworks CAD and Drawings/BOXCOV-4x4.SLDPRT
101.6 x 25.7 x 101.6 mm
