burksbuilds/CNC-Router/Model/Solidworks CAD and Drawings/BF15.SLDPRT

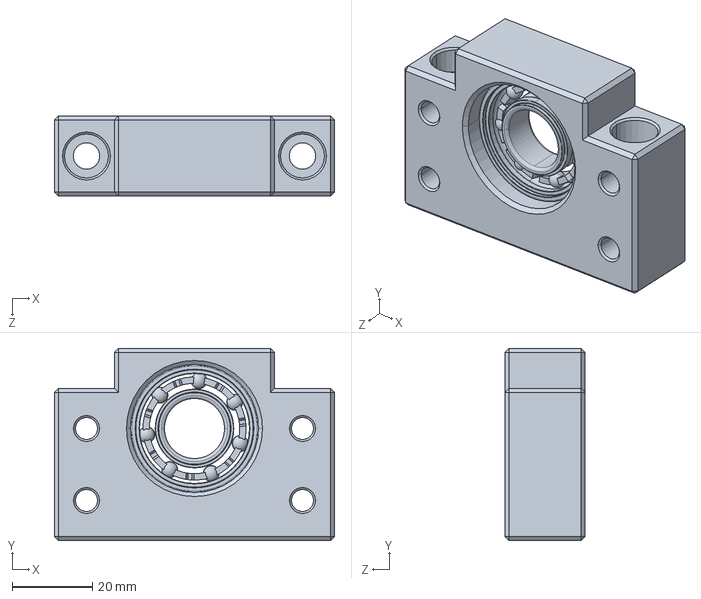
[picture p143: CAD file, 2022-01-21]
Model/Solidworks CAD and Drawings/BF15.SLDPRT
70.0 x 48.0 x 20.0 mm
