burksbuilds/CNC-Router/Model/Solidworks CAD and Drawings/HUB33-CON.SLDPRT

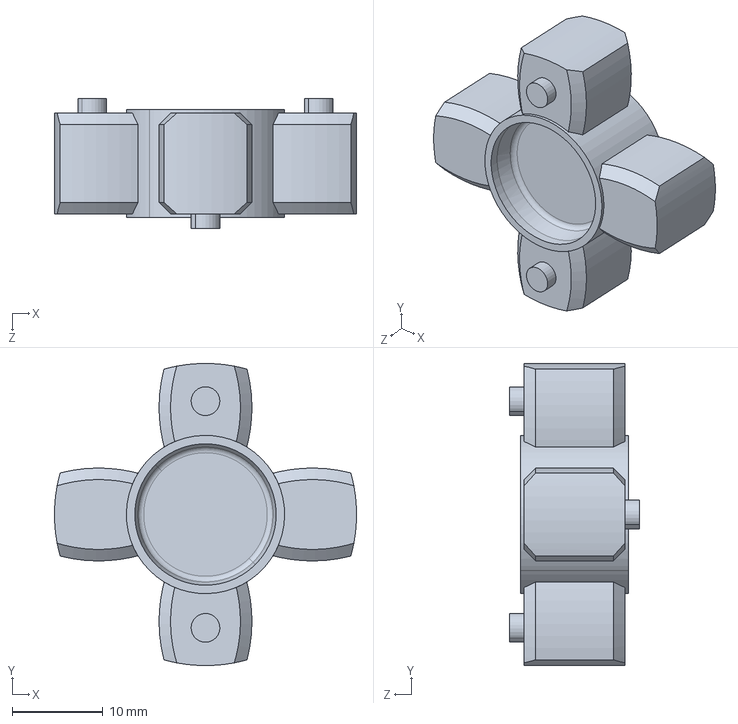
[picture p144: CAD file, 2022-01-21]
Model/Solidworks CAD and Drawings/HUB33-CON.SLDPRT
33.3 x 33.3 x 14.3 mm
