burksbuilds/CNC-Router/Model/Solidworks CAD and Drawings/3in Blast Gate - 17385K72.SLDPRT

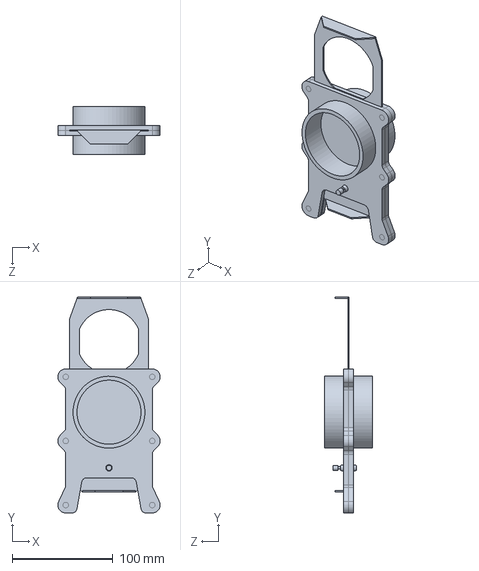
[picture p145: CAD file, 2022-01-21]
Model/Solidworks CAD and Drawings/3in Blast Gate - 17385K72.SLDPRT
101.6 x 214.4 x 47.8 mm
