burksbuilds/CNC-Router/Model/Solidworks CAD and Drawings/Cylinder Mount.SLDPRT

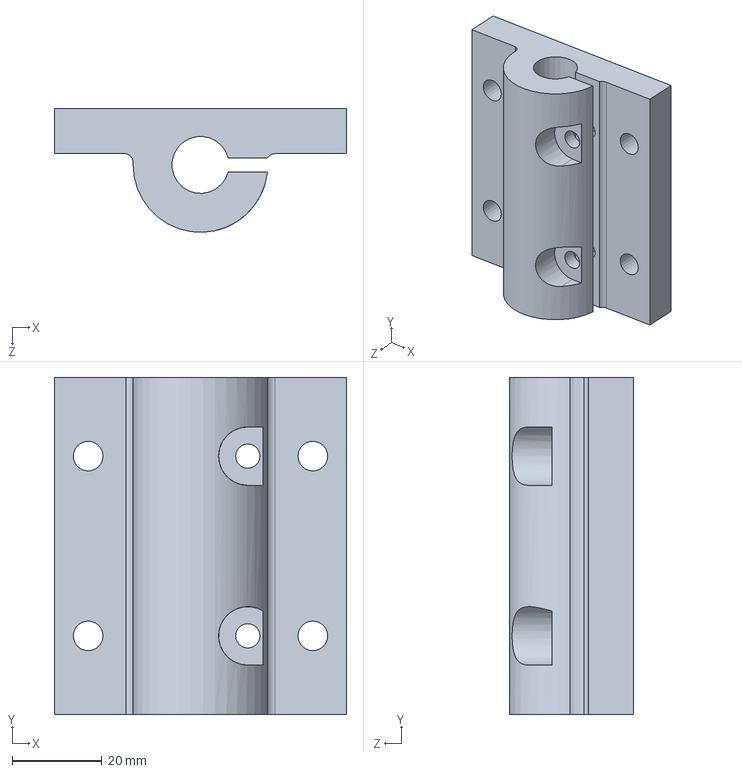
[picture p146: CAD file, 2022-01-21]
Model/Solidworks CAD and Drawings/Cylinder Mount.SLDPRT
65.0 x 75.0 x 27.5 mm
