burksbuilds/CNC-Router/Model/Solidworks CAD and Drawings/BALLNUT2010.SLDPRT

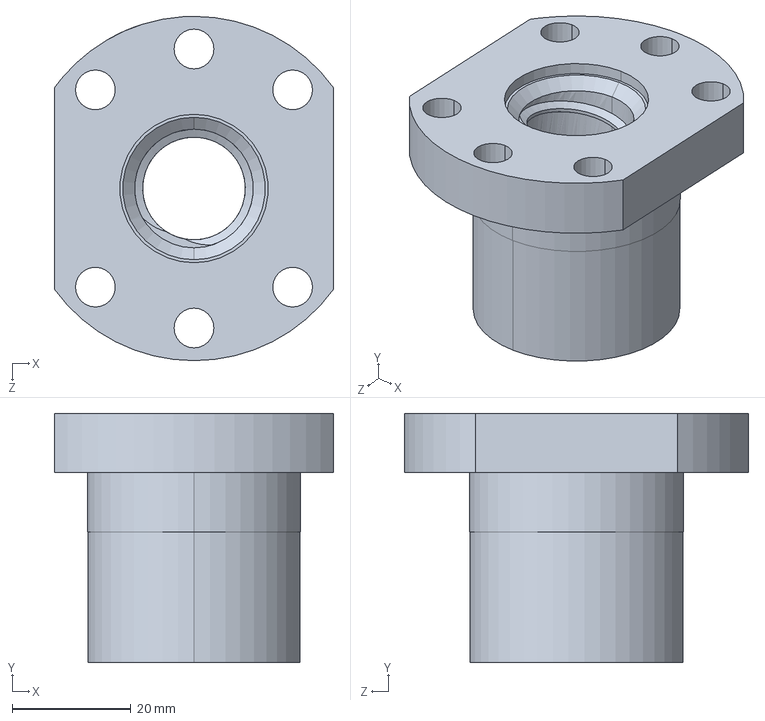
[picture p147: CAD file, 2022-01-21]
Model/Solidworks CAD and Drawings/BALLNUT2010.SLDPRT
47.0 x 42.0 x 58.0 mm
