burksbuilds/CNC-Router/Model/Solidworks CAD and Drawings/LS-TB-L.SLDPRT

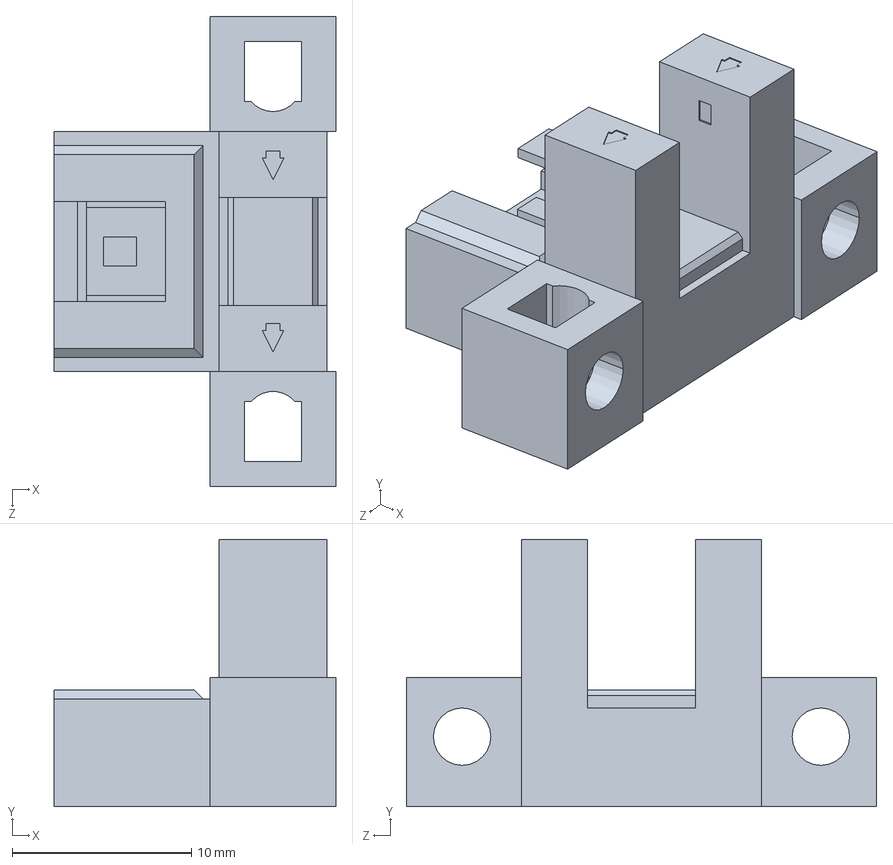
[picture p148: CAD file, 2022-01-21]
Model/Solidworks CAD and Drawings/LS-TB-L.SLDPRT
15.7 x 14.9 x 26.2 mm
