burksbuilds/CNC-Router/Model/Solidworks CAD and Drawings/BF10.SLDPRT

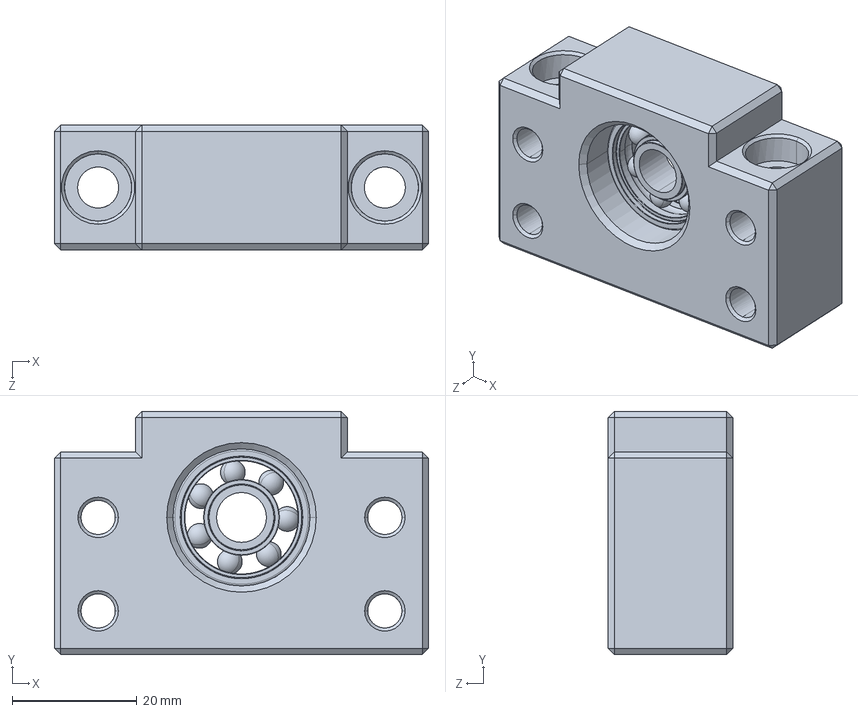
[picture p150: CAD file, 2022-01-21]
Model/Solidworks CAD and Drawings/BF10.SLDPRT
60.0 x 39.0 x 20.0 mm
