burksbuilds/CNC-Router/Model/Solidworks CAD and Drawings/M8-TSB40-CORNER.SLDPRT

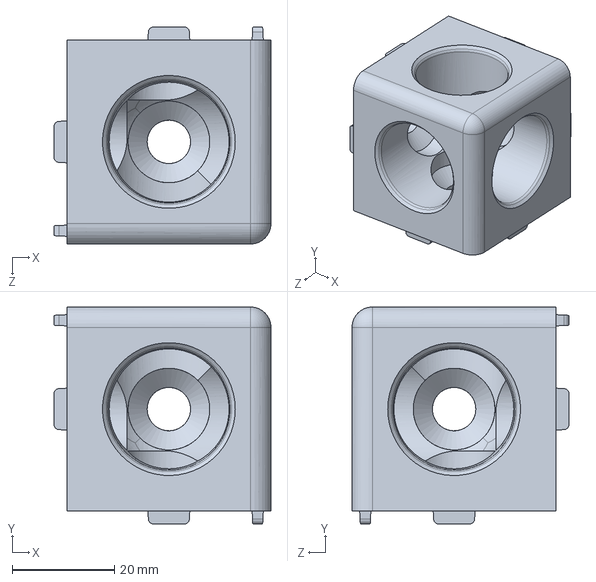
[picture p151: CAD file, 2022-01-21]
Model/Solidworks CAD and Drawings/M8-TSB40-CORNER.SLDPRT
42.5 x 42.5 x 42.5 mm
