burksbuilds/CNC-Router/Model/Solidworks CAD and Drawings/SPINDLE80.SLDPRT

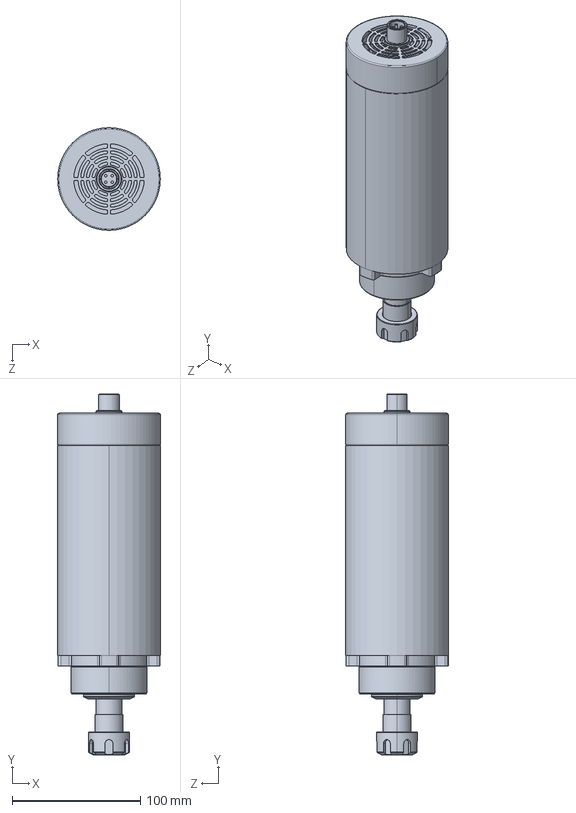
[picture p152: CAD file, 2022-01-21]
Model/Solidworks CAD and Drawings/SPINDLE80.SLDPRT
80.0 x 281.5 x 80.0 mm
