burksbuilds/CNC-Router/Model/Solidworks CAD and Drawings/HUB33-12.SLDPRT

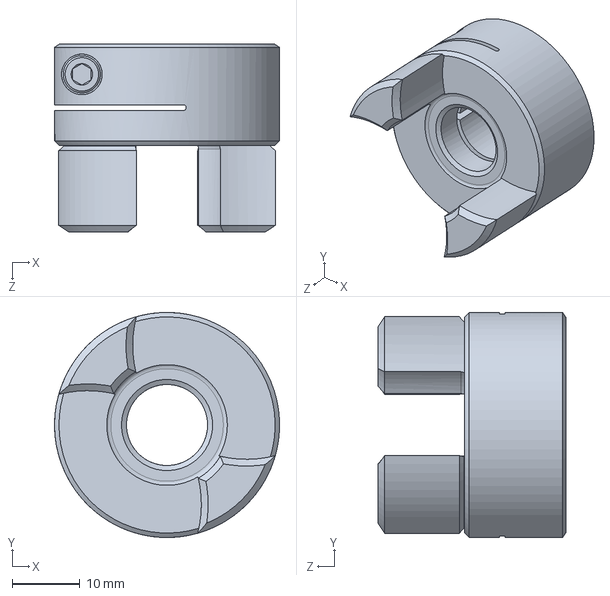
[picture p153: CAD file, 2022-01-21]
Model/Solidworks CAD and Drawings/HUB33-12.SLDPRT
33.3 x 33.3 x 27.8 mm
