burksbuilds/CNC-Router/Model/Solidworks CAD and Drawings/2-5in Cap - 4880K143.SLDPRT

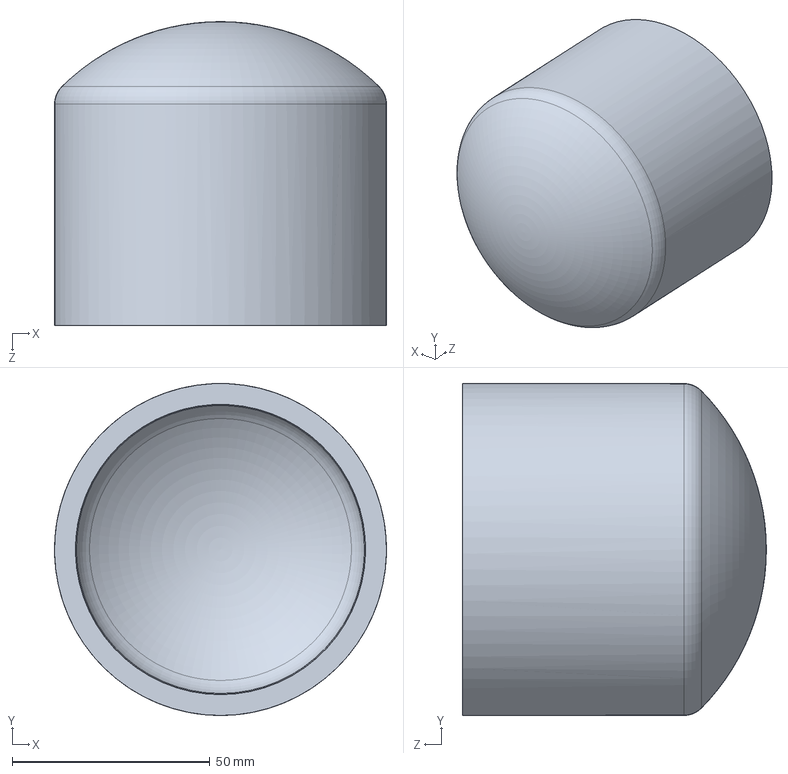
[picture p154: CAD file, 2022-01-21]
Model/Solidworks CAD and Drawings/2-5in Cap - 4880K143.SLDPRT
83.9 x 83.9 x 76.8 mm
