burksbuilds/CNC-Router/Model/Solidworks CAD and Drawings/CNCR-GANT-TSE-BEAM.SLDPRT

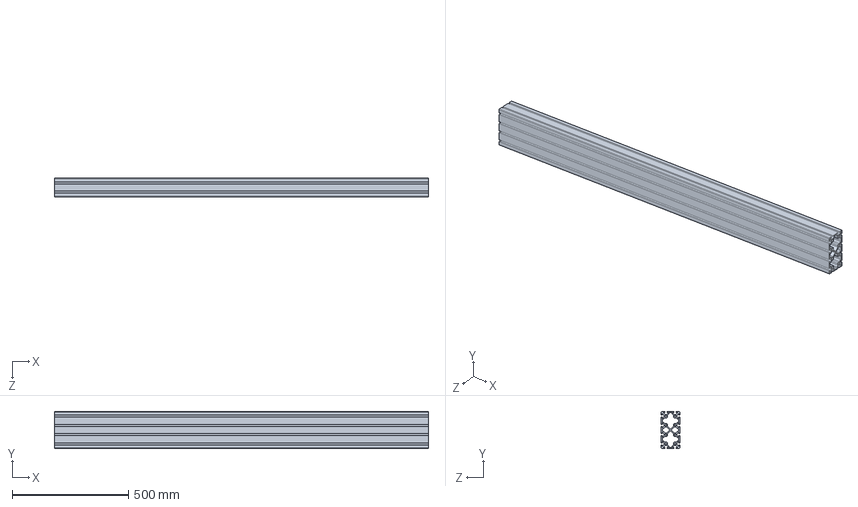
[picture p155: CAD file, 2022-01-21]
Model/Solidworks CAD and Drawings/CNCR-GANT-TSE-BEAM.SLDPRT
1610.0 x 160.0 x 80.0 mm
