burksbuilds/CNC-Router/Model/Solidworks CAD and Drawings/RAIL20-1600.SLDPRT

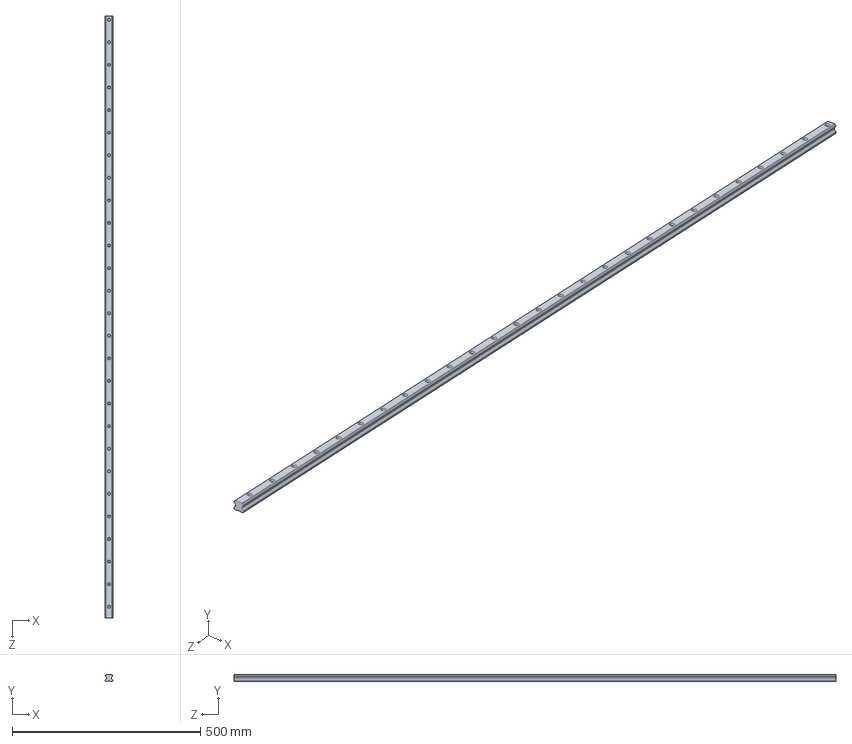
[picture p156: CAD file, 2022-01-21]
Model/Solidworks CAD and Drawings/RAIL20-1600.SLDPRT
20.0 x 18.0 x 1600.0 mm
