burksbuilds/CNC-Router/Model/Solidworks CAD and Drawings/2-5in Coupler - 4880K133.SLDPRT

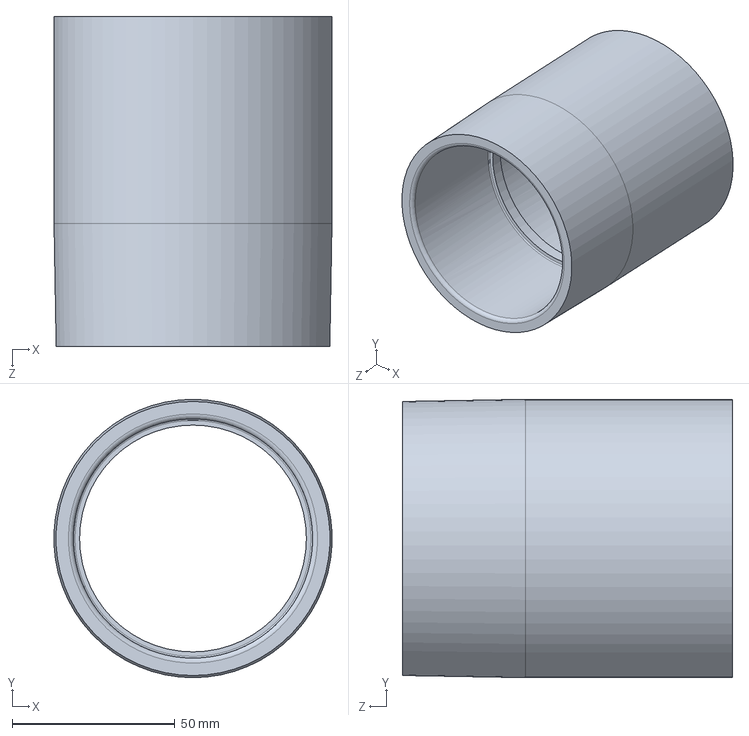
[picture p157: CAD file, 2022-01-21]
Model/Solidworks CAD and Drawings/2-5in Coupler - 4880K133.SLDPRT
85.3 x 85.4 x 101.3 mm
