burksbuilds/CNC-Router/Model/Solidworks CAD and Drawings/M8-SHLD10x16.SLDPRT

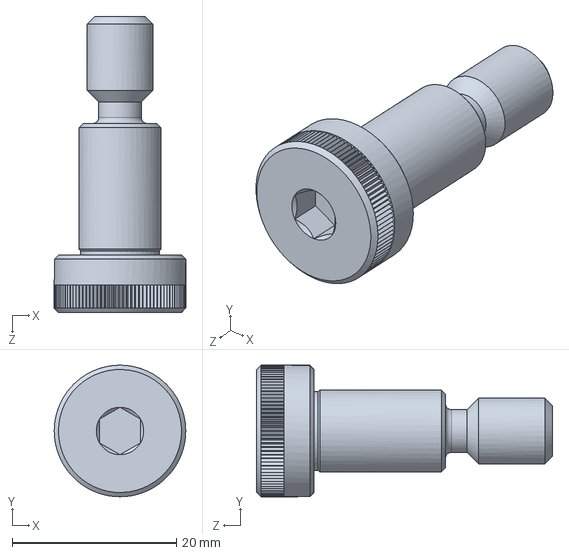
[picture p158: CAD file, 2022-01-21]
Model/Solidworks CAD and Drawings/M8-SHLD10x16.SLDPRT
16.0 x 16.0 x 36.0 mm
