burksbuilds/CNC-Router/Model/Solidworks CAD and Drawings/2-5in to 1-25 Reducing Tee - 4880K979.SLDPRT

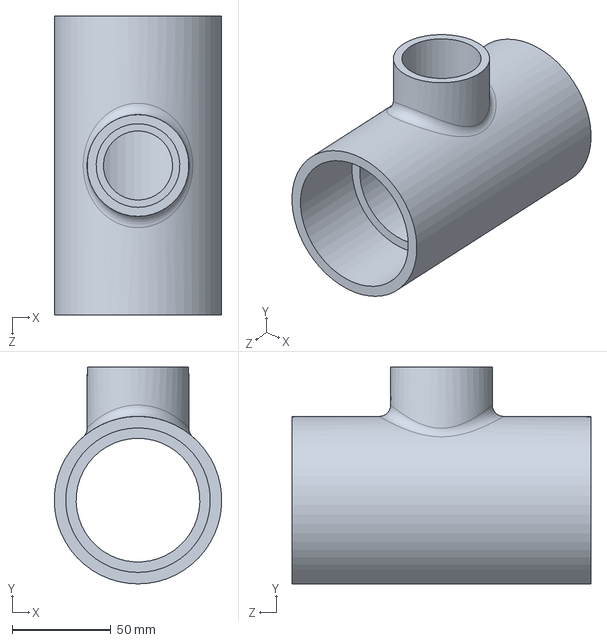
[picture p159: CAD file, 2022-01-21]
Model/Solidworks CAD and Drawings/2-5in to 1-25 Reducing Tee - 4880K979.SLDPRT
84.8 x 109.9 x 151.6 mm
