burksbuilds/CNC-Router/Model/Solidworks CAD and Drawings/pm-t65_step.step

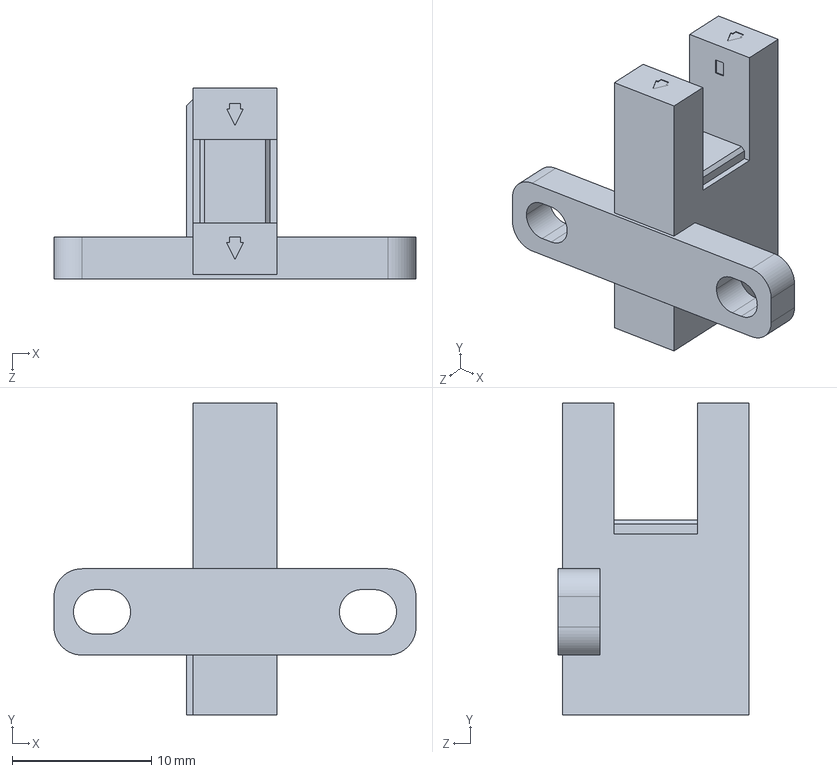
[picture p160: CAD file, 2022-01-21]
Model/Solidworks CAD and Drawings/pm-t65_step.step
26.0 x 22.4 x 13.7 mm
