burksbuilds/CNC-Router/Model/Solidworks CAD and Drawings/1in NPT Conduit Straight Connector - 7513K68.SLDPRT

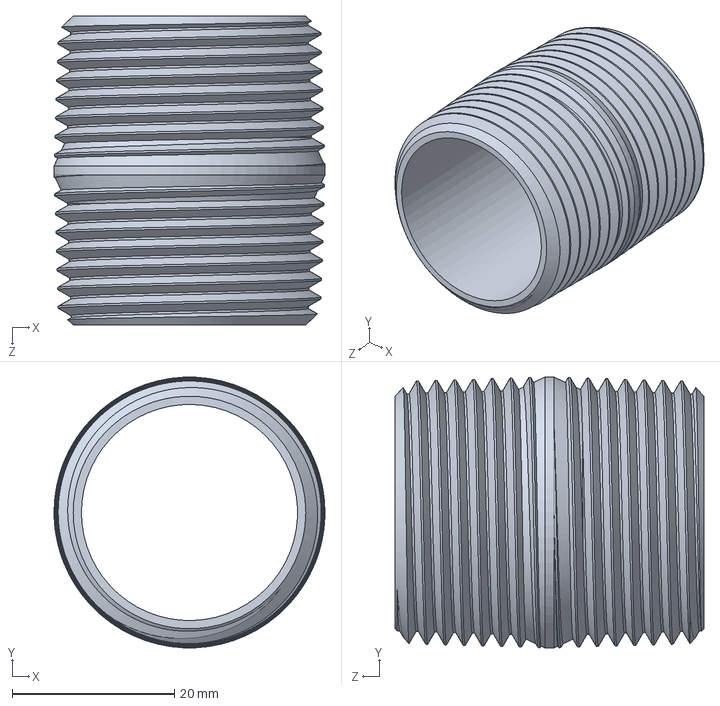
[picture p161: CAD file, 2022-01-21]
Model/Solidworks CAD and Drawings/1in NPT Conduit Straight Connector - 7513K68.SLDPRT
33.4 x 33.4 x 38.1 mm
