burksbuilds/CNC-Router/Model/Solidworks CAD and Drawings/CNCR-VACT.SLDASM

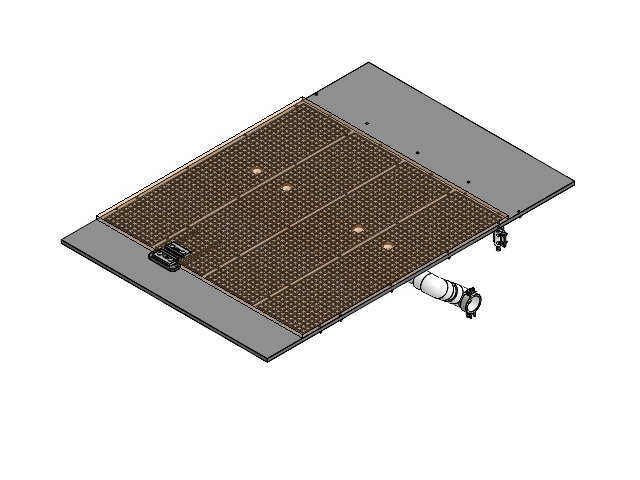
[picture p162: CAD file, 2022-09-07]
Model/Solidworks CAD and Drawings/CNCR-VACT.SLDASM
CNCR-VACT-PB
3in Blast Gate - 17385K72 x 3
2-5in Coupler - 4880K133
2-5in to 1-25 Reducing Tee - 4880K979 x 4
3in Pipe Hanger - 3006T84 x 5
2-5in Elbow - 4880K103 x 2
2-5in Cap - 4880K143
2-5in PVC Pipe, Schedule 40 x 4
M6-FLNUT x 4
M6x20mm-BHCS x 34
M6-TSN40-BALL x 42
M8x12mm-FBHCS
M8-TSN40-BALL
0-7-16 x 1-5in Single Acting Cylinder - Bimba 0115_NTQ x 3
Cylinder Mount x 3
M5-HNUT x 6
M5x16mm Flanged BHCS, 18-8 - 97654A663 x 6
M6x20mm FBHCS x 12
CNCR-VACT-SB
VISE-MODULAR-FIXED
VISE-MODULAR-FREE
