burksbuilds/CNC-Router/(list of files, cad)

Other CAD files:
Model/Solidworks CAD and Drawings/TOOL-BS20.SLDPRT
Model/Solidworks CAD and Drawings/VFD-5HP.SLDPRT
Model/Solidworks CAD and Drawings/CNCR-GANT-RT-FREE.SLDPRT
Model/Solidworks CAD and Drawings/CNCR-BASE-TSE-BL.SLDPRT
Model/Solidworks CAD and Drawings/VISE5.SLDPRT
Model/Solidworks CAD and Drawings/CHINA_Sensor Inductive Proximity_TL-W5M--_(nosticker nolabel).stp.SLDPRT
Model/Solidworks CAD and Drawings/CNCR-SPIN-SPE.SLDPRT
Model/Solidworks CAD and Drawings/RAIL20-400.SLDPRT
Model/Solidworks CAD and Drawings/Power Supply, 24V, 25A - Meanwell SE-600-24.SLDPRT
Model/Solidworks CAD and Drawings/M8-TSN40-BALL.SLDPRT
Model/Solidworks CAD and Drawings/1in Conduit Nut - 7513K121.SLDPRT
Model/Solidworks CAD and Drawings/3in Pipe Hanger - 3006T84.SLDPRT
Model/Solidworks CAD and Drawings/BALLSCREW1204-350.SLDPRT
Model/Solidworks CAD and Drawings/BALLSCREW2010-1500.SLDPRT
Model/Solidworks CAD and Drawings/BBM12.SLDDRW
Model/Solidworks CAD and Drawings/BBM15.SLDDRW
Model/Solidworks CAD and Drawings/BF12.SLDPRT
Model/Solidworks CAD and Drawings/BK10.SLDPRT
Model/Solidworks CAD and Drawings/BK15.SLDPRT
Model/Solidworks CAD and Drawings/BOXCOV-3x1,5.SLDPRT
Model/Solidworks CAD and Drawings/CNCR-BASE-BM12.SLDDRW
Model/Solidworks CAD and Drawings/CNCR-BASE-HS.SLDDRW
Model/Solidworks CAD and Drawings/CNCR-BASE-LSP.SLDDRW
Model/Solidworks CAD and Drawings/CNCR-BASE-MM.SLDDRW
Model/Solidworks CAD and Drawings/CNCR-BASE-SG.SLDDRW
Model/Solidworks CAD and Drawings/CNCR-BASE-TSE-CBM.SLDDRW
Model/Solidworks CAD and Drawings/CNCR-BASE-TSE-ECM.SLDDRW
Model/Solidworks CAD and Drawings/CNCR-BASE-TSE-ECM.SLDPRT
Model/Solidworks CAD and Drawings/CNCR-BASE-TSE-IBM.SLDDRW
Model/Solidworks CAD and Drawings/CNCR-BASE-TSE-IM.SLDDRW
Model/Solidworks CAD and Drawings/CNCR-BASE-TSE-OBM.SLDDRW
Model/Solidworks CAD and Drawings/CNCR-BASE-TSE-OM.SLDDRW
Model/Solidworks CAD and Drawings/CNCR-BASE-TSE-RM.SLDDRW
Model/Solidworks CAD and Drawings/CNCR-BBM.SLDDRW
Model/Solidworks CAD and Drawings/CNCR-BUMP.SLDDRW
Model/Solidworks CAD and Drawings/CNCR-CAR-BNM.SLDDRW
Model/Solidworks CAD and Drawings/CNCR-CAR-EC.SLDPRT
Model/Solidworks CAD and Drawings/CNCR-CAR-ECM.SLDDRW
Model/Solidworks CAD and Drawings/CNCR-CAR-MM.SLDDRW
Model/Solidworks CAD and Drawings/CNCR-CAR-PLATE.SLDDRW
Model/Solidworks CAD and Drawings/CNCR-CAR-TSE-AM.SLDPRT
Model/Solidworks CAD and Drawings/CNCR-CAR-TSE-ECM.SLDDRW
Model/Solidworks CAD and Drawings/CNCR-CAR-TSE-LPS.SLDDRW
Model/Solidworks CAD and Drawings/CNCR-CAR-TSE-SPS.SLDDRW
Model/Solidworks CAD and Drawings/CNCR-CAR-TSE-SS.SLDDRW
Model/Solidworks CAD and Drawings/CNCR-ELEC-BOX-TEMP.SLDDRW
Model/Solidworks CAD and Drawings/CNCR-ELEC-BOX.SLDDRW
Model/Solidworks CAD and Drawings/CNCR-ELEC-COL-RT.SLDDRW
Model/Solidworks CAD and Drawings/CNCR-ELEC-PANEL-CUT.SLDDRW
Model/Solidworks CAD and Drawings/CNCR-ELEC-PLATE.SLDDRW
Model/Solidworks CAD and Drawings/CNCR-ELEC-TEMPLATE.SLDDRW
Model/Solidworks CAD and Drawings/CNCR-GANT-BNM.SLDDRW
Model/Solidworks CAD and Drawings/CNCR-GANT-ECM.SLDDRW
Model/Solidworks CAD and Drawings/CNCR-GANT-RP.SLDDRW
Model/Solidworks CAD and Drawings/CNCR-GANT-RT-CABLE.SLDDRW
Model/Solidworks CAD and Drawings/CNCR-GANT-RT.SLDDRW
Model/Solidworks CAD and Drawings/CNCR-GANT-TSE-BEAM.SLDDRW
Model/Solidworks CAD and Drawings/CNCR-GANT-TSE-ECM.SLDDRW
Model/Solidworks CAD and Drawings/CNCR-HSM.SLDDRW
Model/Solidworks CAD and Drawings/CNCR-SPIN-CLAMP.SLDDRW
Model/Solidworks CAD and Drawings/CNCR-SPIN-HS.SLDDRW
Model/Solidworks CAD and Drawings/CNCR-SPIN-PLATE.SLDDRW
Model/Solidworks CAD and Drawings/CNCR-SPIN-TSE-AM.SLDDRW
Model/Solidworks CAD and Drawings/CNCR-SPIN-TSE-HSM.SLDDRW
Model/Solidworks CAD and Drawings/CNCR-SPIND-COOL.SLDPRT
Model/Solidworks CAD and Drawings/CNCR-STAND-BS.SLDDRW
Model/Solidworks CAD and Drawings/CNCR-STAND-FP.SLDDRW
Model/Solidworks CAD and Drawings/CNCR-STAND-GP.SLDDRW
Model/Solidworks CAD and Drawings/CNCR-STAND-LEG-WELD.SLDDRW
Model/Solidworks CAD and Drawings/CNCR-STAND-SS.SLDDRW
Model/Solidworks CAD and Drawings/CNCR-STAND-TSE-LEG.SLDDRW
Model/Solidworks CAD and Drawings/CNCR-TEMPLATE-10MM.SLDDRW
Model/Solidworks CAD and Drawings/Circuit Breaker, 2 Pole.SLDPRT
Model/Solidworks CAD and Drawings/HUB33-14.SLDPRT
Model/Solidworks CAD and Drawings/HUB33-8.SLDPRT
Model/Solidworks CAD and Drawings/LS-TB-T.SLDPRT
Model/Solidworks CAD and Drawings/M3x12mm-BHCS.SLDPRT
Model/Solidworks CAD and Drawings/M4x12mm BHCS.SLDPRT
Model/Solidworks CAD and Drawings/M5-HNUT.SLDPRT
Model/Solidworks CAD and Drawings/M5-TSN20-BALL.SLDPRT
Model/Solidworks CAD and Drawings/M5-TSN40-HAMMER.SLDPRT
Model/Solidworks CAD and Drawings/M5x16mm Flanged BHCS, 18-8 - 97654A663.SLDPRT
Model/Solidworks CAD and Drawings/M5x20mm-SHCS.SLDPRT
Model/Solidworks CAD and Drawings/M5x25mm BHCS, 18-8 - 92095A216.SLDPRT
Model/Solidworks CAD and Drawings/M5x30mm BHCS, 18-8 - 92095A218.SLDPRT
Model/Solidworks CAD and Drawings/M6-RIVNUT.SLDPRT
Model/Solidworks CAD and Drawings/M6x16mm-SHFS.SLDPRT
Model/Solidworks CAD and Drawings/M6x20mm FBHCS.SLDPRT
Model/Solidworks CAD and Drawings/M6x20mm-BHCS.SLDPRT
Model/Solidworks CAD and Drawings/M6x25mm FBHCS.SLDPRT
Model/Solidworks CAD and Drawings/M6x40mm-SHCS.SLDPRT
Model/Solidworks CAD and Drawings/M8-M12-INSERT.SLDPRT
Model/Solidworks CAD and Drawings/M8-WASHER.SLDPRT
Model/Solidworks CAD and Drawings/M8x12mm-FBHCS.SLDPRT
Model/Solidworks CAD and Drawings/M8x20mm-FBHCS.SLDPRT
Model/Solidworks CAD and Drawings/M8x25mm-FBHCS.SLDPRT
Model/Solidworks CAD and Drawings/M8x40mm SHCS, 18-8 - 91292A152.SLDPRT
Model/Solidworks CAD and Drawings/M8x60mm-FBHCS.SLDPRT
Model/Solidworks CAD and Drawings/NEMA34-11.SLDPRT
Model/Solidworks CAD and Drawings/RAIL20-1200.SLDPRT
Model/Solidworks CAD and Drawings/ROPE-STEEL-48in.SLDPRT
Model/Solidworks CAD and Drawings/SCREW1610-1000.SLDPRT
Model/Solidworks CAD and Drawings/TSECOV-4080.SLDPRT
Model/Solidworks CAD and Drawings/Thrust Bearing, 1in Pipe - 5906K582.SLDPRT
