burksbuilds/CNC-Router/(commit log)

2022-01-21 Initial Commit
    End of design phase, see https://burksbuilds.com/?p=513
    [0-7-16 x 1-5in Single Acting Cylinder - Bimba 0115_NTQ.SLDPRT, 1-375in Grommet - 63595K33.SLDPRT, 1in Conduit Nut - 7513K121.SLDPRT, 1in NPT Conduit Straight Connector - 7513K68.SLDPRT, 2-5in Cap - 4880K143.SLDPRT, 2-5in Coupler - 4880K133.SLDPRT, 2-5in Elbow - 4880K103.SLDPRT, 2-5in PVC Pipe, Schedule 40.SLDPRT]
2022-02-03 CNCR-BASE preliminary release
    released CNCR-BASE prelim drawing, and all CNCR-BASE-TSR-* rev A drawings
    [0-7-16 x 1-5in Single Acting Cylinder - Bimba 0115_NTQ.SLDPRT, 2-5in PVC Pipe, Schedule 40.SLDPRT, 5 inch mill vise.stp.SLDPRT, Analysis.xlsx, BBM12.SLDPRT, BBM15.SLDPRT, CHINA_Sensor Inductive Proximity_TL-W5M--_(nosticker nolabel).stp.SLDPRT, CNCR-BASE-BM12.SLDDRW]
2022-03-06 Initial 4x4 Support
    [Analysis.xlsx, BALLSCREW2010-1500.SLDPRT, BBM12.SLDDRW, BBM12.SLDPRT, BBM15.SLDDRW, BBM15.SLDPRT, BOM.xlsx, CNCR-BASE-HS.SLDDRW]
2022-04-20 Added more drawings
    [Analysis.xlsx, CNCR-BASE-TSE-ECM.SLDDRW, CNCR-CAR-ECM.SLDDRW, CNCR-CAR-ECM.SLDPRT, CNCR-CAR-PLATE.SLDDRW, CNCR-CAR-PLATE.SLDPRT, CNCR-CAR-TSE-ECM.SLDDRW, CNCR-CAR-TSE-ECM.SLDPRT]
2022-08-01 Finished Mechanical Assembly
    [0-75ID Grommet - 9600K94.SLDPRT, 1-375in Grommet - 63595K33.SLDPRT, 1-50ID Grommet.SLDPRT, BALLNUT12-MOUNT.SLDPRT, BALLNUT1610.SLDPRT, BEARING20.SLDPRT, BOXCOV-6x2.SLDPRT, CABLE-GLAND25.SLDPRT]
2022-09-07 Controls V0 Release
    V0 release of control schematic designspark file
    updates to auxiliary files
    [CNC_electrical.xlsx]
2022-09-07 electrical cabinet layout
    physical design for electrical component mounting complete
    [CNCR-ELEC-BOX-TEMP.SLDDRW, CNCR-ELEC-BOX.SLDDRW, CNCR-ELEC-BOX.SLDPRT, CNCR-ELEC-COL-RT.SLDDRW, CNCR-ELEC-COL-RT.SLDPRT, CNCR-ELEC-COL.SLDASM, CNCR-ELEC-ENC.SLDASM, CNCR-ELEC-HMI.SLDPRT]
